brensch/coffee/hardware/controller/sim/REPORT.md

# Circuit simulation report

ngspice 42, behavioural models fitted to datasheet values (see `sim/run.py`). Generated by `python3 sim/run.py`.

| Block | Case | Result | Requirement | |
|---|---|---|---|---|
| Output on: voltage across the module input | heater SSR (Schneider SSP1A125BDT, 3.0 V), GPIO 2.64 V, vth_typ, +5V 4.65 V | 4.65 V | >= 3.0 V | ✅ |
| Output on: voltage across the module input | heater SSR (Schneider SSP1A125BDT, 3.0 V), GPIO 2.64 V, vth_typ, +5V 5.1 V | 5.1 V | >= 3.0 V | ✅ |
| Output on: voltage across the module input | heater SSR (Schneider SSP1A125BDT, 3.0 V), GPIO 2.64 V, vth_max, +5V 4.65 V | 4.65 V | >= 3.0 V | ✅ |
| Output on: voltage across the module input | heater SSR (Schneider SSP1A125BDT, 3.0 V), GPIO 2.64 V, vth_max, +5V 5.1 V | 5.1 V | >= 3.0 V | ✅ |
| Output on: voltage across the module input | heater SSR (Schneider SSP1A125BDT, 3.0 V), GPIO 3.3 V, vth_typ, +5V 4.65 V | 4.65 V | >= 3.0 V | ✅ |
| Output on: voltage across the module input | heater SSR (Schneider SSP1A125BDT, 3.0 V), GPIO 3.3 V, vth_typ, +5V 5.1 V | 5.1 V | >= 3.0 V | ✅ |
| Output on: voltage across the module input | heater SSR (Schneider SSP1A125BDT, 3.0 V), GPIO 3.3 V, vth_max, +5V 4.65 V | 4.65 V | >= 3.0 V | ✅ |
| Output on: voltage across the module input | heater SSR (Schneider SSP1A125BDT, 3.0 V), GPIO 3.3 V, vth_max, +5V 5.1 V | 5.1 V | >= 3.0 V | ✅ |
| Output off: current left through the module input | heater SSR (Schneider SSP1A125BDT, 3.0 V) | 0 mA | < 0.1 mA (SSR must-release ~1 mA) | ✅ |
| Output turn-off spike at the drain | heater SSR (Schneider SSP1A125BDT, 3.0 V) | 4.35 V | < 20 V (AO3400A 30 V rating; resistive SSR input, no flyback diode) | ✅ |
| Opto-triac LED current (MOC3083: IFT 5 mA max, IF 50 mA abs max) | GPIO 2.64 V, vth_typ, +5V 4.65 V, Vf 1.5 V max | 9.82 mA | >= 7.5 mA (1.5x IFT max) and <= 30 mA | ✅ |
| Opto-triac LED current (MOC3083: IFT 5 mA max, IF 50 mA abs max) | GPIO 2.64 V, vth_typ, +5V 5.1 V, Vf 1.5 V max | 11.1 mA | >= 7.5 mA (1.5x IFT max) and <= 30 mA | ✅ |
| Opto-triac LED current (MOC3083: IFT 5 mA max, IF 50 mA abs max) | GPIO 2.64 V, vth_max, +5V 4.65 V, Vf 1.5 V max | 9.82 mA | >= 7.5 mA (1.5x IFT max) and <= 30 mA | ✅ |
| Opto-triac LED current (MOC3083: IFT 5 mA max, IF 50 mA abs max) | GPIO 2.64 V, vth_max, +5V 5.1 V, Vf 1.5 V max | 11.1 mA | >= 7.5 mA (1.5x IFT max) and <= 30 mA | ✅ |
| Opto-triac LED current (MOC3083: IFT 5 mA max, IF 50 mA abs max) | GPIO 3.3 V, vth_typ, +5V 4.65 V, Vf 1.5 V max | 9.82 mA | >= 7.5 mA (1.5x IFT max) and <= 30 mA | ✅ |
| Opto-triac LED current (MOC3083: IFT 5 mA max, IF 50 mA abs max) | GPIO 3.3 V, vth_typ, +5V 5.1 V, Vf 1.5 V max | 11.1 mA | >= 7.5 mA (1.5x IFT max) and <= 30 mA | ✅ |
| Opto-triac LED current (MOC3083: IFT 5 mA max, IF 50 mA abs max) | GPIO 3.3 V, vth_max, +5V 4.65 V, Vf 1.5 V max | 9.82 mA | >= 7.5 mA (1.5x IFT max) and <= 30 mA | ✅ |
| Opto-triac LED current (MOC3083: IFT 5 mA max, IF 50 mA abs max) | GPIO 3.3 V, vth_max, +5V 5.1 V, Vf 1.5 V max | 11.1 mA | >= 7.5 mA (1.5x IFT max) and <= 30 mA | ✅ |
| Opto-triac LED off | FET off | 5.58e-10 mA | < 0.1 mA (far below any trigger) | ✅ |
| Output during reset (GPIO high-Z) | internal pull-up 45k vs 3.3k pull-down | 0.225 V | < 0.6 V (AO3400A Vth min 0.65 V): load stays off | ✅ |
| Output during reset: module input current | internal pull-up 45k | 3.81e-09 mA | < 0.1 mA (off) | ✅ |
| Output during reset (GPIO high-Z) | internal pull-up 20k vs 3.3k pull-down | 0.467 V | < 0.6 V (AO3400A Vth min 0.65 V): load stays off | ✅ |
| Output during reset: module input current | internal pull-up 20k | 3.81e-09 mA | < 0.1 mA (off) | ✅ |
| Output during reset, 100k pull-down (rejected value) | internal pull-up 45k | 2.28 V | reference only: why the pull-down is 3.3k | ✅ |
| Pump triac turn-off: peak voltage (reference) | 120 V, no snubber | 1.12e+03 V | info: why the snubber is fitted | ✅ |
| Valve triac (T410) turn-off: peak voltage (reference) | 120 V, no snubber | 2.89e+03 V | info: why the snubber is fitted | ✅ |
| Pump triac (T435) turn-off: peak voltage | 120 V, 100 R + 22 nF X2 | 169 V | < 480 V (80 % of the T435's 600 V) | ✅ |
| Pump triac turn-off: dV/dt | 120 V, 100 R + 22 nF X2 | 47 V/us | < 100 V/us (T435 static 400 V/us; MOC3083 static >= 600 V/us) | ✅ |
| Valve triac (T410-800B) turn-off: peak voltage | 120 V, 100 R + 22 nF X2 | 429 V | < 640 V (80 % of the T410-800B's 800 V; v49) | ✅ |
| Valve triac (T410) turn-off: dV/dt | 120 V, 100 R + 22 nF X2 | 23.2 V/us | < 32 V/us (80 % of the T410's 40 V/us; MOC3083 static >= 600 V/us) | ✅ |
| Pump triac turn-off: peak voltage (reference) | 132 V, no snubber | 1.12e+03 V | info: why the snubber is fitted | ✅ |
| Valve triac (T410) turn-off: peak voltage (reference) | 132 V, no snubber | 2.91e+03 V | info: why the snubber is fitted | ✅ |
| Pump triac (T435) turn-off: peak voltage | 132 V, 100 R + 22 nF X2 | 186 V | < 480 V (80 % of the T435's 600 V) | ✅ |
| Pump triac turn-off: dV/dt | 132 V, 100 R + 22 nF X2 | 47 V/us | < 100 V/us (T435 static 400 V/us; MOC3083 static >= 600 V/us) | ✅ |
| Valve triac (T410-800B) turn-off: peak voltage | 132 V, 100 R + 22 nF X2 | 456 V | < 640 V (80 % of the T410-800B's 800 V; v49) | ✅ |
| Valve triac (T410) turn-off: dV/dt | 132 V, 100 R + 22 nF X2 | 23.2 V/us | < 32 V/us (80 % of the T410's 40 V/us; MOC3083 static >= 600 V/us) | ✅ |
| Pump zero-cross re-arm (reference) | 120 V, after one stroke, no bleeder (v32) | 168 V | info: review M1 (no bleeder) and its re-review (100k marginal when running) | ✅ |
| Pump zero-cross re-arm (reference) | 120 V, after one stroke, 100k (first v33 value, rejected) | 1.09 V | info: review M1 (no bleeder) and its re-review (100k marginal when running) | ✅ |
| Pump zero-cross re-arm: triac voltage just before each positive zero crossing | 120 V, after one stroke, 51k bleeder (R54) | 0.0422 V | < 5 V (MOC3083 fires only under VINH: 12 V typ, 20 V max, no minimum) | ✅ |
| Pump zero-cross re-arm (reference) | 120 V, running every cycle, 100k (first v33 value, rejected) | 13.6 V | info: review M1 (no bleeder) and its re-review (100k marginal when running) | ✅ |
| Pump zero-cross re-arm: triac voltage just before each positive zero crossing | 120 V, running every cycle, 51k bleeder (R54) | 1.79 V | < 5 V (MOC3083 fires only under VINH: 12 V typ, 20 V max, no minimum) | ✅ |
| Pump zero-cross re-arm (reference) | 132 V, after one stroke, no bleeder (v32) | 185 V | info: review M1 (no bleeder) and its re-review (100k marginal when running) | ✅ |
| Pump zero-cross re-arm (reference) | 132 V, after one stroke, 100k (first v33 value, rejected) | 1.2 V | info: review M1 (no bleeder) and its re-review (100k marginal when running) | ✅ |
| Pump zero-cross re-arm: triac voltage just before each positive zero crossing | 132 V, after one stroke, 51k bleeder (R54) | 0.0423 V | < 5 V (MOC3083 fires only under VINH: 12 V typ, 20 V max, no minimum) | ✅ |
| Pump zero-cross re-arm (reference) | 132 V, running every cycle, 100k (first v33 value, rejected) | 13.2 V | info: review M1 (no bleeder) and its re-review (100k marginal when running) | ✅ |
| Pump zero-cross re-arm: triac voltage just before each positive zero crossing | 132 V, running every cycle, 51k bleeder (R54) | 1.82 V | < 5 V (MOC3083 fires only under VINH: 12 V typ, 20 V max, no minimum) | ✅ |
| Pump bleeder dissipation (R54, 2512 1 W) | 132 V, half-wave while the pump is off | 171 mW | < 250 mW (25 % of 1 W) | ✅ |
| Pump bleeder voltage (R54) | 132 V line peak (the triac's off-state voltage) | 187 V | < 400 V (80 % of the CRCW2512's 500 V) | ✅ |
| Valve triac (T410-800B) turn-off: peak voltage | 132 V, weaker coil: 6 H, 400 R (~57 mA) | 481 V | < 640 V (80 % of 800 V; the 600 V part's limit was 480 V) | ✅ |
| Valve triac (T410-800B) turn-off: dV/dt | 132 V, weaker coil: 6 H, 400 R (~57 mA) | 23.8 V/us | < 32 V/us (80 % of the T410's 40 V/us) | ✅ |
| Valve triac (T410-800B) turn-off: peak voltage | 132 V, weaker coil: 8 H, 500 R (~43 mA) | 510 V | < 640 V (80 % of 800 V; the 600 V part's limit was 480 V) | ✅ |
| Valve triac (T410-800B) turn-off: dV/dt | 132 V, weaker coil: 8 H, 500 R (~43 mA) | 24.2 V/us | < 32 V/us (80 % of the T410's 40 V/us) | ✅ |
| Valve triac (T410-800B) turn-off: peak voltage | 132 V, weaker coil: 12 H, 600 R (~29 mA) | 561 V | < 640 V (80 % of 800 V; the 600 V part's limit was 480 V) | ✅ |
| Valve triac (T410-800B) turn-off: dV/dt | 132 V, weaker coil: 12 H, 600 R (~29 mA) | 24.5 V/us | < 32 V/us (80 % of the T410's 40 V/us) | ✅ |
| Opto peak current through R49/R50 (200 R) | 132 V line peak, fired at the peak (dV/dt mis-fire) | 0.933 A | < 1 A (MOC3083 ITSM) | ✅ |
| Triac voltage needed to fire through the opto | Valve (T410, IGT 10 mA max), 200 R | 6.3 V | < 12 V (MOC3083 inhibit voltage, typ; the valve re-fires at every current zero; 330 R needed 7.6 V) | ✅ |
| Triac voltage needed to fire through the opto | Pump (T435, IGT 35 mA max), 200 R | 11.3 V | info: the pump fires on a rising line with the opto already latched, so the inhibit voltage doesn't limit it (330 R needed 15.9 V) | ✅ |
| Valve with a T435 instead (rejected) | 132 V, IH 35 mA, 100 R + 22 nF | 690 V | reference: over the 600 V rating, why the valve uses the T410 | ✅ |
| Snubber off-state leakage | 22 nF at 120 V 60 Hz | 0.995 mA | < 2 mA (valve hold-in needs ~50 mA; pump coil ignores it) | ✅ |
| Snubber discharge into the triac at turn-on | 170 V peak / 100 R | 1.7 A | < 31 A (T435 ITSM) and < 4 A di/dt-friendly | ✅ |
| Snubber resistor dissipation | steady off-state | 0.0991 mW | < 100 mW (2512 1 W) | ✅ |
| Pump triac (T435) junction temperature | pump 0.45 A rms half-wave (0.9 A peak) | 86.8 C | < 115 C (Tj max 125 C, 10 C margin) | ✅ |
| Pump triac (T435) junction temperature | pump, 1.4 A peak allowance | 97.3 C | < 115 C (Tj max 125 C, 10 C margin) | ✅ |
| Valve triac (T410) junction temperature | 0.1 A rms full-wave | 74.9 C | < 115 C | ✅ |
| IRM-10-5 load vs derating | 70 C: 50 % of 2 A = 1.0 A (Mean Well derating curve) | 0.45 A | <= 1.0 A (peak, Wi-Fi + both opto LEDs + heater SSR) | ✅ |
| LDO (TLV1117LV, SOT-223) junction temperature | 1.7 V x 150 mA average, ~100 C/W on its copper | 95.5 C | < 115 C (Tj max 125 C) | ✅ |
| Opto LED resistor dissipation (R47/R48, 0603) | 11 mA | 39.9 mW | < 50 mW (0603 100 mW, half derated at 70 C) | ✅ |
| Board fuse (F1, 2 A slow-blow) continuous load | IRM 0.12 A + pump 0.45 A + valve 0.1 A | 0.67 A | < 1.45 A (2 A x 0.75 x 0.97 rerating at 70 C) | ✅ |
| Thermocouple signal range | tip 170 C, board 20 C (K-type ~41 uV/C) | 6.15 mV | < 256 mV (MCP3421 PGA 8 full scale) | ✅ |
| Thermocouple open-probe reading | 10M bias vs ~281k ADC input (PGA 8) | 90.2 mV | > 15 mV (firmware: open probe) and < 256 mV (in range) | ✅ |
| Thermocouple bias error | 0.33 uA through a 20-ohm probe loop | 0.161 C | < 0.3 C (constant; calibration removes it) | ✅ |
| Status LED (red, 1k from GPIO16 / U0TXD) | 3.3 V | 1.3 mA | 1-3 mA (visible, well within GPIO drive) | ✅ |
| Front-panel switch closed | 1k series, 10k || 45k pull-up | 0.359 V | <= 0.5 V (C6 VIL max 0.25 x VDD = 0.825 V: >= 0.3 V margin) | ✅ |
| Front-panel switch wetting current | closed | 0.359 mA | >= 0.2 mA (keeps an old rocker's contacts clean) | ✅ |
| Front-panel LED drive | 330 R from a 3.3 V GPIO, red LED Vf ~2.0 V | 3.94 mA | 2-8 mA (bright, within the C6's 20 mA drive) | ✅ |
| Pressure input | 4.5 V full scale -> GPIO0 | 3.06 V | <= 3.1 V (inside the C6 ADC's 12 dB range, below the 3.3 V rail) | ✅ |
| Pressure input | 0.5 V (0 bar) -> GPIO0 | 0.34 V | >= 0.1 V (clear of the ADC's non-linear bottom) | ✅ |
| Pressure transducer load | R16 + R17 | 147 kOhm | > 100 kOhm (any 0.5-4.5 V voltage-output transducer; XIDIBEI drives ~10 mA) | ✅ |
| Pressure filter | -3 dB corner | 257 Hz | 150-400 Hz (keeps the pump's 60 Hz pulses, kills RF) | ✅ |
| Pressure filter | 60 Hz pump ripple | -0.296 dB | > -1 dB (the pulses stay visible to firmware) | ✅ |
| Pressure ADC kick-back (estimate) | 10 pF sample cap (assumed) vs 22 nF | 1.36 mV | < 2.7 mV (1/10 of the transducer's +-0.25 % FS at the pin) | ✅ |
| Pressure gain error from 1 % divider resistors | worst-case ratio | 0.0573 bar | < 0.15 bar at 9 bar (zero is calibrated at power-up) | ✅ |
| 3.3 V rail under Wi-Fi bursts | IRM-10-5 5.0 V | 3.29 V | >= 3.0 V (ESP32-C6 min) | ✅ |
| 5 V rail | IRM-10-5 5.0 V | 4.88 V | >= 4.2 V (info: on USB the transducer runs below the 4.75 V a 5 V part is usually specified for; readings indicative) | ✅ |
| 3.3 V rail under Wi-Fi bursts | IRM-10-5 4.9 V (-2 %) | 3.29 V | >= 3.0 V (ESP32-C6 min) | ✅ |
| 5 V rail | IRM-10-5 4.9 V (-2 %) | 4.78 V | >= 4.2 V (info: on USB the transducer runs below the 4.75 V a 5 V part is usually specified for; readings indicative) | ✅ |
| 3.3 V rail under Wi-Fi bursts | USB 5.0 V through D2 (~4.65 V) | 3.29 V | >= 3.0 V (ESP32-C6 min) | ✅ |
| 5 V rail | USB 5.0 V through D2 (~4.65 V) | 4.53 V | >= 4.2 V (info: on USB the transducer runs below the 4.75 V a 5 V part is usually specified for; readings indicative) | ✅ |

**88 / 88 checks pass.**
