brensch/coffee/hardware/controller/cosim/REPORT.md

# Co-simulation: firmware bits -> opto -> triac -> mains load

Source: `cosim_trace.csv` from `cosim_120v.scn` (the coffee-node engine, 120 V model): 32401 mains cycles; heater on 6866, pump on 1205, valve open 1784 cycles.

## Drive margins

- GPIO -> 150 R -> LED at the worst corner (VOH 2.64 V, pin 25.0 R, Vf 1.5 V): **I_F = 6.51 mA** vs IFT max 5 mA: OK
- heater (BTA24-800BW): the opto latches at ~5 V (inside its 20 V zero-cross window) and the gate reaches IGT 50 mA at **21.1 V** line, 7.9 deg into the half-cycle at 108 V: OK
- pump (BTA08-800BW): the opto latches at ~5 V (inside its 20 V zero-cross window) and the gate reaches IGT 50 mA at **21.1 V** line, 7.9 deg into the half-cycle at 108 V: OK
- valve (Z0109NN): the opto latches at ~5 V (inside its 20 V zero-cross window) and the gate reaches IGT 10 mA at **6.7 V** line, 2.5 deg into the half-cycle at 108 V: OK

## Heater (resistive, 1200 W)

| mains | f (Hz) | xtal ppm | latency | cycles cmd | half-cycles | +/- | runs off by >1 half | worst run DC (halves) | energy error |
|---|---|---|---|---|---|---|---|---|---|
| 108 | 59.95 | -10 | 20 us | 6866 | 13805 | 6901/6904 | 2 / 2703 | 1 | +0.62 % |
| 108 | 59.95 | +0 | 20 us | 6866 | 13803 | 6902/6901 | 2 / 2703 | 1 | +0.60 % |
| 108 | 59.95 | +10 | 300 us | 6866 | 13802 | 6901/6901 | 2 / 2703 | 1 | +0.59 % |
| 108 | 60.0 | -10 | 300 us | 6866 | 13732 | 6866/6866 | 0 / 2703 | 0 | +0.00 % |
| 108 | 60.0 | +0 | 20 us | 6866 | 13732 | 6866/6866 | 0 / 2703 | 0 | +0.00 % |
| 108 | 60.0 | +10 | 20 us | 6866 | 13732 | 6866/6866 | 0 / 2703 | 0 | +0.00 % |
| 108 | 60.05 | -10 | 300 us | 6866 | 13829 | 6912/6917 | 2 / 2703 | 1 | +0.62 % |
| 108 | 60.05 | +0 | 20 us | 6866 | 13827 | 6911/6916 | 2 / 2703 | 1 | +0.61 % |
| 108 | 60.05 | +10 | 300 us | 6866 | 13828 | 6912/6916 | 2 / 2703 | 1 | +0.62 % |
| 120 | 59.95 | -10 | 20 us | 6866 | 13796 | 6897/6899 | 2 / 2703 | 1 | +0.55 % |
| 120 | 59.95 | +0 | 20 us | 6866 | 13799 | 6901/6898 | 2 / 2703 | 1 | +0.57 % |
| 120 | 59.95 | +10 | 20 us | 6866 | 13801 | 6903/6898 | 2 / 2703 | 1 | +0.59 % |
| 120 | 60.0 | -10 | 20 us | 6866 | 13932 | 7066/6866 | 0 / 2703 | 1 | +1.46 % |
| 120 | 60.0 | +0 | 300 us | 6866 | 13732 | 6866/6866 | 0 / 2703 | 0 | +0.00 % |
| 120 | 60.0 | +10 | 300 us | 6866 | 13801 | 6866/6935 | 0 / 2703 | 1 | +0.50 % |
| 120 | 60.05 | -10 | 20 us | 6866 | 13816 | 6907/6909 | 2 / 2703 | 1 | +0.53 % |
| 120 | 60.05 | +0 | 300 us | 6866 | 13822 | 6911/6911 | 2 / 2703 | 1 | +0.57 % |
| 120 | 60.05 | +10 | 300 us | 6866 | 13821 | 6912/6909 | 2 / 2703 | 1 | +0.56 % |
| 132 | 59.95 | -10 | 20 us | 6866 | 13793 | 6899/6894 | 2 / 2703 | 1 | +0.53 % |
| 132 | 59.95 | +0 | 300 us | 6866 | 13795 | 6899/6896 | 2 / 2703 | 1 | +0.54 % |
| 132 | 59.95 | +10 | 300 us | 6866 | 13791 | 6895/6896 | 2 / 2703 | 1 | +0.51 % |
| 132 | 60.0 | -10 | 20 us | 6866 | 13763 | 6866/6897 | 0 / 2703 | 1 | +0.23 % |
| 132 | 60.0 | +0 | 300 us | 6866 | 13732 | 6866/6866 | 0 / 2703 | 0 | +0.00 % |
| 132 | 60.0 | +10 | 300 us | 6866 | 13732 | 6866/6866 | 0 / 2703 | 0 | +0.00 % |
| 132 | 60.05 | -10 | 300 us | 6866 | 13813 | 6905/6908 | 2 / 2703 | 1 | +0.51 % |
| 132 | 60.05 | +0 | 20 us | 6866 | 13809 | 6904/6905 | 2 / 2703 | 1 | +0.48 % |
| 132 | 60.05 | +10 | 300 us | 6866 | 13817 | 6908/6909 | 2 / 2703 | 1 | +0.54 % |

## Pump (Ulka, diode inside: one stroke per positive half-cycle)

| mains | f (Hz) | xtal ppm | cycles cmd | strokes | error | cycles with 0 / 1 / 2 strokes |
|---|---|---|---|---|---|---|
| 120 | 59.95 | -10 | 1205 | 1210 | +0.41 % | 59 / 1146 / 0 |
| 120 | 59.95 | +0 | 1205 | 1210 | +0.41 % | 7 / 1198 / 0 |
| 120 | 59.95 | +10 | 1205 | 1214 | +0.75 % | 62 / 1143 / 0 |
| 120 | 60.0 | -10 | 1205 | 1205 | +0.00 % | 0 / 1205 / 0 |
| 120 | 60.0 | +0 | 1205 | 1205 | +0.00 % | 0 / 1205 / 0 |
| 120 | 60.0 | +10 | 1205 | 1205 | +0.00 % | 0 / 1205 / 0 |
| 120 | 60.05 | -10 | 1205 | 1213 | +0.66 % | 55 / 1149 / 1 |
| 120 | 60.05 | +0 | 1205 | 1213 | +0.66 % | 5 / 1199 / 1 |
| 120 | 60.05 | +10 | 1205 | 1216 | +0.91 % | 61 / 1143 / 1 |

## Valve (inductive solenoid, 100 R + 8 nF snubber, 1 us backward-Euler ODE)

| mains | f (Hz) | opto t_on | coil I rms | DC / rms (skipped halves show as DC) | extra after release | turn-off dv/dt |
|---|---|---|---|---|---|---|
| 108 | 59.95 | 0 us | 133 mA | 0.0 % | 0 | 8.8 V/us |
| 108 | 59.95 | 5 us | 132 mA | 0.1 % | 0 | 8.7 V/us |
| 108 | 59.95 | 20 us | 119 mA | 0.1 % | 0 | 8.3 V/us |
| 120 | 59.95 | 0 us | 147 mA | 0.1 % | 0 | 8.8 V/us |
| 120 | 60.05 | 5 us | 147 mA | 0.1 % | 0 | 7.7 V/us |
| 120 | 60.05 | 20 us | 132 mA | 0.1 % | 0 | 4.5 V/us |
| 132 | 60.05 | 0 us | 162 mA | 0.1 % | 0 | 8.8 V/us |
| 132 | 59.95 | 5 us | 162 mA | 0.1 % | 0 | 8.6 V/us |
| 132 | 59.95 | 20 us | 145 mA | 0.1 % | 0 | 3.5 V/us |

## Verdict

- Heater energy error, worst corner: 1.46 %.
- Pump stroke-count error, worst corner: 0.91 %; commanded cycles with 0 or 2 strokes: 252 over all corners.
- Overall: **PASS**
