brensch/coffee/hardware/controller/build/jlc-120v-2side/report.md

# JLCPCB parts, 120 V board

Looked up live in JLCPCB's library. 'base' = basic part (no setup fee), 'expand' = extended (~$3 setup per part type). Check rotations in JLC's placement preview: footprint zero orientations differ between KiCad and JLC for some packages (SOT-223, USB-C, the ESP32 module).

| Refs | Value | JLC part | LCSC | library | stock | who |
|---|---|---|---|---|---|---|
| C3 | 10uF 25V X5R | CL21A106KAYNNNE | C15850 | base | 7586193 | JLC |
| C4 C8 C10 C11 | 100nF X7R | CC0603KRX7R9BB104 | C14663 | base | 37054978 | JLC |
| C5 | 1uF X5R | CL10A105KB8NNNC | C15849 | base | 12051593 | JLC |
| C6 C7 | 22uF 25V X5R | CL21A226MAQNNNE | C45783 | base | 3554401 | JLC |
| C9 | 22nF X7R | CL10B223KB8NNNC | C21122 | base | 854610 | JLC |
| D1 | red | KT-0603R | C2286 | base | 6705373 | JLC |
| D2 | B5819W | B5819W SL | C8598 | base | 803125 | JLC |
| D5 | 1N4148W | 1N4148W | C81598 | base | 3681312 | JLC |
| J1 | 5V in | SM03B-GHS-TB(LF)(SN) | C514175 | expand | 33212 | JLC |
| J2 | Heater | SM03B-GHS-TB(LF)(SN) | C514175 | expand | 33212 | JLC |
| J3 | Pump | SM03B-GHS-TB(LF)(SN) | C514175 | expand | 33212 | JLC |
| J4 | USB-C | TYPE-C-31-M-12 | C165948 | expand | 154346 | JLC |
| J5 | Thermistor | SM03B-GHS-TB(LF)(SN) | C514175 | expand | 33212 | JLC |
| J6 | Pressure | SM03B-GHS-TB(LF)(SN) | C514175 | expand | 33212 | JLC |
| J7 | Front panel | SM07B-GHS-TB(LF)(SN) | C495552 | expand | 26135 | JLC |
| J8 | Valve | SM03B-GHS-TB(LF)(SN) | C514175 | expand | 33212 | JLC |
| J10 | Scale | SM06B-GHS-TB(LF)(SN) | C133065 | expand | 20530 | JLC |
| Q1 Q2 Q3 | AO3400A | AO3400A | C20917 | base | 938699 | JLC |
| Q4 | AO3401A | AO3401A | C15127 | base | 1622342 | JLC |
| R4 R5 R6 | 3.3k | 0603WAF3301T5E | C22978 | base | 4833385 | JLC |
| R10 R11 R22 R23 R25 R26 R36 | 10k | 0603WAF1002T5E | C25804 | base | 44148883 | JLC |
| R12 R18 R19 R27 R29 | 1k | 0603WAF1001T5E | C21190 | base | 28279663 | JLC |
| R13 R14 | 5.1k | 0603WAF5101T5E | C23186 | base | 20602161 | JLC |
| R15 R20 R21 R28 | 4.7k | 0603WAF4701T5E | C23162 | base | 13794891 | JLC |
| R16 | 47k | 0603WAF4702T5E | C25819 | base | 2596167 | JLC |
| R17 | 100k | 0603WAF1003T5E | C25803 | base | 16705988 | JLC |
| R24 | 20k | 0603WAF2002T5E | C4184 | base | 5892313 | JLC |
| R30 R31 R32 | 330 | 0603WAF3300T5E | C23138 | base | 3009426 | JLC |
| R33 R34 R35 | 100 | 0603WAF1000T5E | C22775 | base | 8665419 | JLC |
| U4 | ESP32-C6-MINI-1U-H4 | ESP32-C6-MINI-1U-H4 | C20627095 | expand | 3845 | JLC |
| U5 | TLV1117LV33DCYR | TLV1117LV33DCYR | C15578 | expand | 1873 | JLC |
