brensch/coffee/hardware/controller/build/v45/jlc-120v-smd/report.md

# JLCPCB parts, 120 V board

Looked up live in JLCPCB's library. 'base' = basic part (no setup fee), 'expand' = extended (~$3 setup per part type). Check rotations in JLC's placement preview: footprint zero orientations differ between KiCad and JLC for some packages (SOT-223, USB-C, the ESP32 module).

| Refs | Value | JLC part | LCSC | library | stock | who |
|---|---|---|---|---|---|---|
| C3 | 10uF 25V X5R | CL21A106KAYNNNE | C15850 | base | 8505941 | JLC |
| C4 C11 C13 C14 | 100nF X7R | CC0603KRX7R9BB104 | C14663 | base | 33564562 | JLC |
| C5 C12 | 1uF X5R | CL10A105KB8NNNC | C15849 | base | 12786230 | JLC |
| C6 C7 | 22uF 25V X5R | CL21A226MAQNNNE | C45783 | base | 3523704 | JLC |
| C9 | 22nF X7R | CL10B223KB8NNNC | C21122 | base | 1067482 | JLC |
| C15 C16 | 22nF X2 | GA355DR7GB223KW01L | C437417 | expand | 7950 | JLC |
| D1 D3 D4 D5 D6 D7 D8 | red | KT-0603R | C2286 | base | 6536882 | JLC |
| D2 | B5819W | B5819W SL | C8598 | base | 845928 | JLC |
| F1 | 2A T | 0443002.DR | C187538 | expand | 851 | JLC |
| J2 | Heater SSR | SM04B-GHS-TB(LF)(SN) | C189895 | expand | 38947 | JLC |
| J4 | USB-C | TYPE-C-31-M-12 | C165948 | expand | 311780 | JLC |
| J5 | Thermocouple | MKDS 1,5/ 2-5,08 | C5183929 | expand | 4215 | hand |
| J6 | Pressure | SM03B-GHS-TB(LF)(SN) | C514175 | expand | 28401 | JLC |
| J7 | Front panel | SM06B-GHS-TB(LF)(SN) | C133065 | expand | 32944 | JLC |
| J10 | Scale | SM05B-GHS-TB(LF)(SN) | C189896 | expand | 25428 | JLC |
| J12 | N | 63824-1 | C575074 | expand | 12415 | hand |
| J13 | L | 63824-1 | C575074 | expand | 12415 | hand |
| J14 | P | 63824-1 | C575074 | expand | 12415 | hand |
| J15 | 3 | 63824-1 | C575074 | expand | 12415 | hand |
| PS1 | IRM-10-5 | IRM-10-5 | C2857903 | expand | 3763 | hand |
| Q1 Q2 Q3 | AO3400A | AO3400A | C20917 | base | 1047731 | JLC |
| Q5 | T435-600B | T435-600B-TR | C145128 | expand | 1678 | JLC |
| Q6 | T410-600B | T410-600B-TR | C2970064 | expand | 1320 | JLC |
| R4 R5 R6 | 3.3k | 0603WAF3301T5E | C22978 | base | 4814947 | JLC |
| R10 R20 R21 R25 R36 | 10k | 0603WAF1002T5E | C25804 | base | 47297724 | JLC |
| R11 R46 | 4.7k | 0603WAF4701T5E | C23162 | base | 15846872 | JLC |
| R12 R18 R19 R37 R38 R39 R40 R41 R42 R43 R44 | 1k | 0603WAF1001T5E | C21190 | base | 26645344 | JLC |
| R13 R14 | 5.1k | 0603WAF5101T5E | C23186 | base | 20252876 | JLC |
| R16 | 47k | 0603WAF4702T5E | C25819 | base | 2898427 | JLC |
| R17 | 100k | 0603WAF1003T5E | C25803 | base | 16062207 | JLC |
| R24 | 20k | 0603WAF2002T5E | C4184 | base | 5631395 | JLC |
| R30 R31 R32 R47 R48 | 330 | 0603WAF3300T5E | C23138 | base | 2762648 | JLC |
| R45 | 10M | 0603WAF1005T5E | C7250 | base | 841181 | JLC |
| R49 R50 | 330 | 1206W4F3300T5E | C17930 | expand | 193875 | JLC |
| R51 R52 | 100 1W | 25121WF1000T4E | C35218 | expand | 37863 | JLC |
| R53 | 1k | 1206W4F1001T5E | C4410 | base | 1590277 | JLC |
| R54 | 51k 500V | CRCW251251K0JNEG | C2078757 | expand | 880 | JLC |
| U4 | ESP32-C6-MINI-1U-H4 | ESP32-C6-MINI-1U-H4 | C20627095 | expand | 3623 | JLC |
| U5 | TLV1117LV33DCYR | TLV1117LV33DCYR | C15578 | expand | 1100 | JLC |
| U6 | MCP3421A0T-E/CH | MCP3421A0T-E/CH | C29454 | expand | 8540 | JLC |
| U7 | TMP117AIDRVR | TMP117AIDRVR | C699536 | expand | 23417 | JLC |
| U8 U9 | MOC3083SR2M | MOC3083SR2M | C111561 | expand | 16279 | JLC |
