brensch/coffee/hardware/controller/place.png

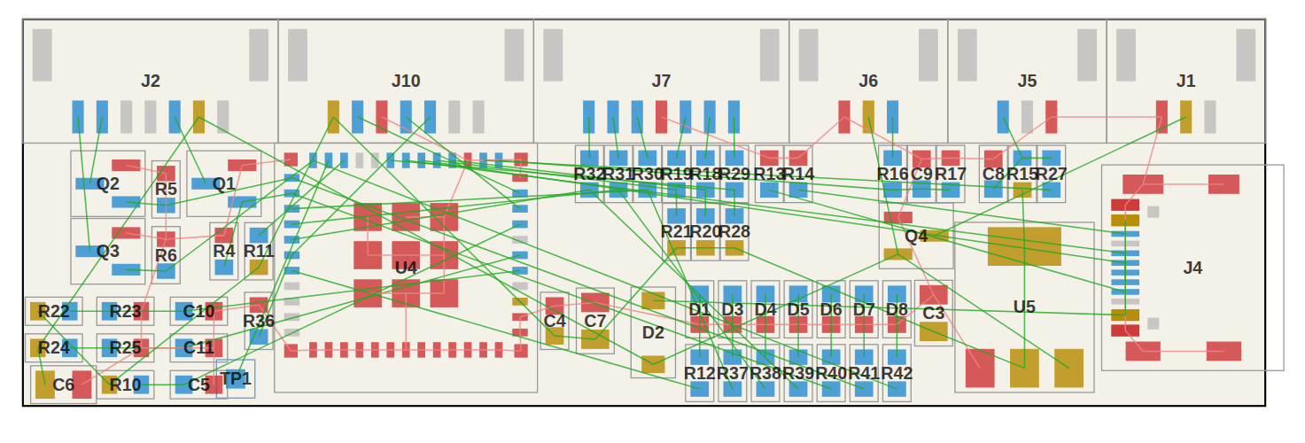
hardware/controller/place.png
