brensch/coffee/hardware/controller/versions/v5-simple-120v/board.png

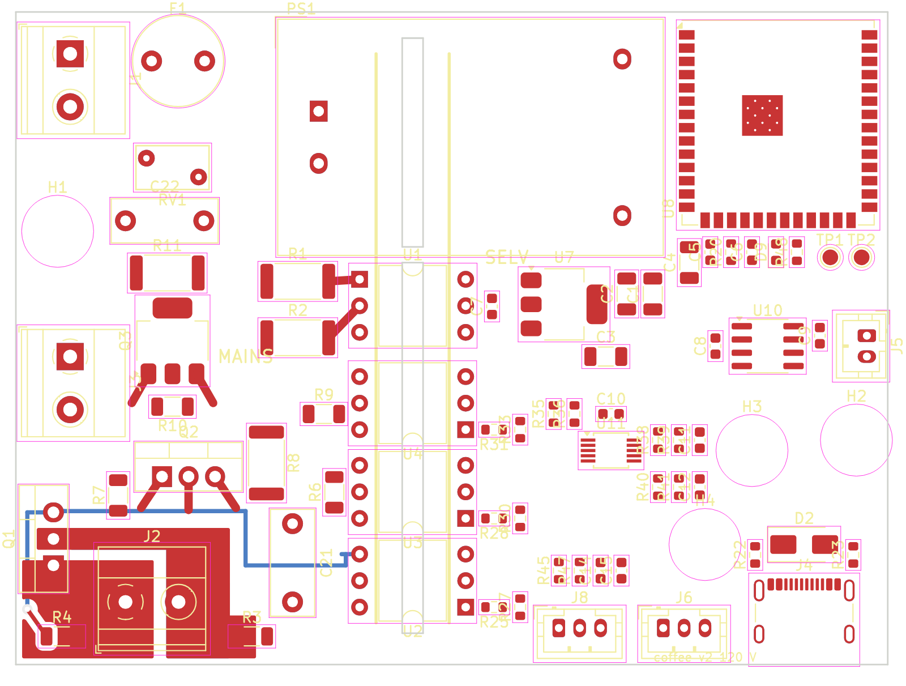
hardware/controller/versions/v5-simple-120v/board.png
