brensch/coffee/hardware/controller/versions/v27-led-panel/3d.png

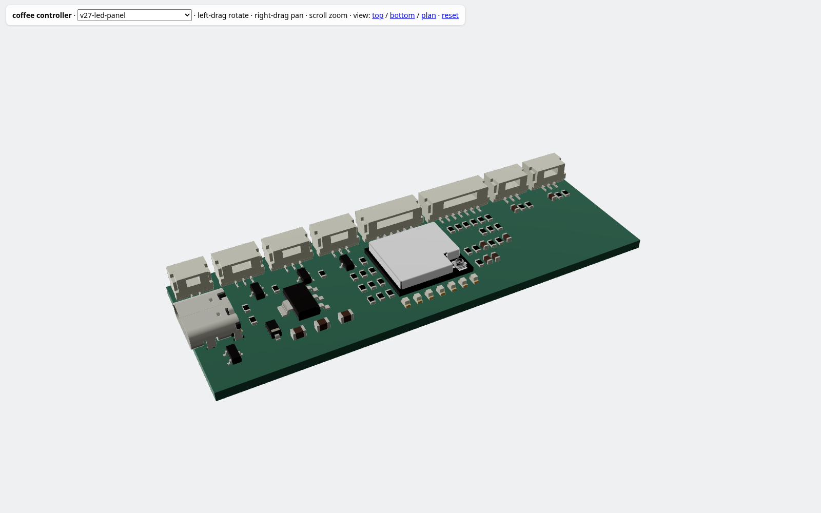
hardware/controller/versions/v27-led-panel/3d.png
