brensch/coffee/hardware/controller/versions/v27-led-panel/board.png

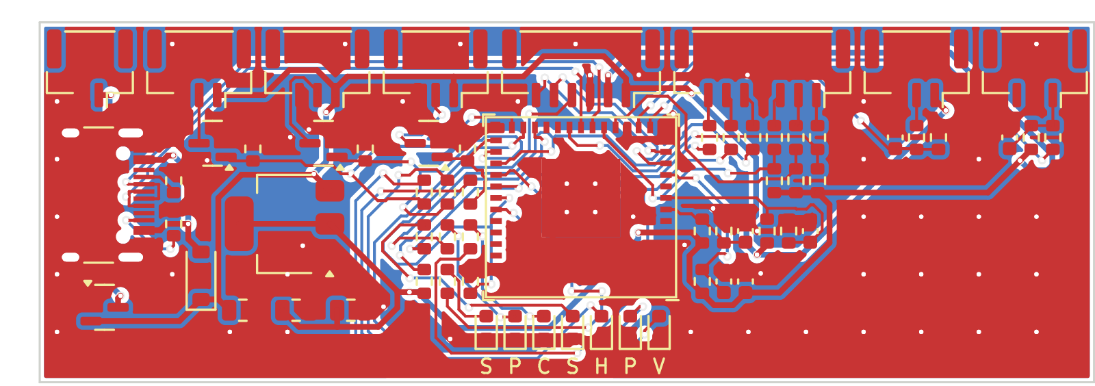
hardware/controller/versions/v27-led-panel/board.png
