brensch/coffee/hardware/controller/versions/v28-thin/board.png

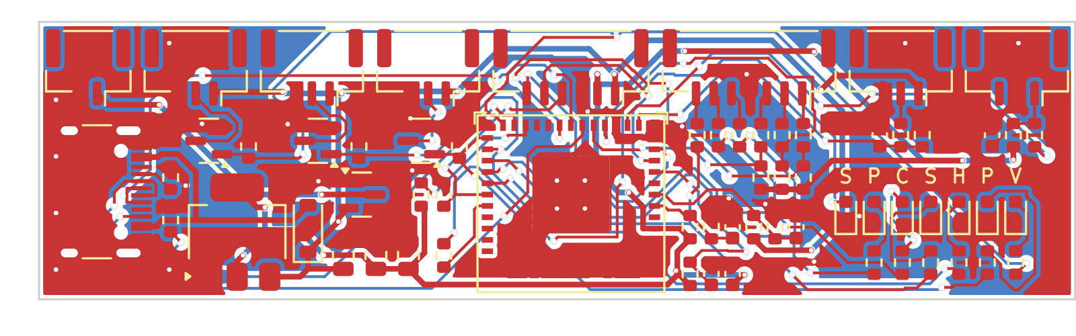
hardware/controller/versions/v28-thin/board.png
