brensch/coffee/hardware/controller/versions/v29-bundled/board.png

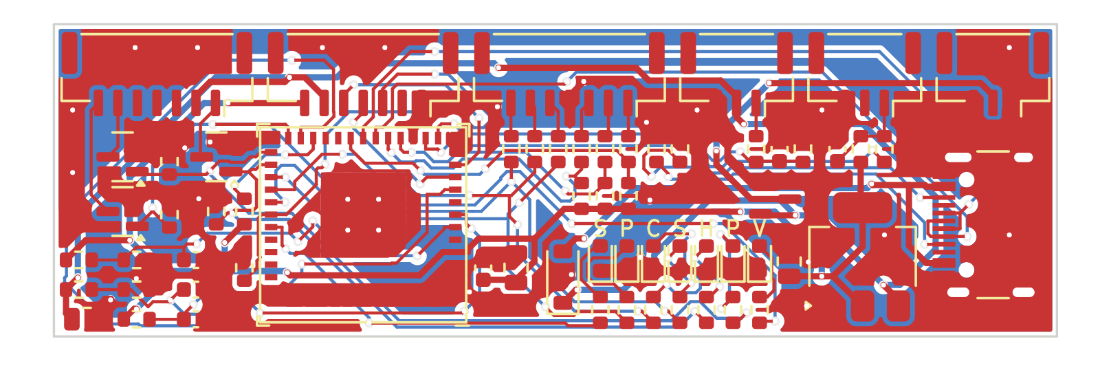
hardware/controller/versions/v29-bundled/board.png
