brensch/coffee/hardware/controller/versions/v30-swapsafe/board.png

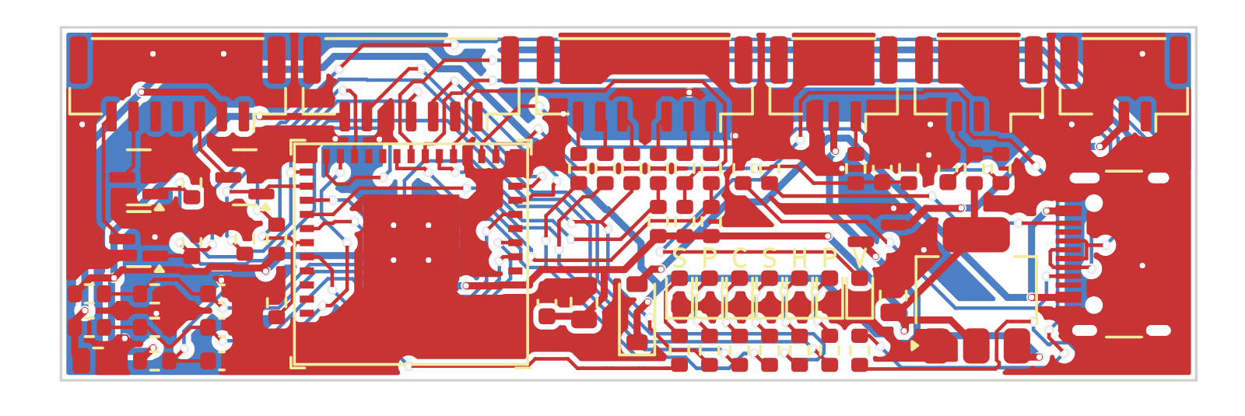
hardware/controller/versions/v30-swapsafe/board.png
