brensch/coffee/hardware/controller/versions/v31-thermocouple/3d.png

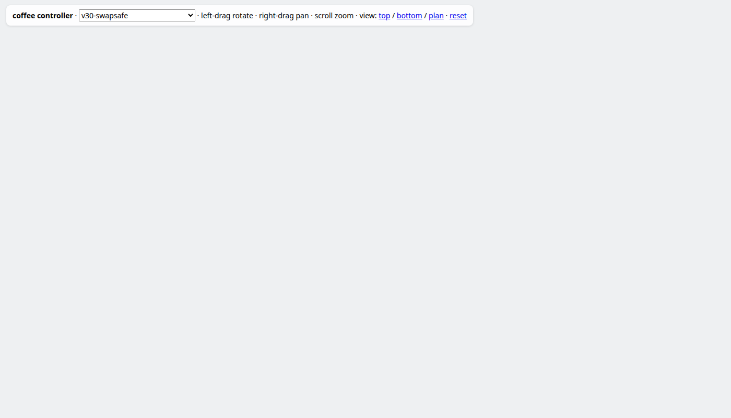
hardware/controller/versions/v31-thermocouple/3d.png
