brensch/coffee/hardware/controller/versions/v31-thermocouple/board.png

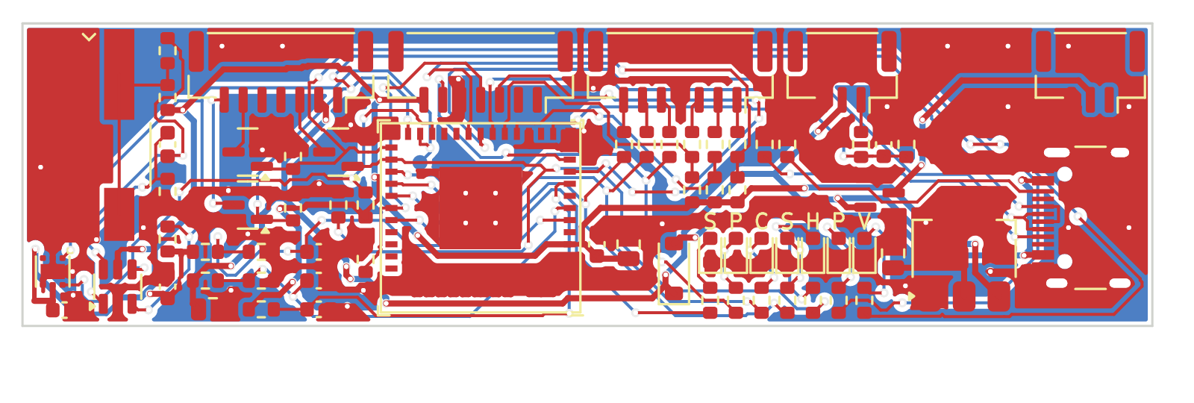
hardware/controller/versions/v31-thermocouple/board.png
