brensch/coffee/hardware/controller/versions/v32-mains/3d.png

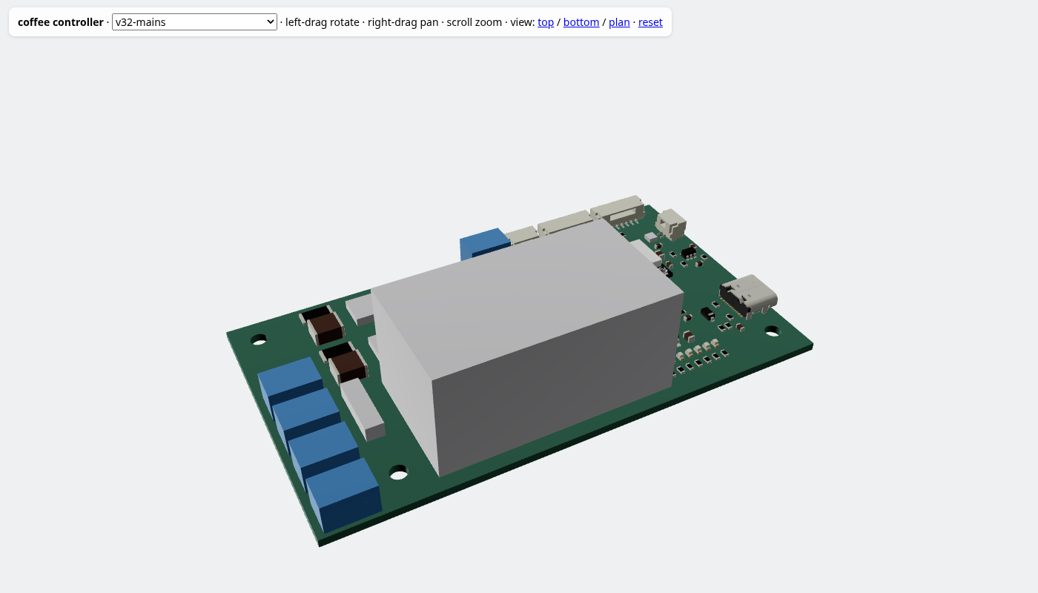
hardware/controller/versions/v32-mains/3d.png
