brensch/coffee/hardware/controller/versions/v32-mains/board.png

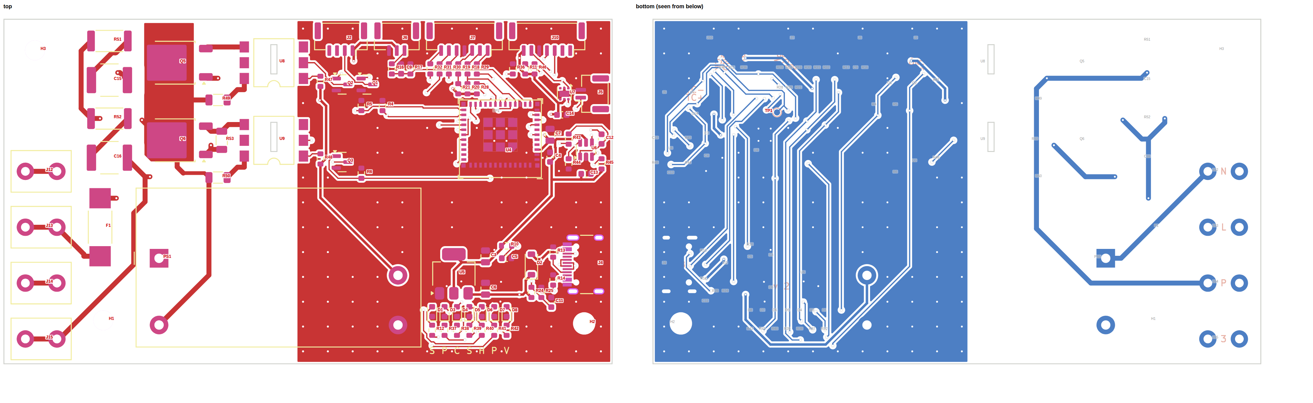
hardware/controller/versions/v32-mains/board.png
