brensch/coffee/hardware/controller/versions/v34-compact/3d.png

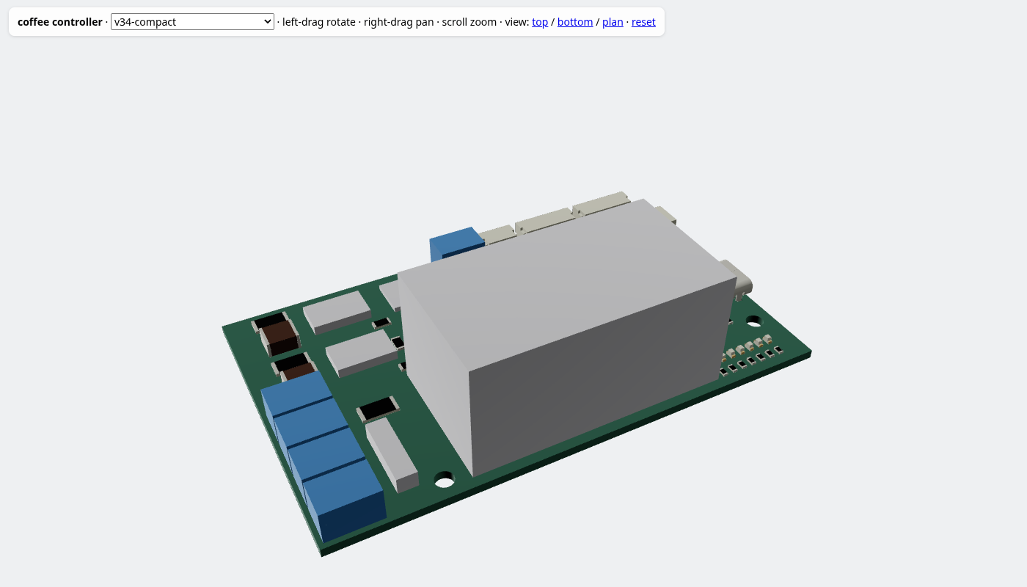
hardware/controller/versions/v34-compact/3d.png
