brensch/coffee/hardware/controller/versions/v34-compact/board.png

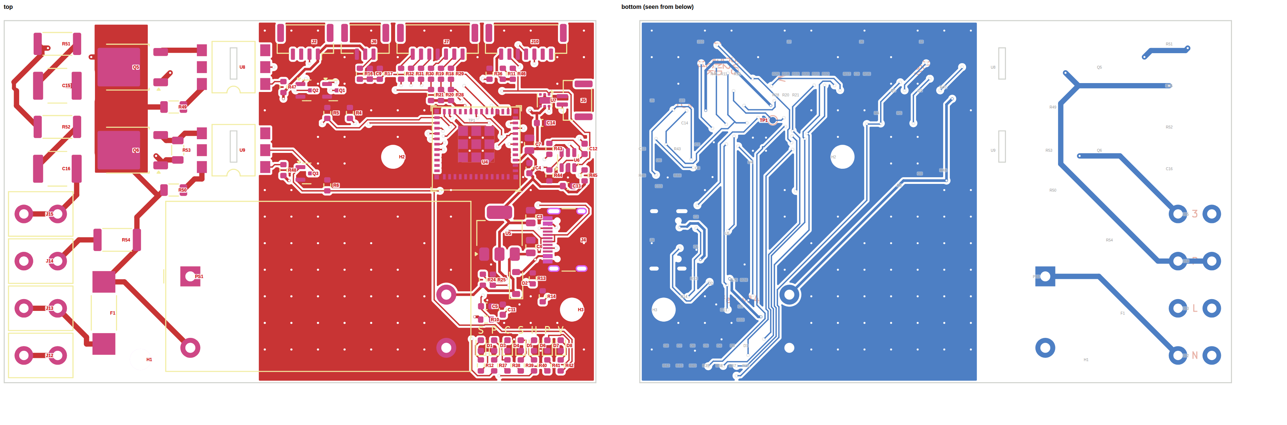
hardware/controller/versions/v34-compact/board.png
