brensch/coffee/hardware/controller/versions/v35-upright/3d.png

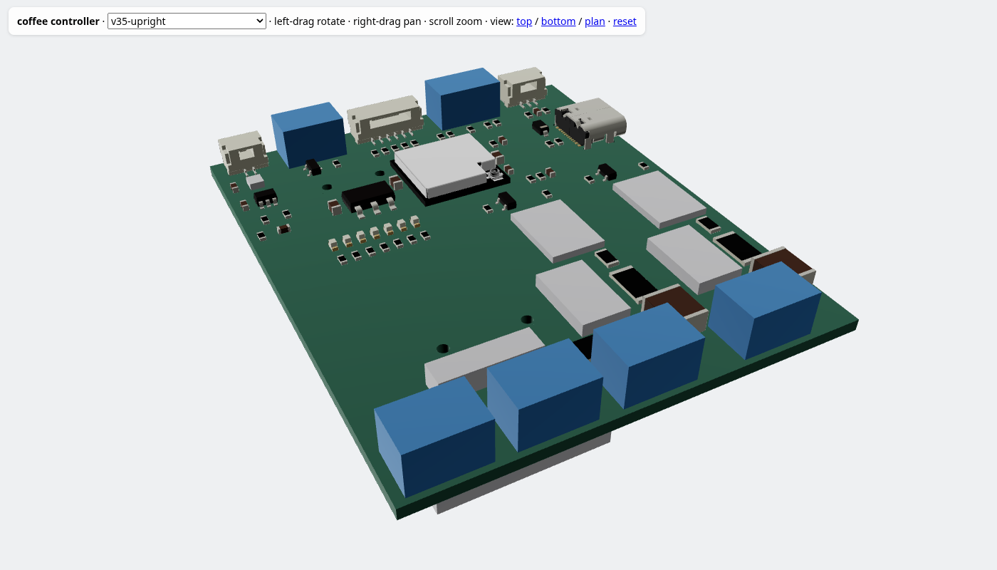
hardware/controller/versions/v35-upright/3d.png
