brensch/coffee/hardware/controller/versions/v35-upright/board.png

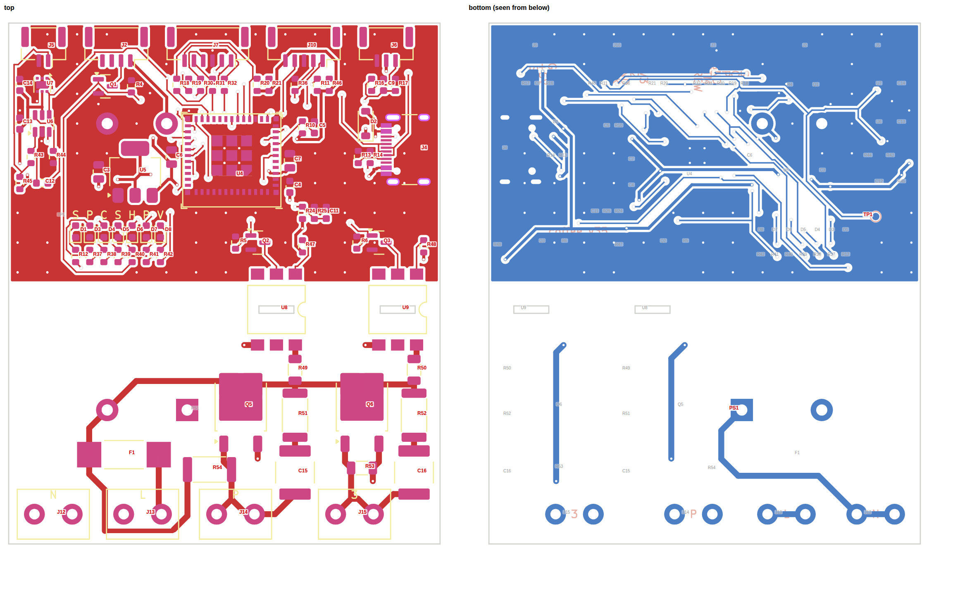
hardware/controller/versions/v35-upright/board.png
