brensch/coffee/hardware/controller/versions/v36-input-left/3d.png

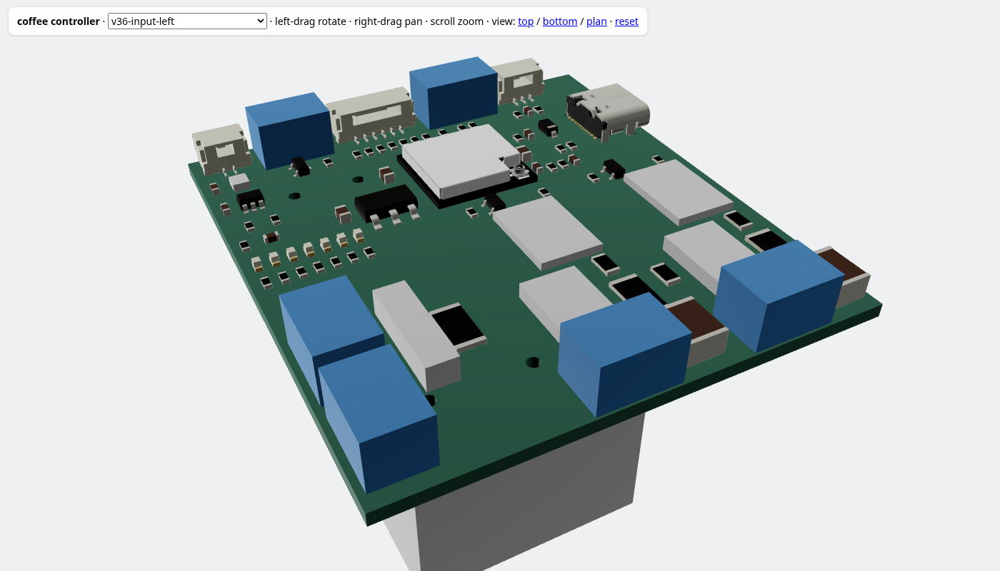
hardware/controller/versions/v36-input-left/3d.png
