brensch/coffee/hardware/controller/versions/v36-input-left/board.png

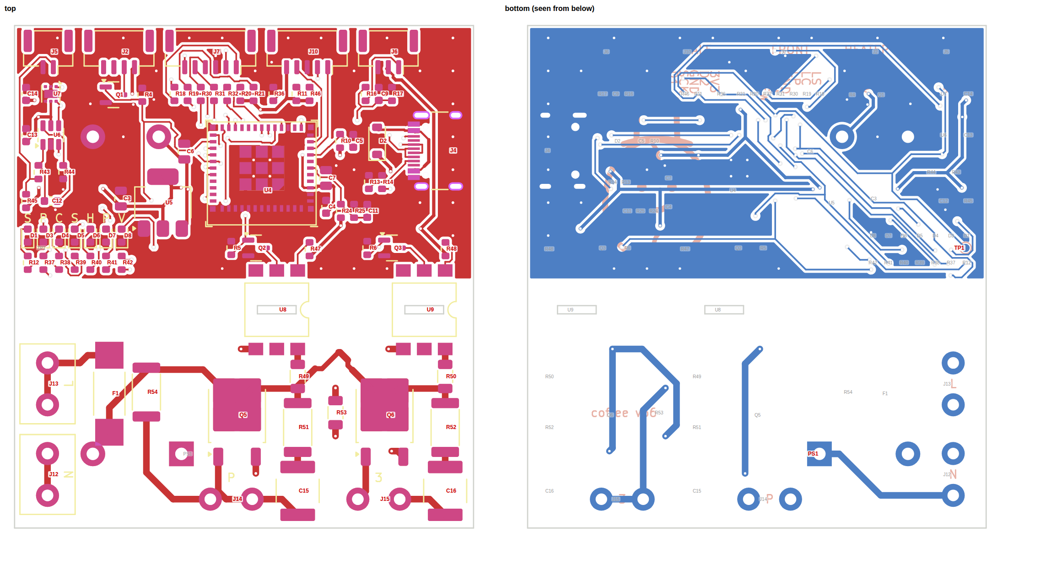
hardware/controller/versions/v36-input-left/board.png
