brensch/coffee/hardware/controller/versions/v37-polish/board.png

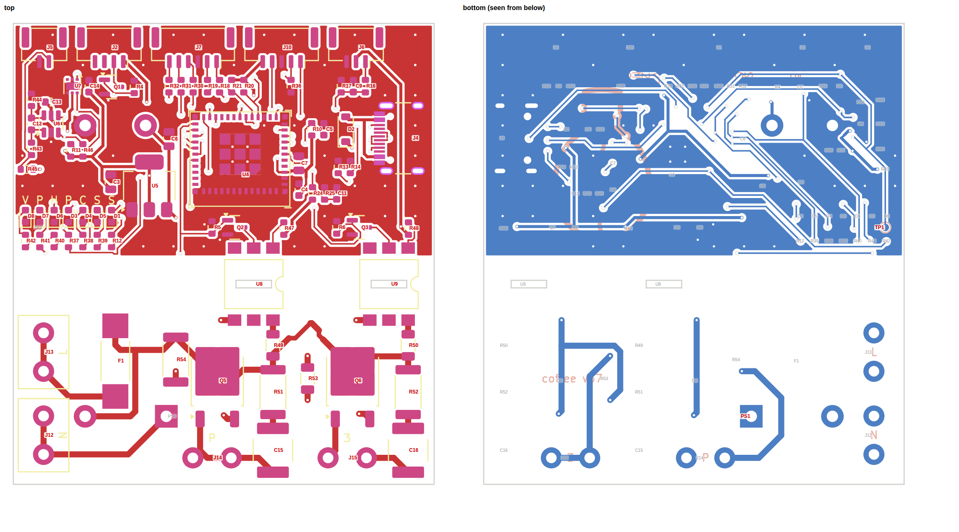
hardware/controller/versions/v37-polish/board.png
