brensch/coffee/hardware/controller/versions/v38-slide-in/3d.png

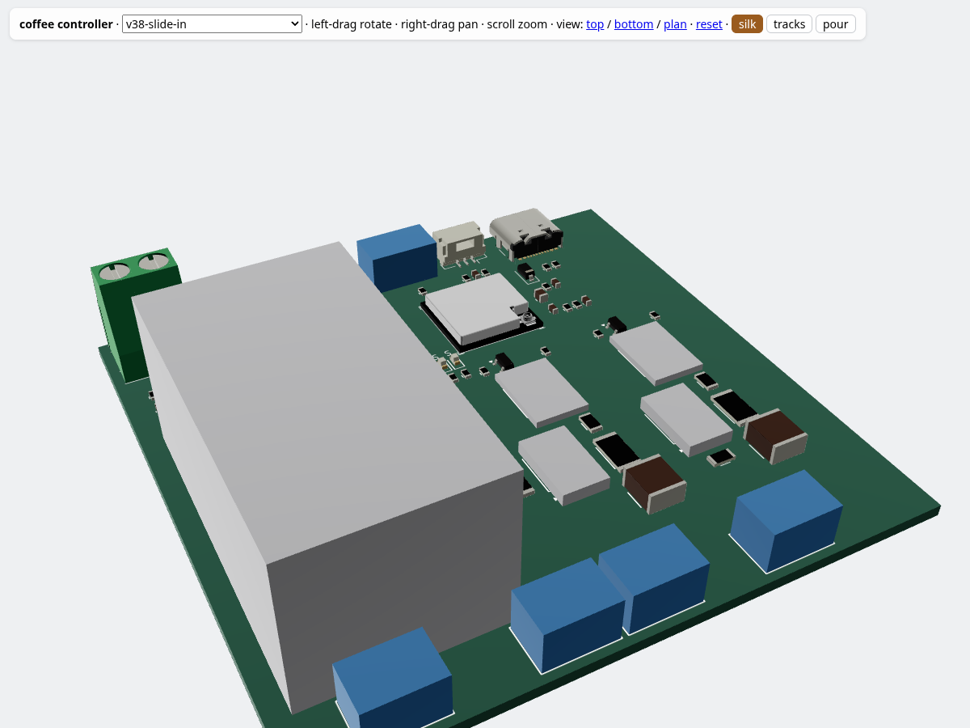
hardware/controller/versions/v38-slide-in/3d.png
