brensch/coffee/hardware/controller/versions/v38-slide-in/board.png

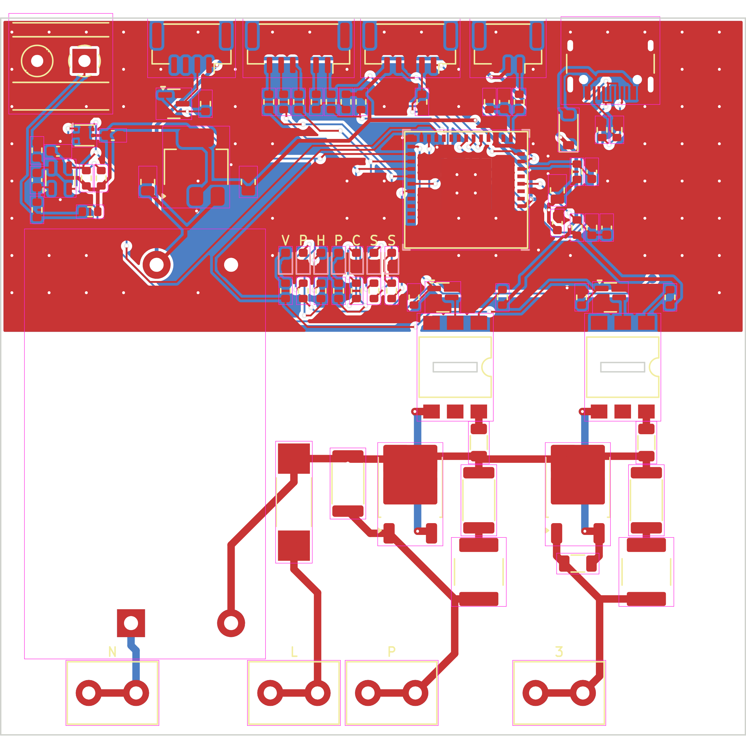
hardware/controller/versions/v38-slide-in/board.png
