brensch/coffee/hardware/controller/versions/v43-bar-cover/3d.png

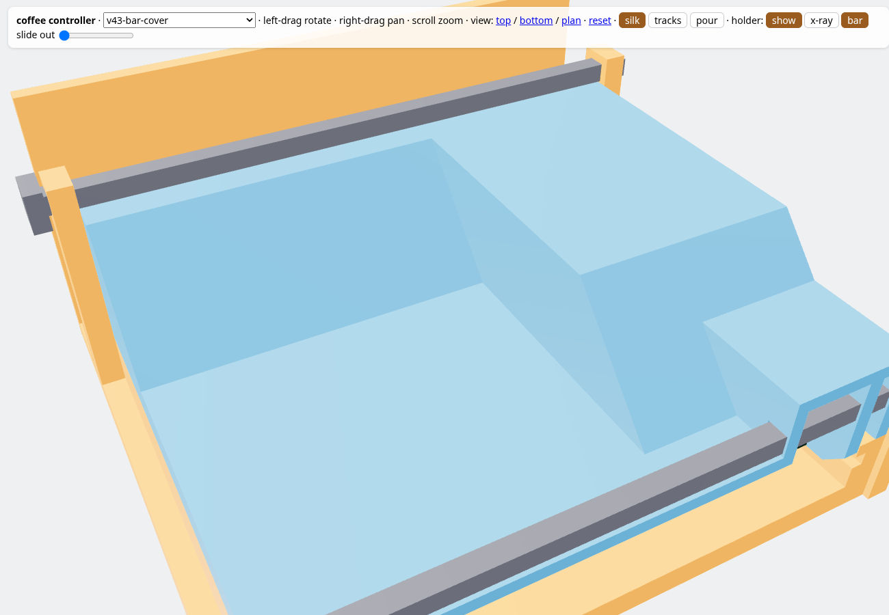
hardware/controller/versions/v43-bar-cover/3d.png
