brensch/coffee/hardware/controller/versions/v43-bar-cover/board.png

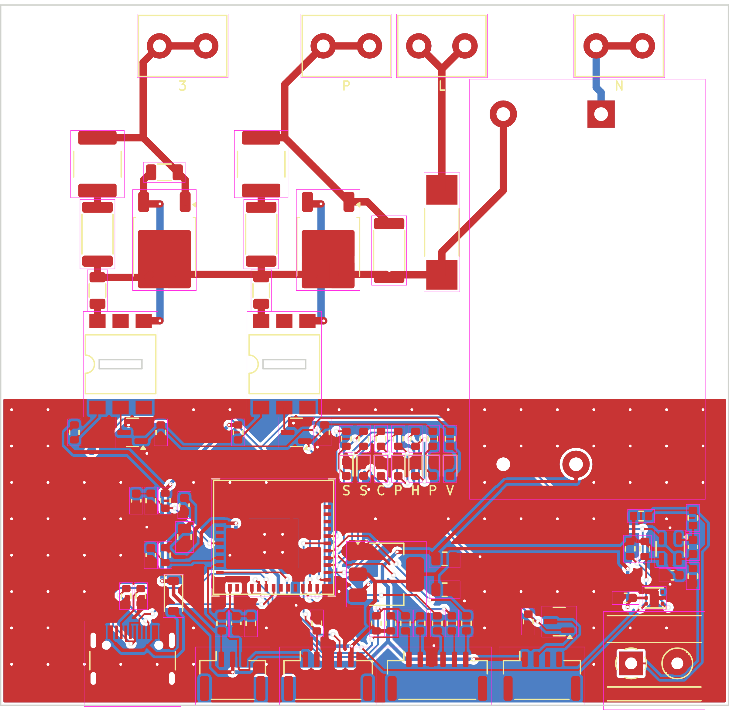
hardware/controller/versions/v43-bar-cover/board.png
