brensch/coffee/hardware/controller/versions/v44-flat-recess/3d.png

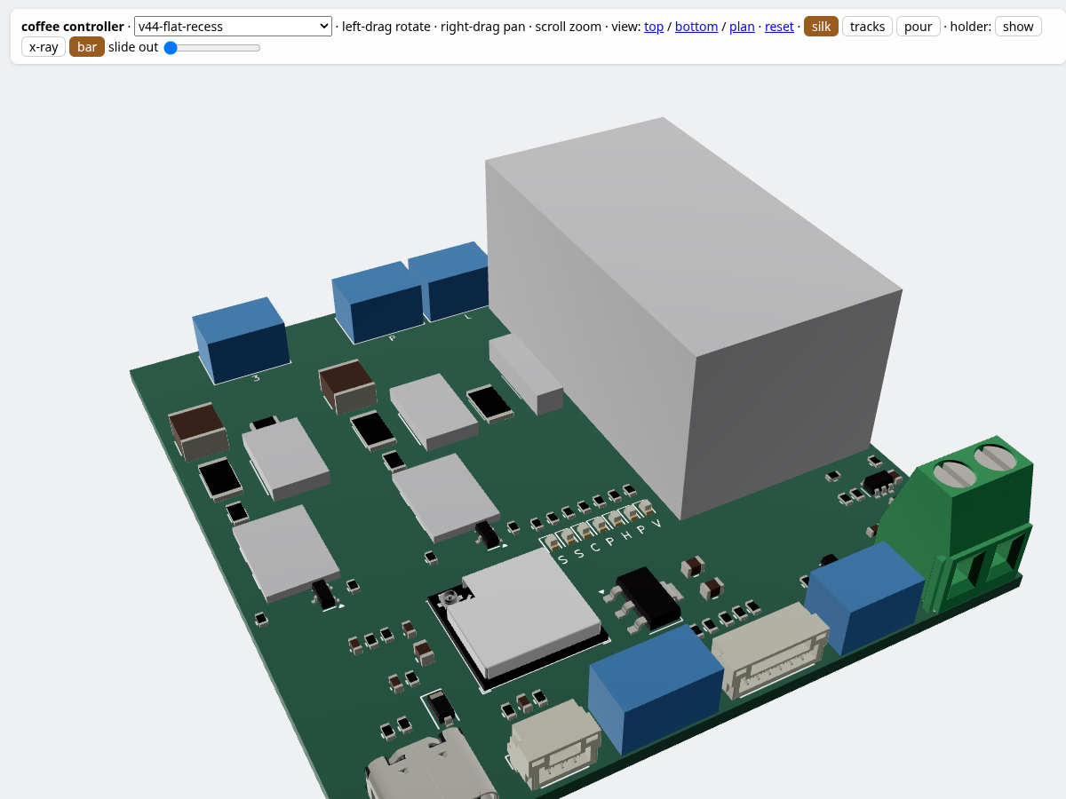
hardware/controller/versions/v44-flat-recess/3d.png
