brensch/coffee/hardware/controller/versions/v44-flat-recess/board.png

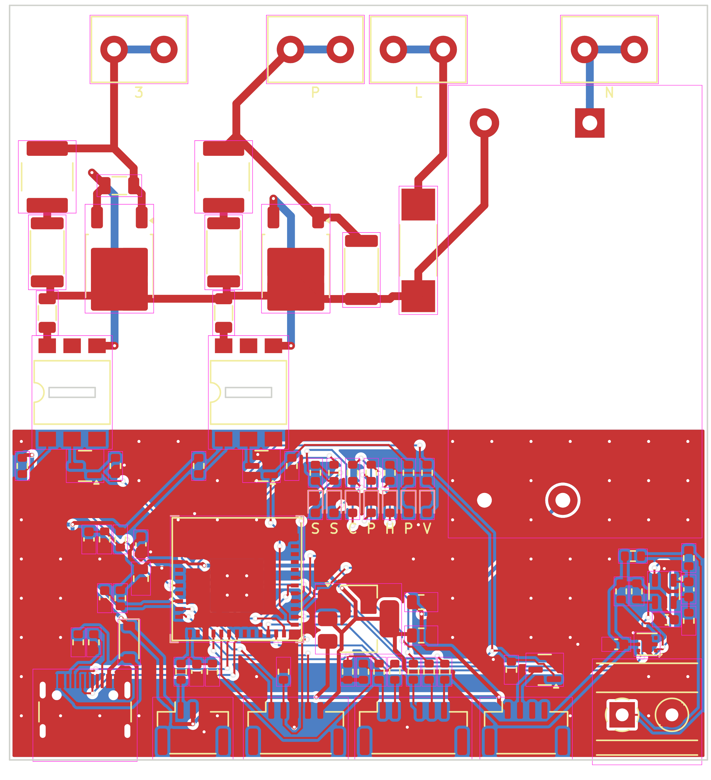
hardware/controller/versions/v44-flat-recess/board.png
