brensch/coffee/hardware/controller/versions/v49-valve-800v/3d.png

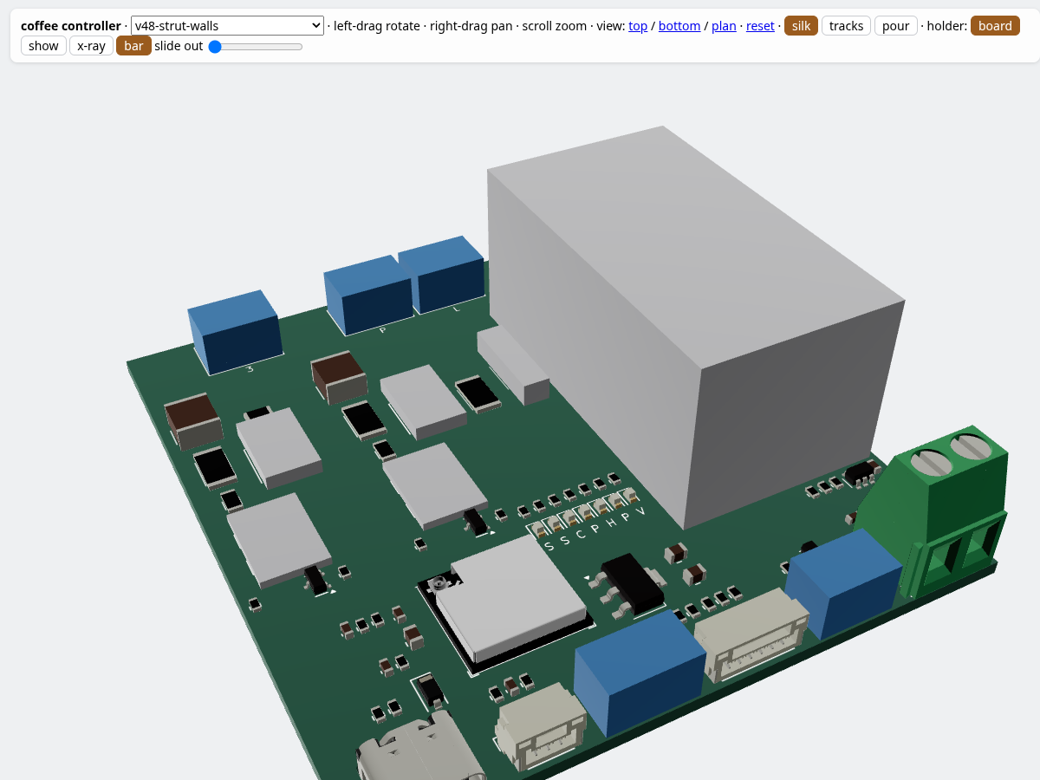
hardware/controller/versions/v49-valve-800v/3d.png
