brensch/coffee/hardware/controller/versions/v49-valve-800v/board.png

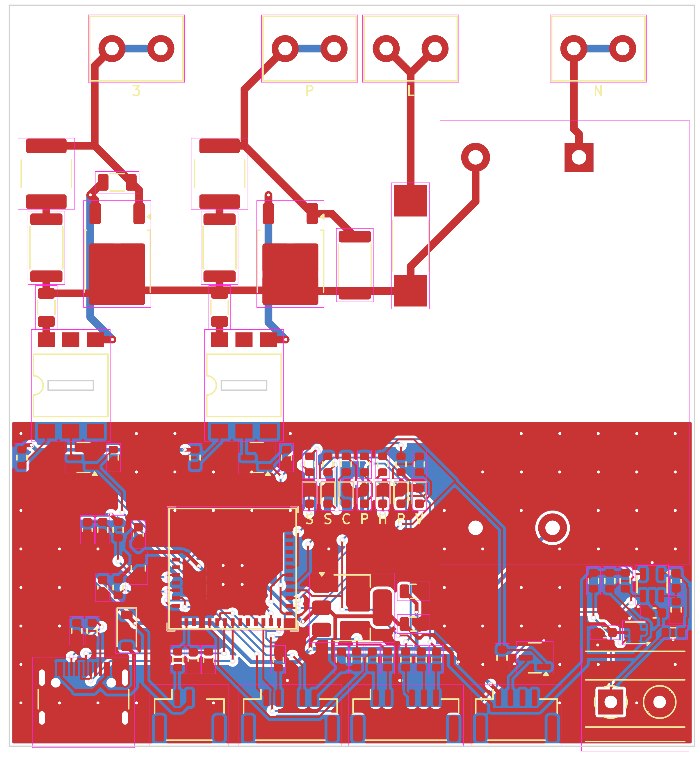
hardware/controller/versions/v49-valve-800v/board.png
