brensch/coffee/hardware/controller/versions/v49-valve-800v/holder/holder_bars_assembled.stl

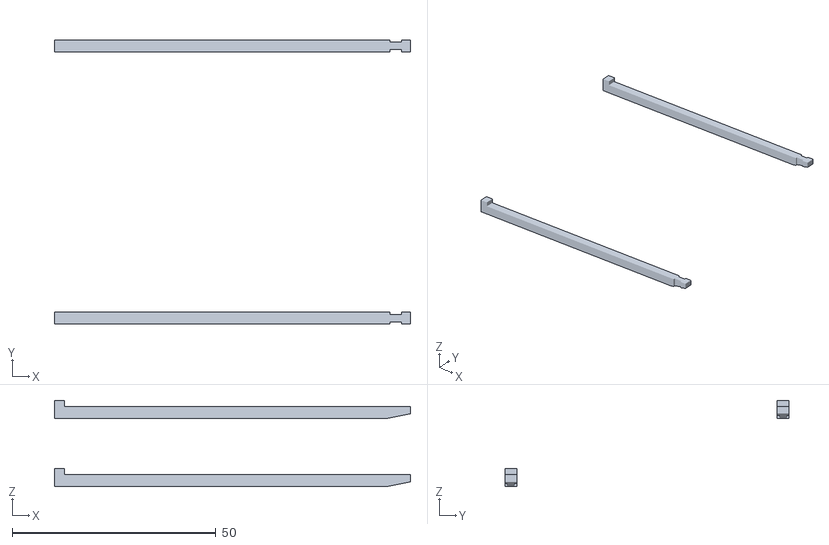
[picture p27: CAD file, 2026-11-09]
hardware/controller/versions/v49-valve-800v/holder/holder_bars_assembled.stl
87.3 x 69.7 x 21.2
