brensch/coffee/hardware/controller/versions/v27-led-panel/board.step

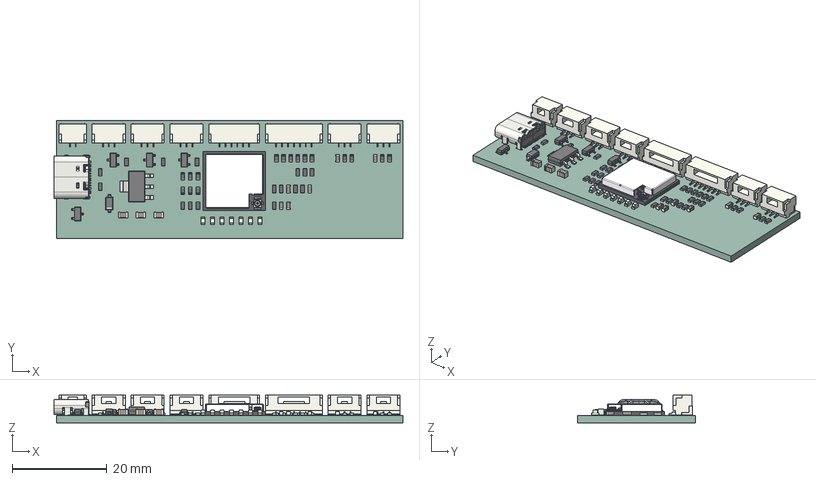
[picture p28: CAD file, 2026-11-05]
hardware/controller/versions/v27-led-panel/board.step
73.7 x 25.0 x 5.89 mm
JST_SM06B_GHS_TB
SOT_23 x 4
R_0603_1608Metric x 32
LED_0603_1608Metric x 7
JST_SM03B_GHS_TB x 5
C_0603_1608Metric x 6
JST_SM02B_GHS_TB
C_0805_2012Metric x 3
ESP32-C6-MINI-1U_V1_20230712
JST_SM07B_GHS_TB
D_SOD-123
USB_C_Receptacle_16P_TopMnt_Horizontal_GCT_USB4105-xx-A
SOT_223
_3d PCB
