brensch/coffee/hardware/controller/versions/v28-thin/board.step

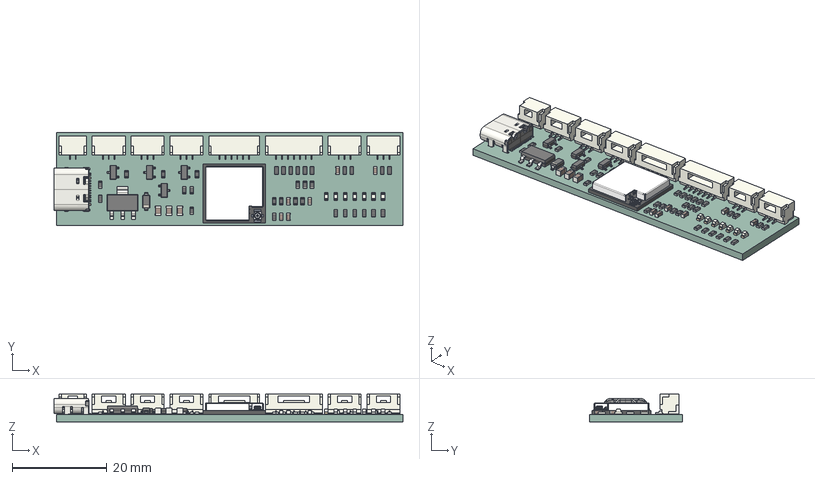
[picture p29: CAD file, 2026-11-05]
hardware/controller/versions/v28-thin/board.step
73.7 x 19.6 x 5.89 mm
R_0603_1608Metric x 32
ESP32-C6-MINI-1U_V1_20230712
C_0805_2012Metric x 3
LED_0603_1608Metric x 7
C_0603_1608Metric x 6
JST_SM03B_GHS_TB x 5
SOT_223
SOT_23 x 4
USB_C_Receptacle_16P_TopMnt_Horizontal_GCT_USB4105-xx-A
JST_SM02B_GHS_TB
JST_SM07B_GHS_TB
JST_SM06B_GHS_TB
D_SOD-123
_3d PCB
