brensch/coffee/hardware/controller/versions/v29-bundled/board.step

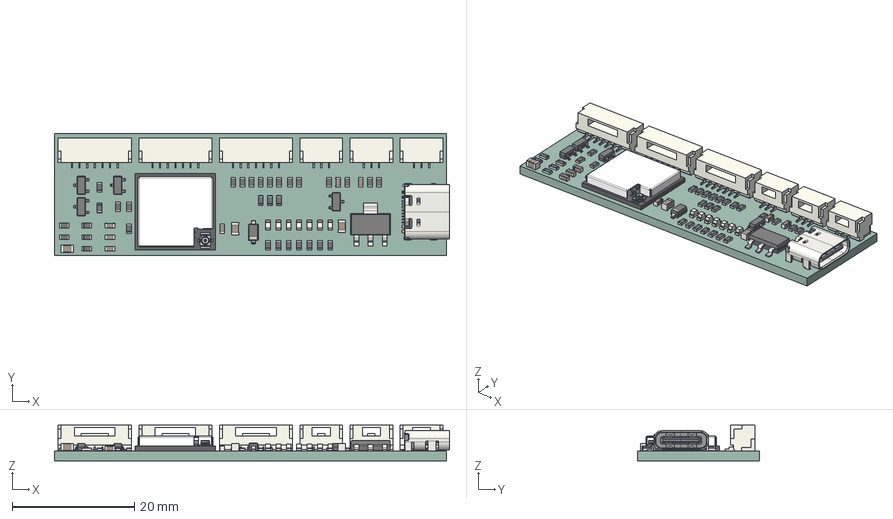
[picture p30: CAD file, 2026-11-05]
hardware/controller/versions/v29-bundled/board.step
64.7 x 20.0 x 5.89 mm
R_0603_1608Metric x 32
LED_0603_1608Metric x 7
JST_SM07B_GHS_TB x 3
SOT_23 x 4
C_0603_1608Metric x 6
C_0805_2012Metric x 3
JST_SM03B_GHS_TB x 3
SOT_223
ESP32-C6-MINI-1U_V1_20230712
D_SOD-123
USB_C_Receptacle_16P_TopMnt_Horizontal_GCT_USB4105-xx-A
_3d PCB
