brensch/coffee/hardware/controller/versions/v31-thermocouple/board.step

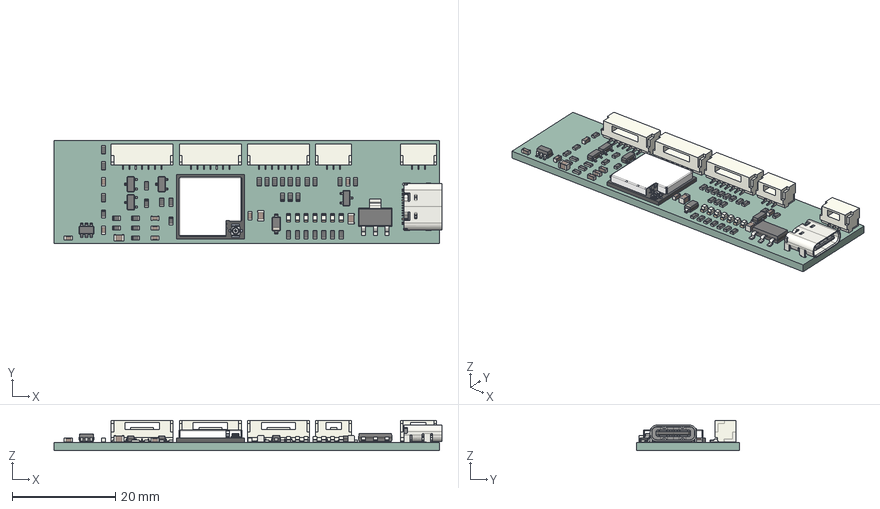
[picture p31: CAD file, 2026-11-06]
hardware/controller/versions/v31-thermocouple/board.step
75.2 x 20.0 x 5.89 mm
R_0603_1608Metric x 34
D_SOD-123
JST_SM07B_GHS_TB x 3
C_0805_2012Metric x 3
SOT_223
LED_0603_1608Metric x 7
SOT_23 x 4
C_0603_1608Metric x 8
SOT_23_6
JST_SM03B_GHS_TB x 2
USB_C_Receptacle_16P_TopMnt_Horizontal_GCT_USB4105-xx-A
ESP32-C6-MINI-1U_V1_20230712
_3d PCB
