brensch/coffee/hardware/controller/versions/v32-mains/board.step

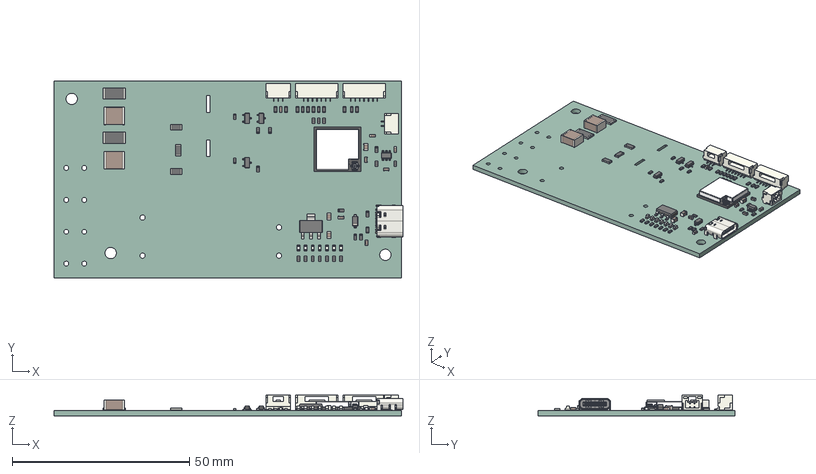
[picture p32: CAD file, 2026-11-06]
hardware/controller/versions/v32-mains/board.step
98.5 x 55.5 x 5.89 mm
SOT_223
LED_0603_1608Metric x 7
R_1206_3216Metric x 3
R_0603_1608Metric x 34
D_SOD-123
C_0603_1608Metric x 7
R_2512_6332Metric x 2
C_0805_2012Metric x 3
JST_SM03B_GHS_TB
SOT_23 x 3
ESP32-C6-MINI-1U_V1_20230712
USB_C_Receptacle_16P_TopMnt_Horizontal_GCT_USB4105-xx-A
C_2220_5750Metric x 2
SOT_23_6
JST_SM07B_GHS_TB x 2
JST_SM02B_GHS_TB
_3d PCB
