brensch/coffee/hardware/controller/versions/v34-compact/board.step

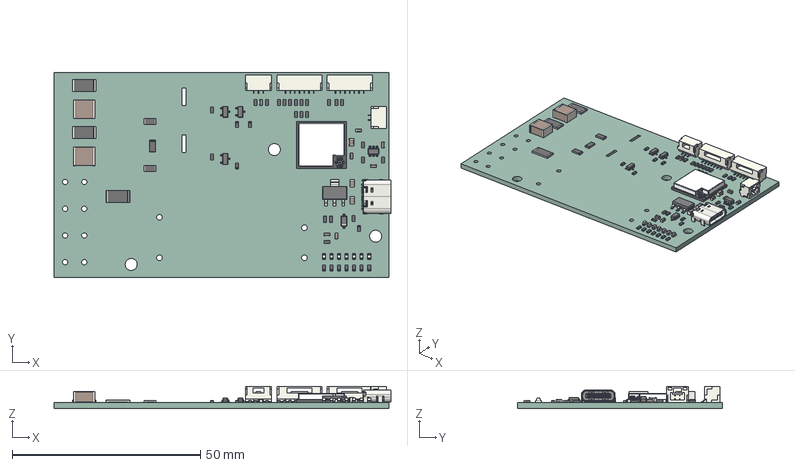
[picture p33: CAD file, 2026-11-06]
hardware/controller/versions/v34-compact/board.step
89.5 x 54.5 x 5.89 mm
JST_SM03B_GHS_TB
LED_0603_1608Metric x 7
SOT_23 x 3
R_0603_1608Metric x 34
SOT_23_6
JST_SM07B_GHS_TB x 2
C_0603_1608Metric x 7
C_2220_5750Metric x 2
R_2512_6332Metric x 3
C_0805_2012Metric x 3
D_SOD-123
JST_SM02B_GHS_TB
R_1206_3216Metric x 3
USB_C_Receptacle_16P_TopMnt_Horizontal_GCT_USB4105-xx-A
SOT_223
ESP32-C6-MINI-1U_V1_20230712
_3d PCB
