brensch/coffee/hardware/controller/versions/v36-input-left/board.step

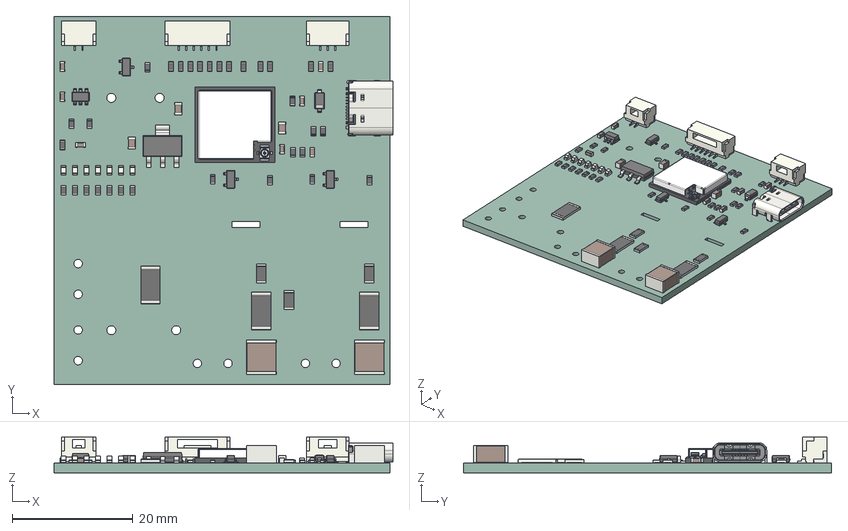
[picture p35: CAD file, 2026-11-06]
hardware/controller/versions/v36-input-left/board.step
56.2 x 61.0 x 5.89 mm
R_0603_1608Metric x 32
SOT_223
C_0603_1608Metric x 7
LED_0603_1608Metric x 7
C_0805_2012Metric x 3
R_2512_6332Metric x 3
SOT_23 x 3
JST_SM06B_GHS_TB
JST_SM02B_GHS_TB
SOT_23_6
C_2220_5750Metric x 2
ESP32-C6-MINI-1U_V1_20230712
R_1206_3216Metric x 3
USB_C_Receptacle_16P_TopMnt_Horizontal_GCT_USB4105-xx-A
JST_SM03B_GHS_TB
D_SOD-123
_3d PCB
