brensch/coffee/hardware/controller/versions/v38-slide-in/board.step

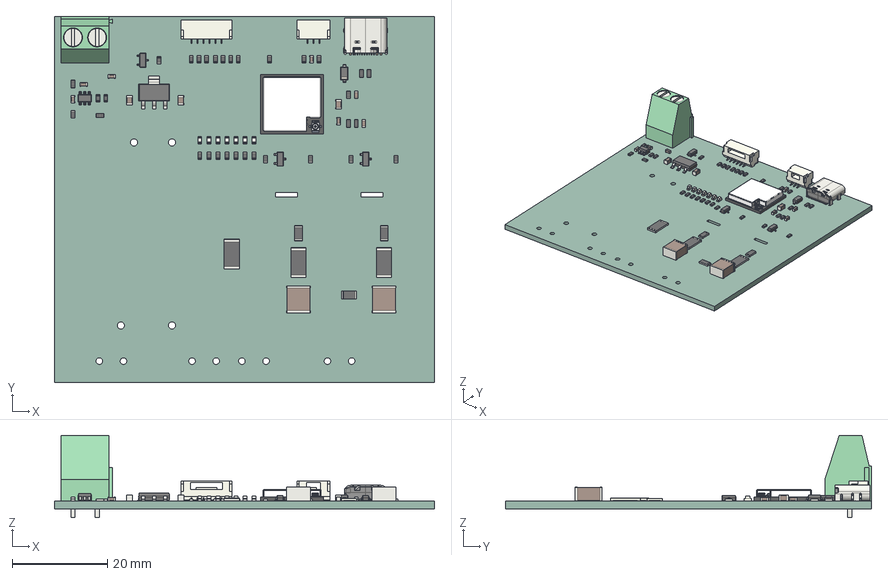
[picture p36: CAD file, 2026-11-07]
hardware/controller/versions/v38-slide-in/board.step
80.0 x 77.0 x 17.3 mm
R_0603_1608Metric x 32
C_0603_1608Metric x 7
TerminalBlock_Phoenix_MKDS_15_2_508_1x02_P508mm_Horizontal
LED_0603_1608Metric x 7
C_0805_2012Metric x 3
ESP32-C6-MINI-1U_V1_20230712
R_1206_3216Metric x 3
R_2512_6332Metric x 3
USB_C_Receptacle_16P_TopMnt_Horizontal_GCT_USB4105-xx-A
SOT_23_6
D_SOD-123
C_2220_5750Metric x 2
JST_SM06B_GHS_TB
SOT_23 x 3
JST_SM03B_GHS_TB
SOT_223
_3d PCB
