brensch/coffee/hardware/controller/versions/v39-front-plate/holder/holder.step

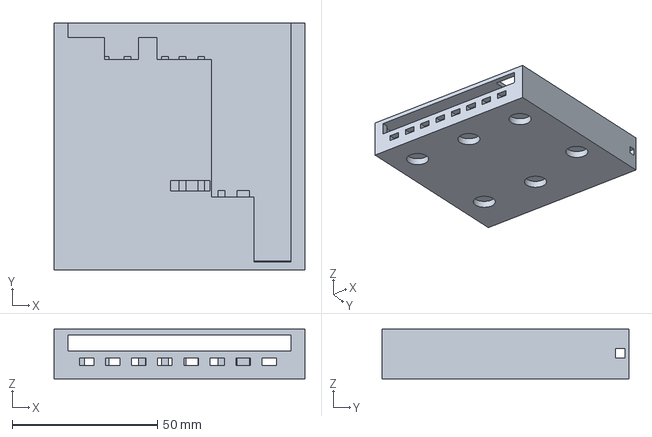
[picture p37: CAD file, 2026-11-07]
hardware/controller/versions/v39-front-plate/holder/holder.step
86.5 x 85.0 x 17.1 mm
