brensch/coffee/hardware/controller/versions/v40-roof-holder/holder/holder_peg.step

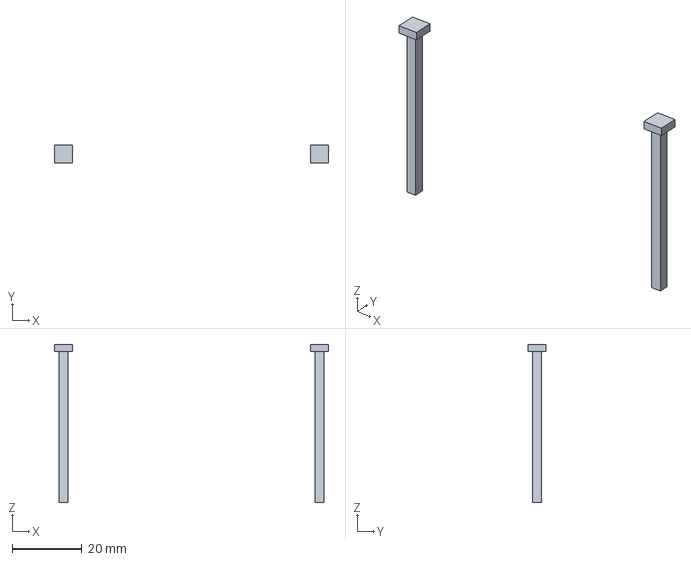
[picture p38: CAD file, 2026-11-09]
hardware/controller/versions/v40-roof-holder/holder/holder_peg.step
78.4 x 5.20 x 45.3 mm
