brensch/coffee/hardware/controller/versions/v49-valve-800v/holder/holder_cover.step

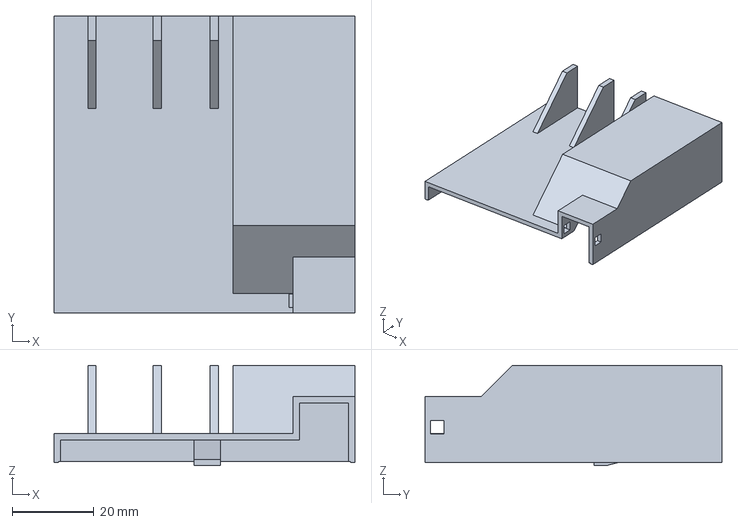
[picture p40: CAD file, 2026-11-09]
hardware/controller/versions/v49-valve-800v/holder/holder_cover.step
73.8 x 72.8 x 24.6 mm
