brensch/coffee/hardware/controller/versions/v39-front-plate/holder/holder_bar.step

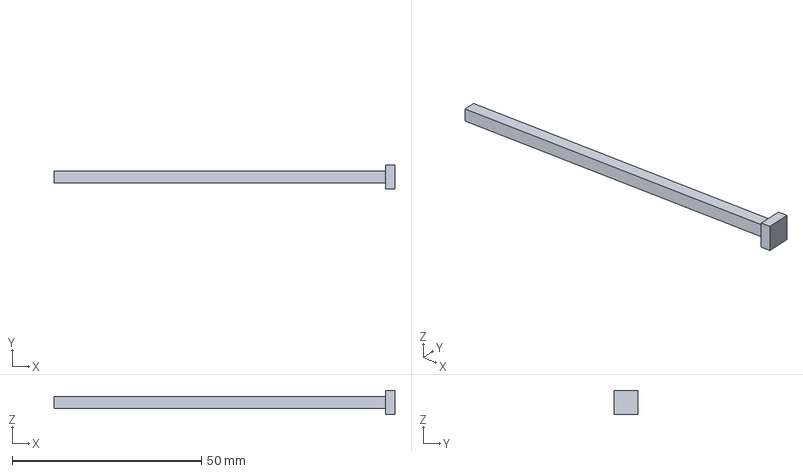
[picture p41: CAD file, 2026-11-07]
hardware/controller/versions/v39-front-plate/holder/holder_bar.step
90.0 x 6.40 x 6.40 mm
