brensch/coffee/hardware/controller/versions/v40-roof-holder/holder/holder.step

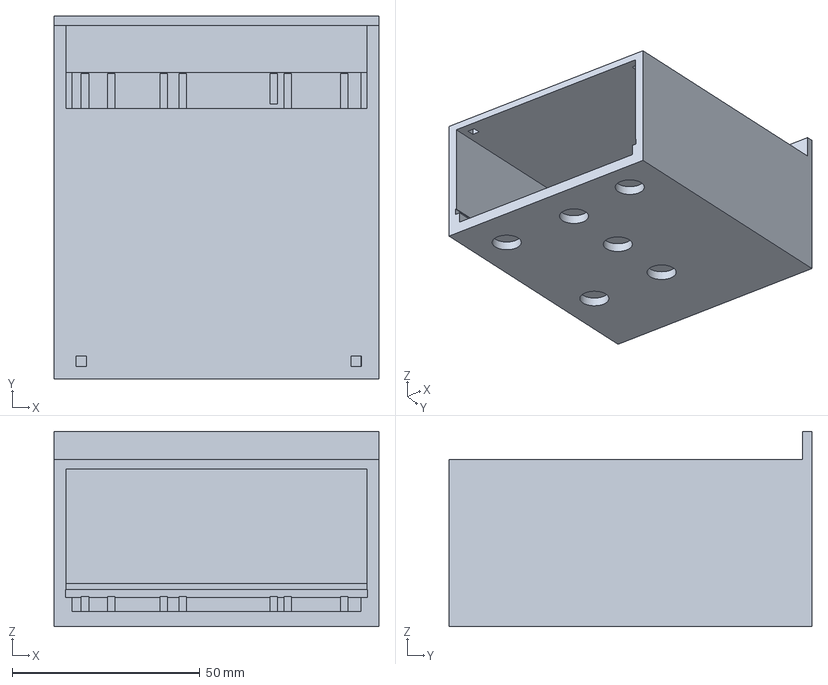
[picture p42: CAD file, 2026-11-09]
hardware/controller/versions/v40-roof-holder/holder/holder.step
86.5 x 96.5 x 52.0 mm
