brensch/coffee/hardware/controller/versions/v49-valve-800v/holder/holder_frame.step

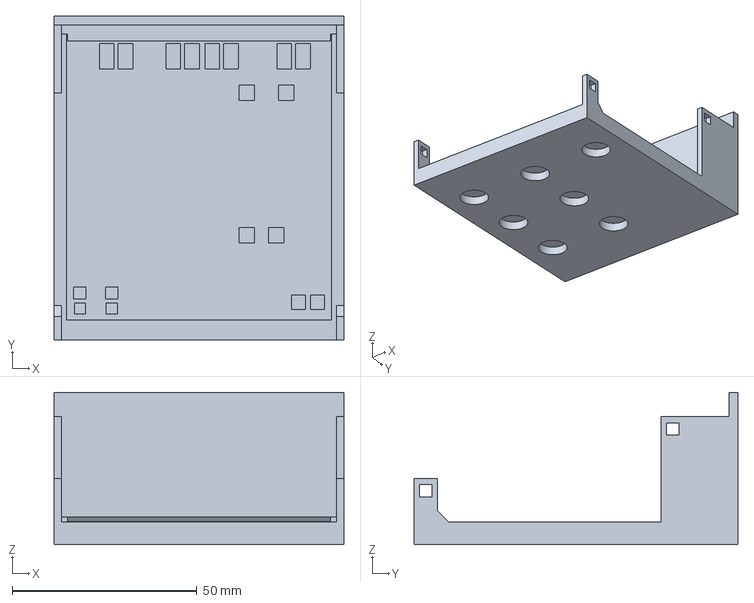
[picture p43: CAD file, 2026-11-09]
hardware/controller/versions/v49-valve-800v/holder/holder_frame.step
78.4 x 87.6 x 41.1 mm
