brensch/coffee/hardware/controller/versions/v49-valve-800v/holder/holder_bars.step

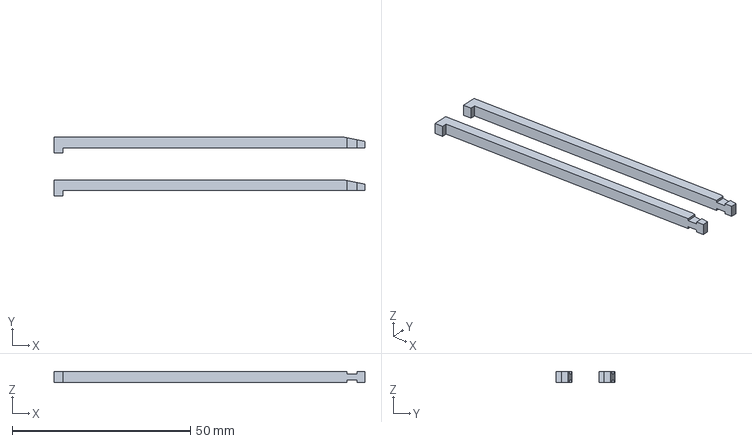
[picture p44: CAD file, 2026-11-09]
hardware/controller/versions/v49-valve-800v/holder/holder_bars.step
87.3 x 16.5 x 3.00 mm
