brensch/coffee/(list of files, cad)

Other CAD files:
hardware/controller/versions/v30-swapsafe/board.step
hardware/controller/versions/v33-pump-bleeder/board.step
hardware/controller/versions/v37-polish/board.step
hardware/controller/versions/v39-front-plate/board.step
hardware/controller/versions/v45-closed-top/board.step
hardware/controller/versions/v12-own-router/board.step
hardware/controller/versions/v13-single-sided/board.step
hardware/controller/versions/v14-labels-bean/board.step
hardware/controller/versions/v15-lv-only/board.step
hardware/controller/versions/v16-review-fixes/board.step
hardware/controller/versions/v17-review2-fixes/board.step
hardware/controller/versions/v18-datasheet-verified/board.step
hardware/controller/versions/v19-front-panel-scale/board.step
hardware/controller/versions/v20-skinny-bottom-connectors/board.step
hardware/controller/versions/v21-silk-front-bean/board.step
hardware/controller/versions/v22-all-top/board.step
hardware/controller/versions/v23-connector-rectangle/board.step
hardware/controller/versions/v24-usb-c-status-led/board.step
hardware/controller/versions/v25-one-row/board.step
hardware/controller/versions/v26-esp-middle/board.step
hardware/controller/versions/v39-front-plate/holder/holder.stl
hardware/controller/versions/v39-front-plate/holder/holder_bar.stl
hardware/controller/versions/v40-roof-holder/holder/holder.stl
hardware/controller/versions/v40-roof-holder/holder/holder_peg.stl
hardware/controller/versions/v43-bar-cover/holder/holder_bars.step
hardware/controller/versions/v43-bar-cover/holder/holder_bars.stl
hardware/controller/versions/v43-bar-cover/holder/holder_cover.step
hardware/controller/versions/v43-bar-cover/holder/holder_cover.stl
hardware/controller/versions/v43-bar-cover/holder/holder_frame.step
hardware/controller/versions/v43-bar-cover/holder/holder_frame.stl
hardware/controller/versions/v44-flat-recess/holder/holder_bars.step
hardware/controller/versions/v44-flat-recess/holder/holder_bars.stl
hardware/controller/versions/v44-flat-recess/holder/holder_bars_assembled.stl
hardware/controller/versions/v44-flat-recess/holder/holder_cover.step
hardware/controller/versions/v44-flat-recess/holder/holder_cover.stl
hardware/controller/versions/v44-flat-recess/holder/holder_frame.step
hardware/controller/versions/v44-flat-recess/holder/holder_frame.stl
hardware/controller/versions/v46-magnet-grid/holder/holder_bars.step
hardware/controller/versions/v46-magnet-grid/holder/holder_bars.stl
hardware/controller/versions/v46-magnet-grid/holder/holder_bars_assembled.stl
hardware/controller/versions/v46-magnet-grid/holder/holder_cover.step
hardware/controller/versions/v46-magnet-grid/holder/holder_cover.stl
hardware/controller/versions/v46-magnet-grid/holder/holder_frame.step
hardware/controller/versions/v46-magnet-grid/holder/holder_frame.stl
hardware/controller/versions/v49-valve-800v/holder/holder_bars.stl
hardware/controller/versions/v49-valve-800v/holder/holder_cover.stl
hardware/controller/versions/v49-valve-800v/holder/holder_frame.stl
