brensch/coffee/hardware/controller/build/v37-mp30/review.html

top



D3

C12

C4

R40

R25

D5

C5

J14

J4

R12

Q2

R50

Q5

C11

R48

J15

R49

C13

J2

J7

R30

R19

R53

J12

R18

R16

R32

Q3

Q1

D8

R42

R51

R13

R47

C15

C3

U8

U9

Q6

D4

R21

R10

R14

D2

J13

R20

R45

C9

C14

R24

R54

C7

R4

U5

D7

F1

R36

R46

R44

R5

R17

J10

U7

U4

J5

U6

R11

J6

R37

R38

R6

D6

R43

R31

C16

C6

R52

R39

R41

D1

PS1

TP1

bottom (seen from below)



D3

C12

C4

R40

R25

D5

C5

J14

J4

R12

Q2

R50

Q5

C11

R48

J15

R49

C13

J2

J7

R30

R19

R53

J12

R18

R16

R32

Q3

Q1

D8

R42

R51

R13

R47

C15

C3

U8

U9

Q6

D4

R21

R10

R14

D2

J13

R20

R45

C9

C14

R24

R54

C7

R4

U5

D7

F1

R36

R46

R44

R5

R17

J10

U7

U4

J5

U6

R11

J6

R37

R38

R6

D6

R43

R31

C16

C6

R52

R39

R41

D1

PS1

TP1
