brensch/coffee/hardware/controller/build/v34-mp30/review.html

top



J6

D3

Q1

R28

R42

R21

R17

U6

R20

J2

J7

C12

H2

R14

J12

R43

J15

H1

F1

R39

R41

C16

J13

U7

D6

R51

Q5

C13

R19

U9

R5

R44

R46

D1

C7

D2

R32

R24

C3

R37

R30

H3

R38

R11

R47

C14

J5

R12

C15

R54

R16

D7

C6

C9

R53

R52

R13

C5

U8

J10

D8

R10

Q3

R45

R29

R40

J4

R48

D4

R49

R31

R50

R6

PS1

R36

Q6

R18

J14

U5

C11

R4

U4

R25

C4

Q2

D5

TP1

bottom (seen from below)



J6

D3

Q1

R28

R42

R21

R17

U6

R20

J2

J7

C12

H2

R14

J12

R43

J15

H1

F1

R39

R41

C16

J13

U7

D6

R51

Q5

C13

R19

U9

R5

R44

R46

D1

C7

D2

R32

R24

C3

R37

R30

H3

R38

R11

R47

C14

J5

R12

C15

R54

R16

D7

C6

C9

R53

R52

R13

C5

U8

J10

D8

R10

Q3

R45

R29

R40

J4

R48

D4

R49

R31

R50

R6

PS1

R36

Q6

R18

J14

U5

C11

R4

U4

R25

C4

Q2

D5

TP1
