brensch/coffee/hardware/controller/build/coffee-controller-120v.pdf

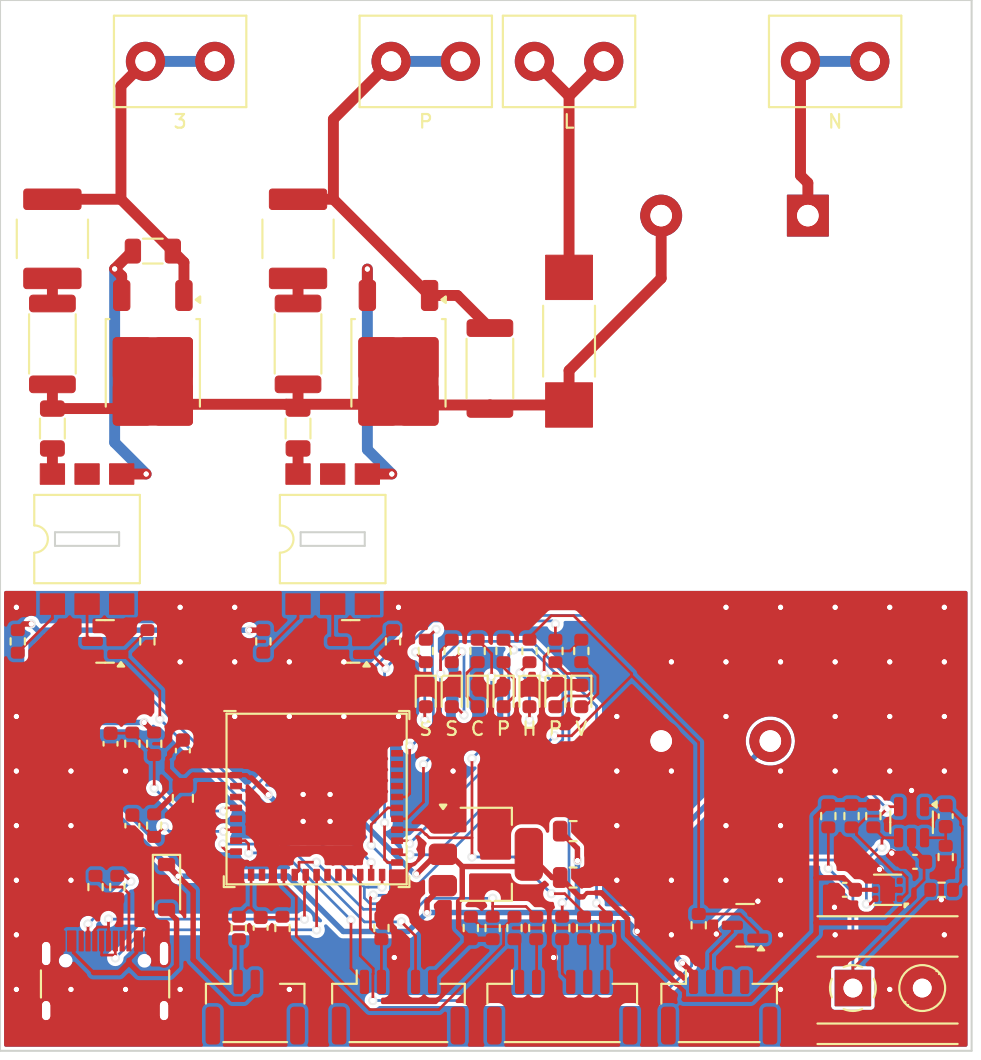
[picture p45: page 1]
