brensch/coffee/hardware/controller/build/v44/coffee-controller-120v.pdf

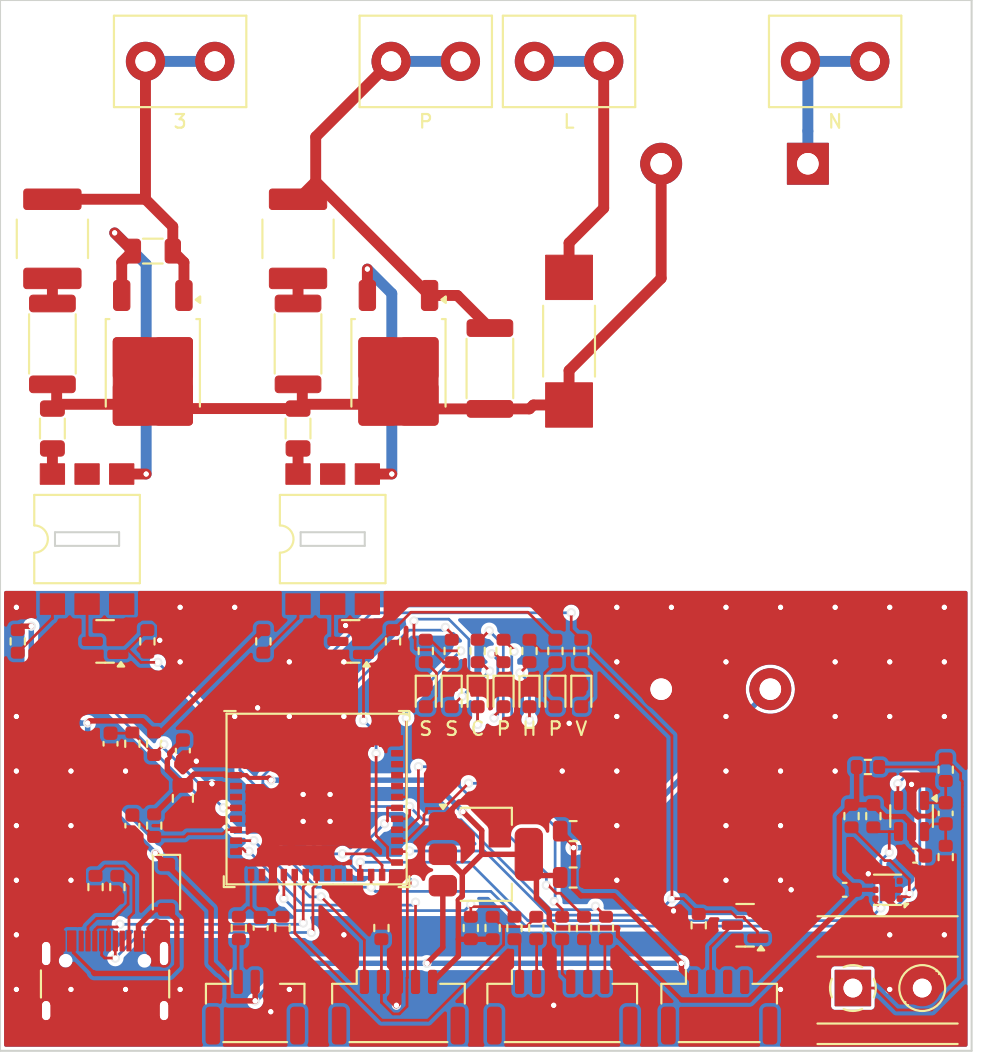
[picture p46: page 1]
