brensch/coffee/hardware/controller/build/v39/coffee-controller-120v.pdf

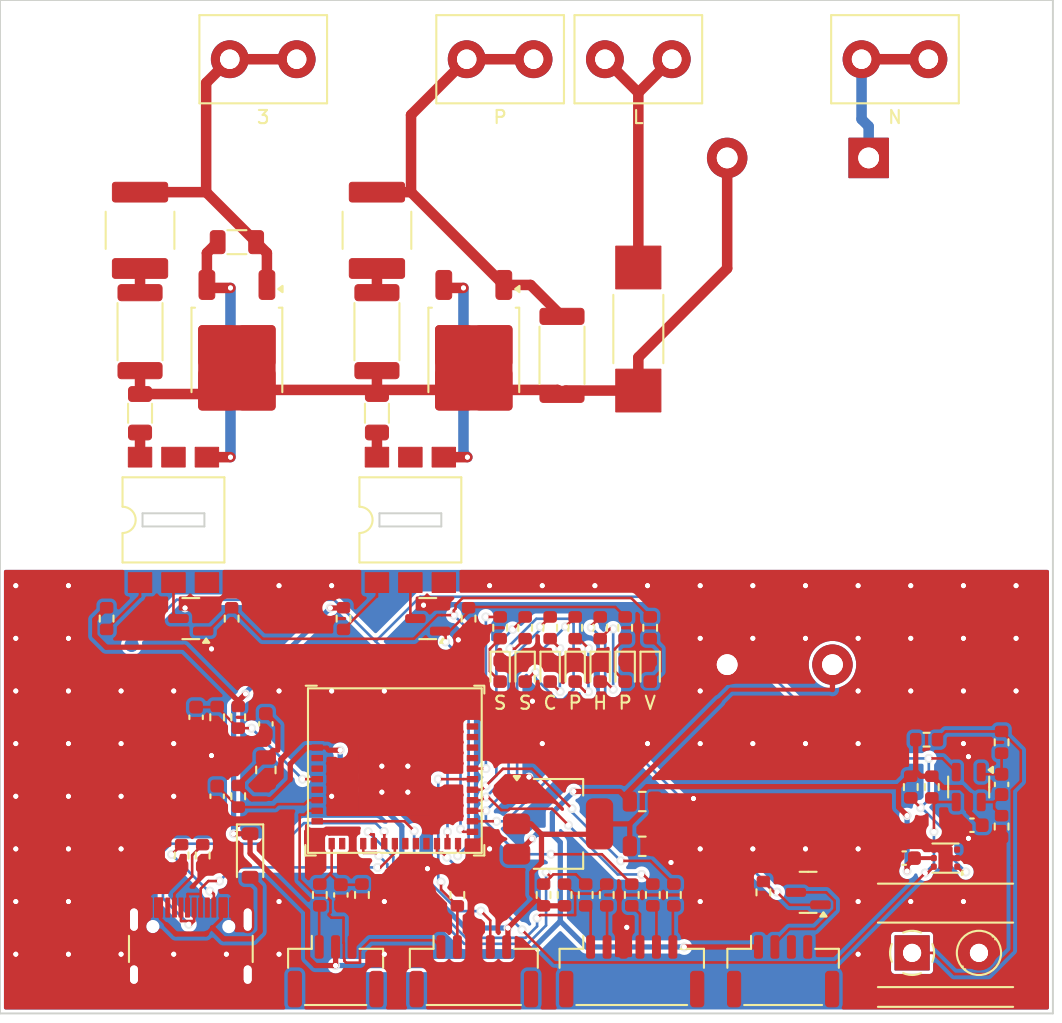
[picture p47: page 1]
