brensch/coffee/hardware/controller/build/v38/coffee-controller-120v.pdf

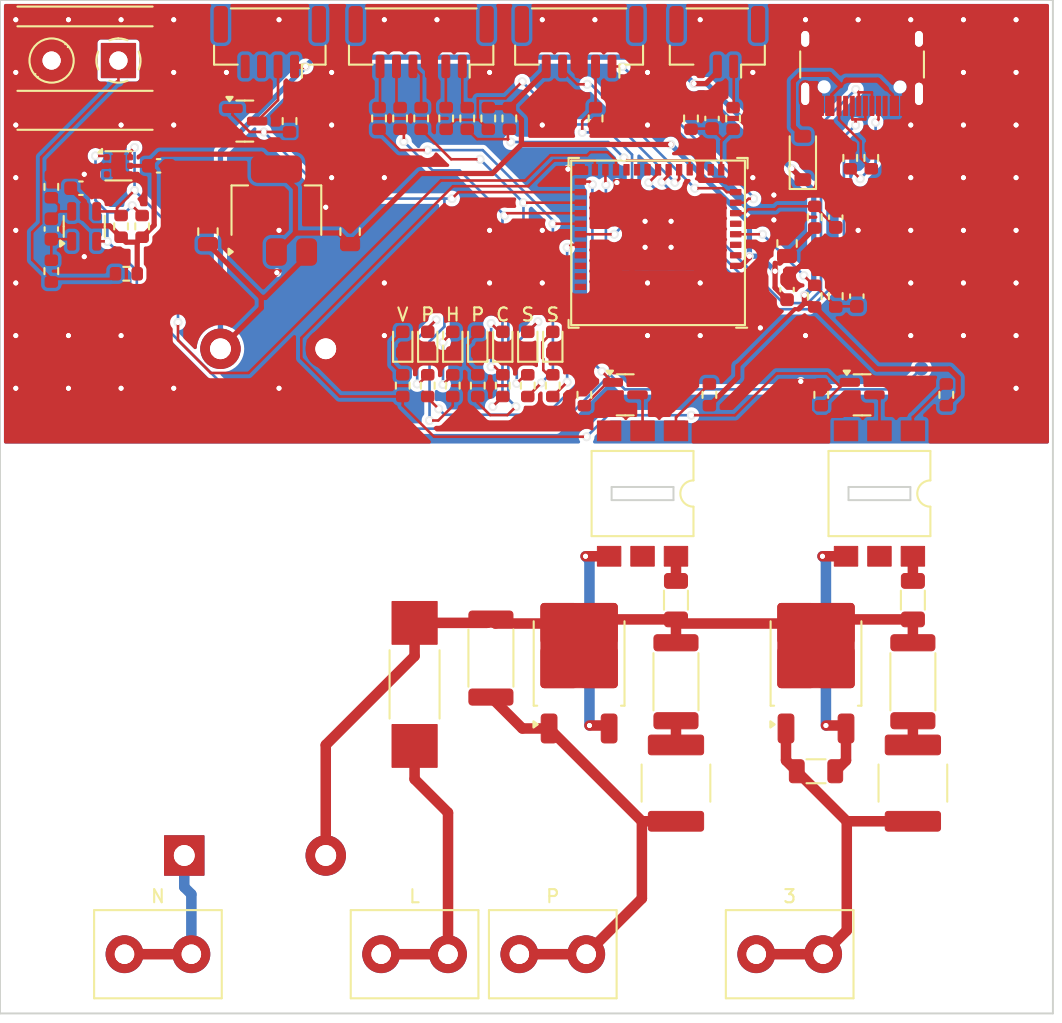
[picture p48: page 1]
