brensch/coffee/hardware/controller/build/v37-mp30/coffee-controller-120v.pdf

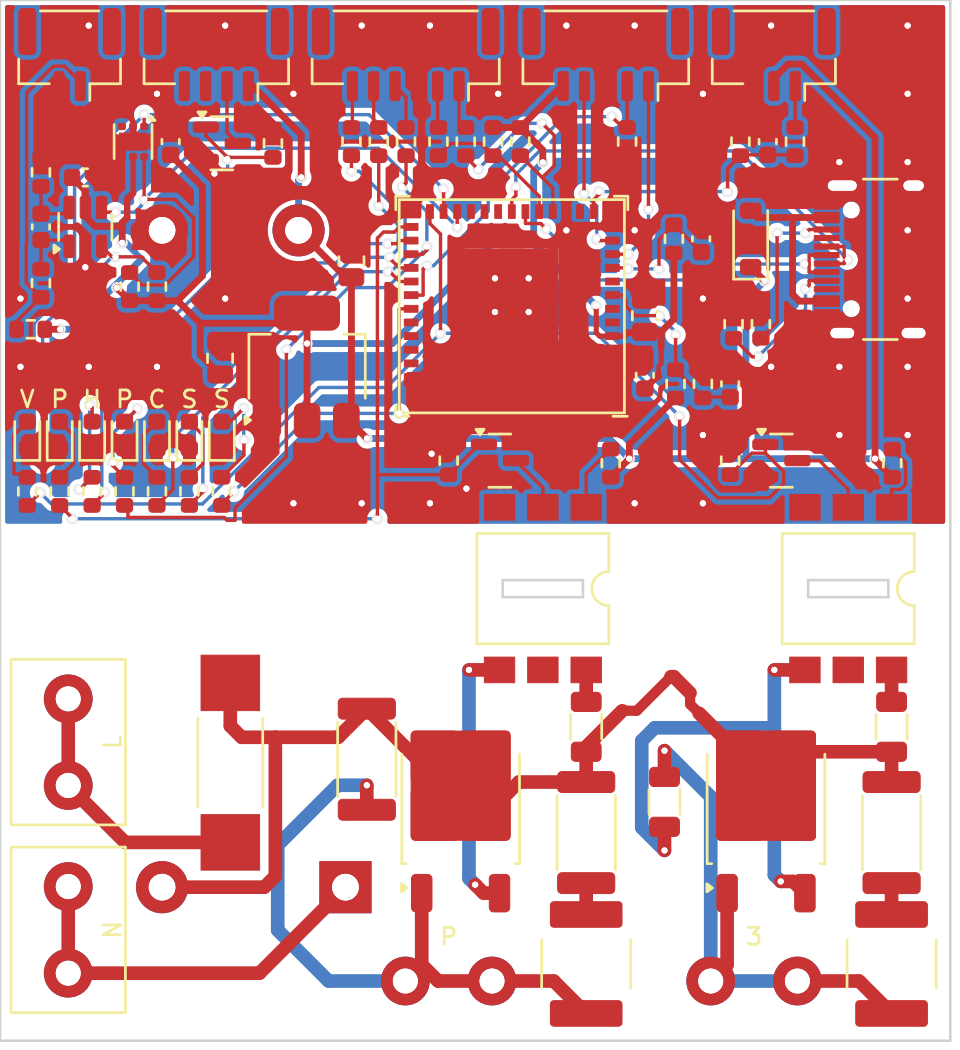
[picture p49: page 1]
