brensch/coffee/hardware/controller/build/v34-mp30/coffee-controller-120v.pdf

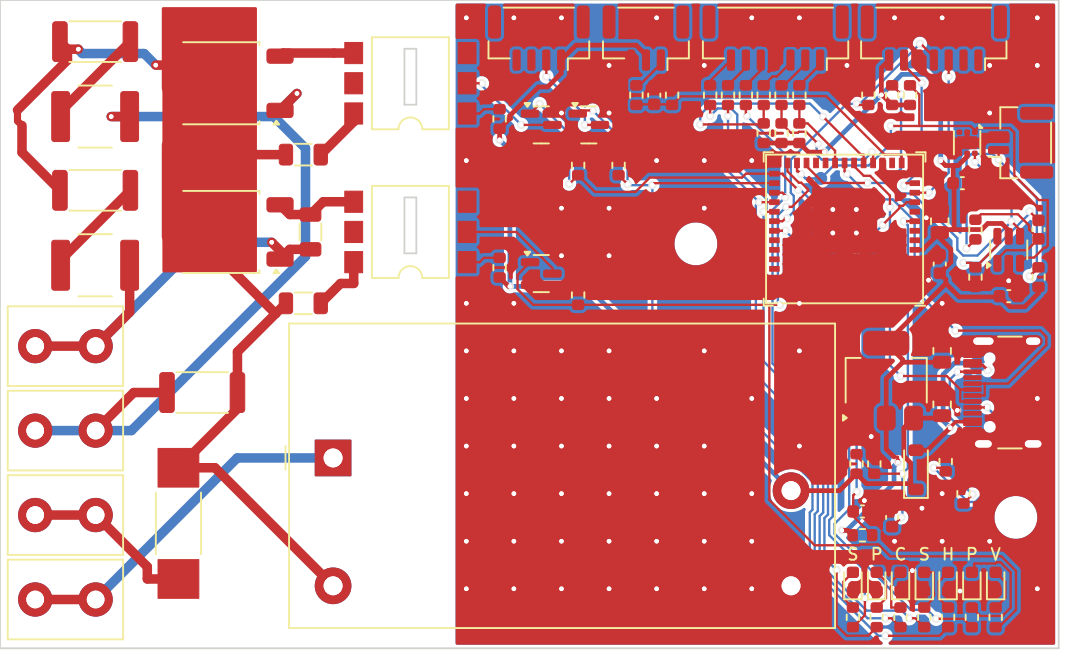
[picture p50: page 1]
