brensch/coffee/(list of files, drawings)

Other design files:
hardware/controller/build/easyeda-cache/C2286.json
hardware/controller/build/easyeda-cache/C2480.json
hardware/controller/build/easyeda-cache/C4184.json
hardware/controller/build/easyeda-cache/C4410.json
hardware/controller/build/easyeda-cache/C7250.json
hardware/controller/build/easyeda-cache/C8598.svgs.json
hardware/controller/build/easyeda-cache/C11702.json
hardware/controller/build/easyeda-cache/C12624.json
hardware/controller/build/easyeda-cache/C14663.json
hardware/controller/build/easyeda-cache/C15127.json
hardware/controller/build/easyeda-cache/C15578.json
hardware/controller/build/easyeda-cache/C15849.json
hardware/controller/build/easyeda-cache/C15850.json
hardware/controller/build/easyeda-cache/C17930.json
hardware/controller/build/easyeda-cache/C18002.json
hardware/controller/build/easyeda-cache/C20917.json
hardware/controller/build/easyeda-cache/C21122.json
hardware/controller/build/easyeda-cache/C21190.json
hardware/controller/build/easyeda-cache/C22775.json
hardware/controller/build/easyeda-cache/C22808.json
hardware/controller/build/easyeda-cache/C22978.json
hardware/controller/build/easyeda-cache/C23138.json
hardware/controller/build/easyeda-cache/C23162.json
hardware/controller/build/easyeda-cache/C23186.json
hardware/controller/build/easyeda-cache/C25104.json
hardware/controller/build/easyeda-cache/C25741.json
hardware/controller/build/easyeda-cache/C25744.json
hardware/controller/build/easyeda-cache/C25765.json
hardware/controller/build/easyeda-cache/C25792.json
hardware/controller/build/easyeda-cache/C25803.json
hardware/controller/build/easyeda-cache/C25804.json
hardware/controller/build/easyeda-cache/C25819.json
hardware/controller/build/easyeda-cache/C25890.json
hardware/controller/build/easyeda-cache/C25900.json
hardware/controller/build/easyeda-cache/C25905.json
hardware/controller/build/easyeda-cache/C25981.json
hardware/controller/build/easyeda-cache/C29454.json
hardware/controller/build/easyeda-cache/C35218.json
hardware/controller/build/easyeda-cache/C45783.json
hardware/controller/build/easyeda-cache/C52923.json
hardware/controller/build/easyeda-cache/C60474.json
hardware/controller/build/easyeda-cache/C81598.json
hardware/controller/build/easyeda-cache/C82942.json
hardware/controller/build/easyeda-cache/C95204.json
hardware/controller/build/easyeda-cache/C107017.json
hardware/controller/build/easyeda-cache/C111561.json
hardware/controller/build/easyeda-cache/C133065.json
hardware/controller/build/easyeda-cache/C145128.json
hardware/controller/build/easyeda-cache/C145131.json
hardware/controller/build/easyeda-cache/C155588.json
hardware/controller/build/easyeda-cache/C155606.json
hardware/controller/build/easyeda-cache/C165948.json
hardware/controller/build/easyeda-cache/C187538.json
hardware/controller/build/easyeda-cache/C189893.json
hardware/controller/build/easyeda-cache/C189895.json
hardware/controller/build/easyeda-cache/C189896.json
hardware/controller/build/easyeda-cache/C237426.json
hardware/controller/build/easyeda-cache/C283473.json
hardware/controller/build/easyeda-cache/C328424.json
hardware/controller/build/easyeda-cache/C380347.json
hardware/controller/build/easyeda-cache/C437417.json
hardware/controller/build/easyeda-cache/C495552.json
hardware/controller/build/easyeda-cache/C514175.json
hardware/controller/build/easyeda-cache/C559769.json
hardware/controller/build/easyeda-cache/C575074.json
hardware/controller/build/easyeda-cache/C696861.json
hardware/controller/build/easyeda-cache/C699536.json
hardware/controller/build/easyeda-cache/C861589.json
hardware/controller/build/easyeda-cache/C907991.json
hardware/controller/build/easyeda-cache/C2077706.json
hardware/controller/build/easyeda-cache/C2078757.json
hardware/controller/build/easyeda-cache/C2682586.json
hardware/controller/build/easyeda-cache/C2765055.json
hardware/controller/build/easyeda-cache/C2857903.json
hardware/controller/build/easyeda-cache/C2933683.json
hardware/controller/build/easyeda-cache/C3020560.json
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
