brensch/coffee/hardware/controller/build/quilter/coffee-controller.kicad_pcb

## KiCad design hardware/controller/build/quilter/coffee-controller.kicad_pcb (2026-11-04)

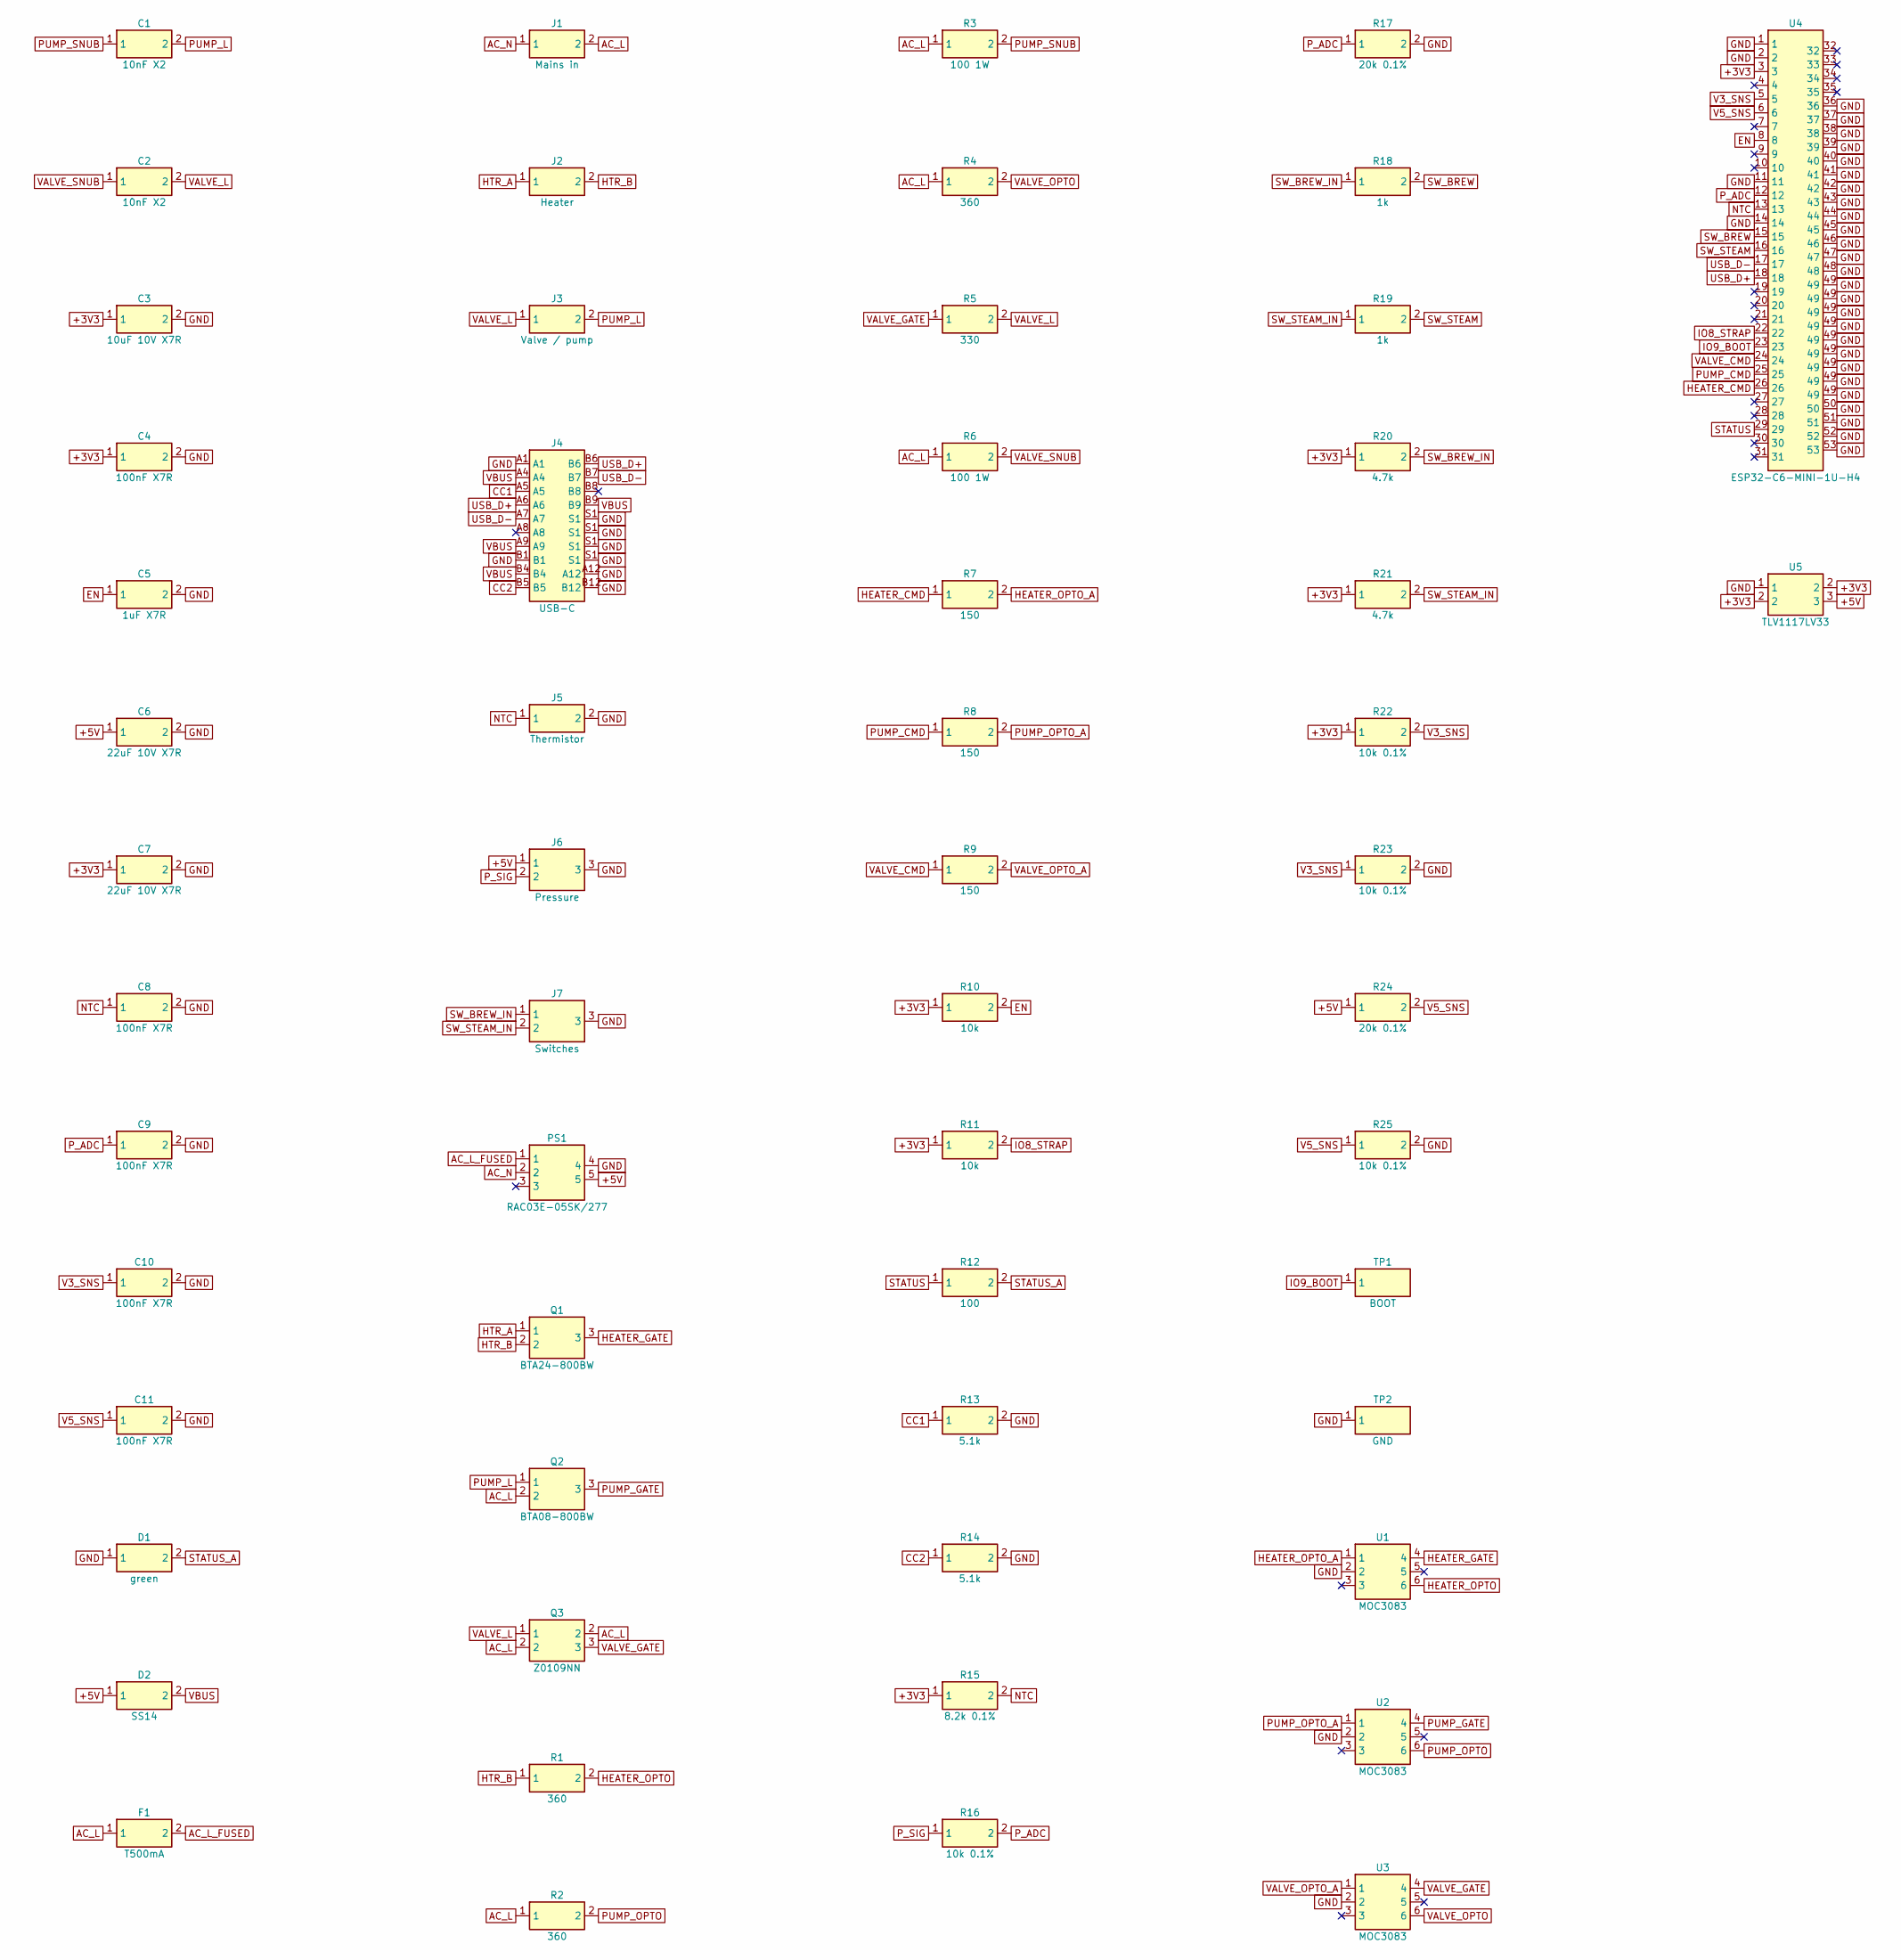
[picture p53: schematic coffee-controller.kicad_sch]

Parts:
C1, C2: 10nF X2; C_2220_Murata_GA355; MPN Murata GA355QR7GB103KW01L (10 nF X2 250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
C3: 10uF 10V X7R; C_0805_2012Metric
C4, C8, C9, C10, C11: 100nF X7R; C_0603_1608Metric
C5: 1uF X7R; C_0603_1608Metric
C6, C7: 22uF 10V X7R; C_0805_2012Metric; MPN Murata GRM21BZ71A226ME15L
D1: green; LED_0603_1608Metric
D2: SS14; D_SMA; MPN SS14
F1: T500mA; Fuse_Littelfuse_372_D8.50mm; MPN Littelfuse 37205000411 (TR5, 500 mA slo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
J1: Mains in; TerminalBlock_Phoenix_MKDS-1,5-2-5.08_1x02_P5.08mm_Horizont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; MPN Phoenix Contact MKDS 1,5/2-5.08 (171572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
J2: Heater; TerminalBlock_Phoenix_MKDS-3-2-5.08_1x02_P5.08mm_Horizontal; MPN Phoenix Contact MKDS 3/2-5.08 (1711725)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
J3: Valve / pump; TerminalBlock_Phoenix_MKDS-1,5-2-5.08_1x02_P5.08mm_Horizont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; MPN Phoenix Contact MKDS 1,5/2-5.08 (171572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
J4: USB-C; USB_C_Receptacle_GCT_USB4105-xx-A_16P_TopMnt_Horizontal; MPN GCT USB4105-GF-A
J5: Thermistor; JST_PH_B2B-PH-K_1x02_P2.00mm_Vertical
J6: Pressure; JST_PH_B3B-PH-K_1x03_P2.00mm_Vertical
J7: Switches; JST_PH_B3B-PH-K_1x03_P2.00mm_Vertical
PS1: RAC03E-05SK/277; RAC03E-K_277; MPN RECOM RAC03E-05SK/277
Q1: BTA24-800BW; TO-220-3_Vertical_Drill1.2; MPN ST BTA24-800BWRG (25 A, 800 V, insulate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
Q2: BTA08-800BW; TO-220-3_Vertical_Drill1.2; MPN ST BTA08-800BWRG (8 A, 800 V, insulated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
Q3: Z0109NN; SOT-223-3_TabPin2; MPN ST Z0109NN5AA4 (1 A, 800 V, IGT 10 mA)
R1, R2, R4: 360; R_1206_3216Metric
R3, R6: 100 1W; R_2512_6332Metric
R5: 330; R_1206_3216Metric
R7, R8, R9: 150; R_0603_1608Metric
R10, R11: 10k; R_0603_1608Metric
R12: 100; R_0603_1608Metric
R13, R14: 5.1k; R_0603_1608Metric
R15: 8.2k 0.1%; R_0603_1608Metric
R16, R22, R23, R25: 10k 0.1%; R_0603_1608Metric
R17, R24: 20k 0.1%; R_0603_1608Metric
R18, R19: 1k; R_0603_1608Metric
R20, R21: 4.7k; R_0603_1608Metric
TP1: BOOT; TestPoint_Pad_D1.5mm
TP2: GND; TestPoint_Pad_D1.5mm
U1, U2, U3: MOC3083; DIP-6_W10.16mm; MPN onsemi MOC3083TVM (0.4" leads)
U4: ESP32-C6-MINI-1U-H4; ESP32-C6-MINI-1U; MPN ESP32-C6-MINI-1U-H4
U5: TLV1117LV33; SOT-223-3_TabPin2; MPN TI TLV1117LV33DCYR

Connections:
+3V3: C3.1, C4.1, C7.1, R10.1, R11.1, R15.1, R20.1, R21.1, R22.1, U4.3, U5.2
+5V: C6.1, D2.1, J6.1, PS1.5, R24.1, U5.3
AC_L: F1.1, J1.2, Q2.2, Q3.2, R2.1, R3.1, R4.1, R6.1
AC_L_FUSED: F1.2, PS1.1
AC_N: J1.1, PS1.2
CC1: J4.A5, R13.1
CC2: J4.B5, R14.1
EN: C5.1, R10.2, U4.8
GND: C3.2, C4.2, C5.2, C6.2, C7.2, C8.2, C9.2, C10.2, C11.2, D1.1, J4.A1, J4.A12, J4.B1, J4.B12, J4.S1, J5.2, J6.3, J7.3, PS1.4, R13.2, R14.2, R17.2, R23.2, R25.2, TP2.1, U1.2, U2.2, U3.2, U4.1, U4.2, U4.11, U4.14, U4.36, U4.37, U4.38, U4.39, U4.40, U4.41, U4.42, U4.43, U4.44, U4.45, U4.46, U4.47, U4.48, U4.49, U4.50, U4.51, U4.52, U4.53, U5.1
HEATER_CMD: R7.1, U4.26
HEATER_GATE: Q1.3, U1.4
HEATER_OPTO: R1.2, U1.6
HEATER_OPTO_A: R7.2, U1.1
HTR_A: J2.1, Q1.1
HTR_B: J2.2, Q1.2, R1.1
IO8_STRAP: R11.2, U4.22
IO9_BOOT: TP1.1, U4.23
NTC: C8.1, J5.1, R15.2, U4.13
PUMP_CMD: R8.1, U4.25
PUMP_GATE: Q2.3, U2.4
PUMP_L: C1.2, J3.2, Q2.1
PUMP_OPTO: R2.2, U2.6
PUMP_OPTO_A: R8.2, U2.1
PUMP_SNUB: C1.1, R3.2
P_ADC: C9.1, R16.2, R17.1, U4.12
P_SIG: J6.2, R16.1
STATUS: R12.1, U4.29
STATUS_A: D1.2, R12.2
SW_BREW: R18.2, U4.15
SW_BREW_IN: J7.1, R18.1, R20.2
SW_STEAM: R19.2, U4.16
SW_STEAM_IN: J7.2, R19.1, R21.2
USB_D+: J4.A6, J4.B6, U4.18
USB_D-: J4.A7, J4.B7, U4.17
V3_SNS: C10.1, R22.2, R23.1, U4.5
V5_SNS: C11.1, R24.2, R25.1, U4.6
VALVE_CMD: R9.1, U4.24
VALVE_GATE: Q3.3, R5.1, U3.4
VALVE_L: C2.2, J3.1, Q3.1, R5.2
VALVE_OPTO: R4.2, U3.6
VALVE_OPTO_A: R9.2, U3.1
VALVE_SNUB: C2.1, R6.2
VBUS: D2.2, J4.A4, J4.A9, J4.B4, J4.B9

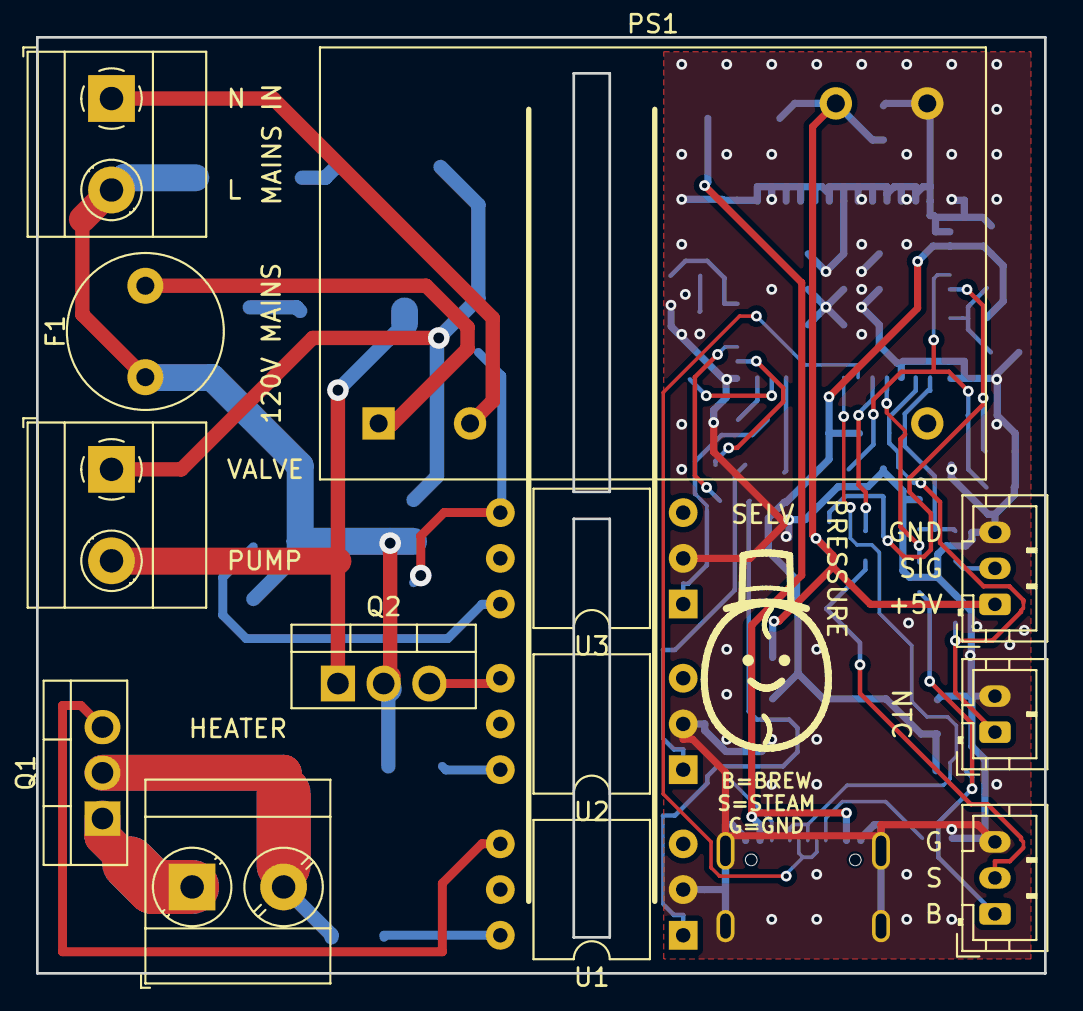
[picture p54: board hardware/controller/build/quilter/coffee-controller.kicad_pcb from above]

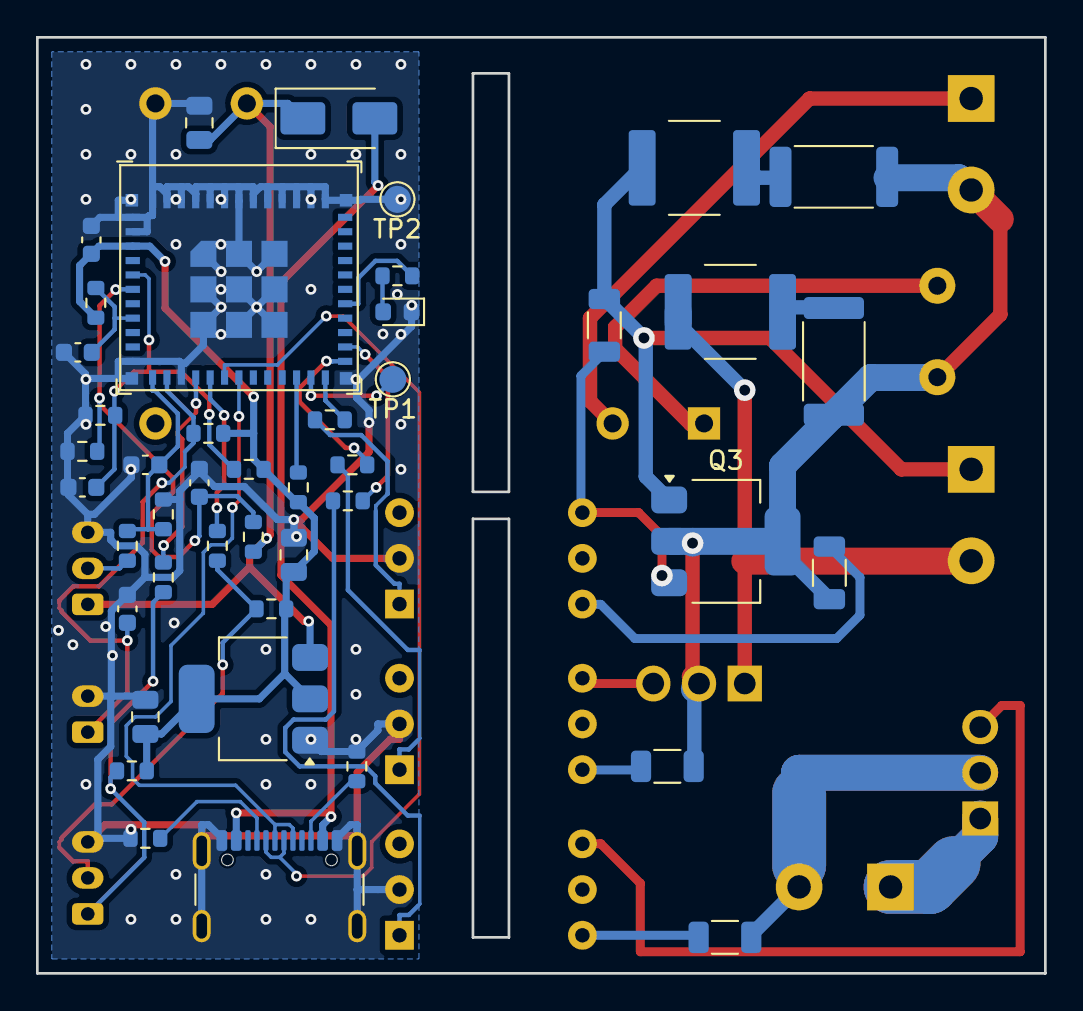
[picture p55: board hardware/controller/build/quilter/coffee-controller.kicad_pcb from below]

Board: 2 copper layers, 56.0 x 52.0 mm, 57 parts (44 on the bottom side), 43 nets.
