brensch/coffee/hardware/controller/versions/v22-all-top/board.kicad_pcb

## KiCad design hardware/controller/versions/v22-all-top/board.kicad_pcb (2026-11-05, an earlier design)

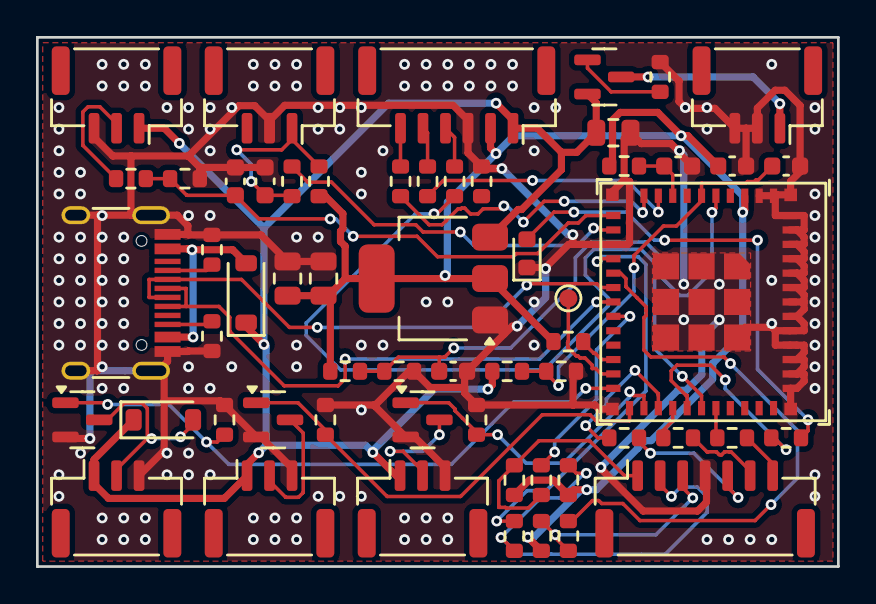
[picture p56: board board.kicad_pcb from above]

Board: 2 copper layers, 44.5 x 29.4 mm, 58 parts (0 on the bottom side), 45 nets.

Parts:
C3: 10uF 25V X5R; C_0805_2012Metric
C4, C8, C10, C11: 100nF X7R; C_0603_1608Metric
C5: 1uF X5R; C_0603_1608Metric
C6, C7: 22uF 25V X5R; C_0805_2012Metric
C9: 22nF X7R; C_0603_1608Metric
D1: red; LED_0603_1608Metric
D2: B5819W; D_SOD-123
D5: 1N4148W; D_SOD-123
J1: 5V in; JST_GH_SM03B-GHS-TB_1x03-1MP_P1.25mm_Horizontal
J2: Heater; JST_GH_SM03B-GHS-TB_1x03-1MP_P1.25mm_Horizontal
J3: Pump; JST_GH_SM03B-GHS-TB_1x03-1MP_P1.25mm_Horizontal
J4: USB-C; USB_C_Receptacle_HRO_TYPE-C-31-M-12
J5: Thermistor; JST_GH_SM03B-GHS-TB_1x03-1MP_P1.25mm_Horizontal
J6: Pressure; JST_GH_SM03B-GHS-TB_1x03-1MP_P1.25mm_Horizontal
J7: Front panel; JST_GH_SM07B-GHS-TB_1x07-1MP_P1.25mm_Horizontal
J8: Valve; JST_GH_SM03B-GHS-TB_1x03-1MP_P1.25mm_Horizontal
J10: Scale; JST_GH_SM06B-GHS-TB_1x06-1MP_P1.25mm_Horizontal
Q1, Q2, Q3: AO3400A; SOT-23
Q4: AO3401A; SOT-23
R4, R5, R6: 3.3k; R_0603_1608Metric
R10, R11, R22, R23, R25, R26, R36: 10k; R_0603_1608Metric
R12, R18, R19, R27, R29: 1k; R_0603_1608Metric
R13, R14: 5.1k; R_0603_1608Metric
R15, R20, R21, R28: 4.7k; R_0603_1608Metric
R16: 47k; R_0603_1608Metric
R17: 100k; R_0603_1608Metric
R24: 20k; R_0603_1608Metric
R30, R31, R32: 330; R_0603_1608Metric
R33, R34, R35: 100; R_0603_1608Metric
TP1: BOOT; TestPoint_Pad_D1.0mm
U4: ESP32-C6-MINI-1U-H4; ESP32-C6-MINI-1U
U5: TLV1117LV33DCYR; SOT-223-3_TabPin2

Connections:
+3V3: C3.1, C4.1, C7.1, J10.2, R10.1, R11.1, R15.1, R20.1, R21.1, R22.1, R28.1, U4.3, U5.2
+5V: C6.1, D2.1, D5.1, J2.1, J3.1, J6.1, J8.1, J10.1, Q4.2, R24.1, U5.3
+5V_IN: J1.1, Q4.3
CC1: J4.A5, R13.1
CC2: J4.B5, R14.1
EN: C5.1, R10.2, U4.8
GND: C3.2, C4.2, C5.2, C6.2, C7.2, C8.2, C9.2, C10.2, C11.2, D1.1, J1.2, J1.3, J2.3, J3.3, J4.A1, J4.A12, J4.B1, J4.B12, J4.S1, J5.2, J6.3, J7.4, J8.3, J10.3, Q1.2, Q2.2, Q3.2, R4.2, R5.2, R6.2, R13.2, R14.2, R17.2, R23.2, R25.2, R26.2, R36.2, U4.1, U4.2, U4.11, U4.14, U4.36, U4.37, U4.38, U4.39, U4.40, U4.41, U4.42, U4.43, U4.44, U4.45, U4.46, U4.47, U4.48, U4.49, U4.50, U4.51, U4.52, U4.53, U5.1
HEATER_CMD: Q1.1, R4.1, U4.26
HEATER_OUT: J2.2, Q1.3
IO8_STRAP: R11.2, U4.22
IO9_BOOT: TP1.1, U4.23
LED_COFFEE: J7.6, R31.2
LED_COFFEE_IO: R31.1, U4.28
LED_PWR: J7.5, R30.2
LED_PWR_IO: R30.1, U4.27
LED_STEAM: J7.7, R32.2
LED_STEAM_IO: R32.1, U4.31
NTC: C8.1, J5.1, R15.2, R27.1
NTC_ADC: R27.2, U4.13
PUMP_CMD: Q2.1, R5.1, U4.25
PUMP_OUT: J3.2, Q2.3
P_ADC: C9.1, R16.2, R17.1, U4.12
P_SIG: J6.2, R16.1
RP_GATE: Q4.1, R26.1
SCALE_DOUT1: R34.1, U4.9
SCALE_DOUT1_IN: J10.5, R34.2
SCALE_DOUT2: R35.1, U4.10
SCALE_DOUT2_IN: J10.6, R35.2
SCALE_SCK: R33.1, U4.30
SCALE_SCK_IN: J10.4, R33.2
STATUS: R12.1, U4.29
STATUS_A: D1.2, R12.2
SW_BREW: R18.2, U4.15
SW_BREW_IN: J7.2, R18.1, R20.2
SW_POWER: R29.2, U4.19
SW_POWER_IN: J7.1, R28.2, R29.1
SW_STEAM: R19.2, U4.16
SW_STEAM_IN: J7.3, R19.1, R21.2
USB_D+: J4.A6, J4.B6, U4.18
USB_D-: J4.A7, J4.B7, U4.17
V3_SNS: C10.1, R22.2, R23.1, U4.5
V5_SNS: C11.1, R24.2, R25.1, U4.6
VALVE_CMD: Q3.1, R6.1, U4.24
VALVE_OUT: D5.2, J8.2, Q3.3
VBUS: D2.2, J4.A4, J4.A9, J4.B4, J4.B9
