brensch/coffee/firmware/esp32/src/main.rs

//! ESP32-C6 firmware (ESP32-C6-MINI-1U-H4: 4 MB flash, 105 C rated).
//!
//! This is the ESP32 shell around `coffee_node::Node`, the same node the PC binary
//! runs. All behaviour (engine, profiles, shot recording, API) lives there; the
//! pure timing, filtering and protocol pieces of this shell live in `coffee_board`
//! and are unit-tested on the host.
//!
//! # Machine mode (default)
//!
//! Two priorities, so networking can never starve the machine:
//!
//! - **Control** (`control.rs`, interrupt executor, high priority): crystal tick
//!   once per nominal mains cycle, ADC oversampling, switch debounce, engine tick,
//!   outputs, status LED, the 250 ms RTC watchdog. There is no zero-cross
//!   detector: the heater and pump SSRs are zero-cross and only ever switch at a crossing.
//! - **Everything else** (thread executor, preempted by control): Wi-Fi station
//!   with DHCP and reconnect (`net.rs`), the HTTP server (embedded UI, `/api/*`,
//!   `/api/ws` telemetry, `/api/ota`), the `coffee.local` mDNS responder, the USB
//!   console and log stream (`usb.rs`), and the flash write-back task (`store.rs`).
//!
//! The control task owns the node outright: no lock, so nothing on the network side
//! can make it wait. API requests reach it through a bounded queue that it drains
//! once per cycle, after outputs are applied, under a fixed budget; telemetry goes
//! the other way as a snapshot (`link.rs`). A stalled control task resets the chip
//! through the watchdog, and every output drops to off. Losing Wi-Fi changes
//! nothing: the physical brew and steam switches go straight to the engine.
//!
//! # Bridge mode (`--features bridge`)
//!
//! Hardware-in-the-loop: sensor frames arrive from `coffee-emu` over USB
//! (lockstep wire protocol) and actuator frames go back; the machine pins stay
//! off and there is no Wi-Fi (`bridge.rs`).
//!
//! # Pin map (controller v35-v39: mains section on the board, no power-rocker input)
//!
//! | Signal          | GPIO  | Notes                                                 |
//! |-----------------|-------|-------------------------------------------------------|
//! | Pressure        | 0     | ADC1_CH0, transducer (J6) through 47k/100k (x0.68)     |
//! | 5 V sense       | 3     | ADC1_CH3, 20k/10k (x1/3): pressure made ratiometric    |
//! | I2C SDA / SCL   | 8 / 9 | MCP3421 0x68 (thermocouple, J5), TMP117 0x48 (cold junction); 4.7k pull-ups |
//! | Valve           | 18    | push-pull, HIGH = on: AO3400A sinks the MOC3083 LED, triac Q6 |
//! | Pump            | 19    | push-pull, HIGH = on: AO3400A sinks the MOC3083 LED, triac Q5 |
//! | Heater          | 20    | push-pull, HIGH = on: AO3400A sinks the heater SSR input (J2) |
//! | Brew switch     | 6     | dry contact to GND (J7.1), 10k pull-up + 1k series, low = closed |
//! | Steam switch    | 7     | dry contact to GND (J7.2), 10k pull-up + 1k series, low = closed |
//! | Status LED      | 16    | U0TXD (also flickers with the ROM boot log)           |
//! | Panel LEDs      | 21/22/23 | power / coffee / steam lamps (J7.4-6), 330R, high = on |
//! | Scale SCK       | 17    | U0RXD: dual HX711 clock (J10)                         |
//! | Scale DOUT1/2   | 4/5   | HX711 data (J10); straps only SDIO edges              |
//! | USB D- / D+     | 12/13 | native USB Serial/JTAG (flashing, console, log)       |
//!
//! Strapping pins 8 and 9 carry only the I2C bus: both idle high (pull-ups), the state the
//! ROM wants for a normal boot, and GPIO9 is also the BOOT pad. GPIO4/5 (MTMS/MTDI) strap only
//! the SDIO clock edges, so they read the scale. GPIO1, 2, 14 and 15 are unused (v35: the power
//! rocker switches the machine's mains, this board included, so it isn't an input any more).

#![no_std]
#![no_main]

extern crate alloc;

use esp_backtrace as _;

esp_bootloader_esp_idf::esp_app_desc!();

/// The embedded, gzipped web UI (generated by build.rs).
#[allow(dead_code)]
mod assets {
    include!(concat!(env!("OUT_DIR"), "/ui_assets.rs"));
}

#[cfg(feature = "bridge")]
mod bridge;
#[cfg(not(feature = "bridge"))]
mod control;
#[cfg(not(feature = "bridge"))]
mod link;
#[cfg(not(feature = "bridge"))]
mod net;
mod scale;
#[cfg(not(feature = "bridge"))]
mod store;
#[cfg(not(feature = "bridge"))]
mod usb;

pub const VERSION: &str = env!("CARGO_PKG_VERSION");

pub fn info() -> coffee_api::Info {
    coffee_api::Info {
        name: "coffee".into(),
        version: VERSION.into(),
        platform: "esp32c6".into(),
        emulated: cfg!(feature = "bridge"),
        lab_url: None,
    }
}

#[cfg(not(feature = "bridge"))]
mod machine {
    use crate::{control, net, store, usb};
    use coffee_node::{Node, NodeOptions};
    use embassy_executor::Spawner;
    use esp_hal::clock::CpuClock;
    use esp_hal::interrupt::Priority;
    use esp_hal::timer::timg::TimerGroup;
    use esp_rtos::embassy::InterruptExecutor;
    use static_cell::StaticCell;

    #[esp_hal::main]
    async fn main(spawner: Spawner) -> ! {
        let p = esp_hal::init(esp_hal::Config::default().with_cpu_clock(CpuClock::max()));
        esp_alloc::heap_allocator!(#[esp_hal::ram(reclaimed)] size: 64 * 1024);
        esp_alloc::heap_allocator!(size: 176 * 1024);

        let timg0 = TimerGroup::new(p.TIMG0);
        esp_rtos::start(timg0.timer0, p.FROM_CPU_INTR0);

        // Flash: partition table -> key/value store (config, profiles, shots, Wi-Fi).
        let kv = store::init(p.FLASH);

        let node = Node::new(
            coffee_board::KvStorage(kv),
            NodeOptions {
                info: crate::info(),
                max_shots: 20, // compressed, ~2.6 KB each
                persist_shots: true,
                history_capacity: 1200, // 4 min at 5 Hz, 29 KB
                history_hz: 5.0,
            },
        );

        // Control first, at high priority: outputs are driven low before anything else runs.
        // The node moves into the control task; nothing else holds it.
        static EXEC: StaticCell<InterruptExecutor<1>> = StaticCell::new();
        let exec = EXEC.init(InterruptExecutor::new(p.FROM_CPU_INTR1));
        let hi = exec.start(Priority::Priority2);
        hi.spawn(
            control::run(
                control::Pins {
                    rtc: p.RTC_TIMER,
                    adc1: p.ADC1,
                    pressure: p.GPIO0,
                    v5_sense: p.GPIO3,
                    i2c: p.I2C0,
                    sda: p.GPIO8,
                    scl: p.GPIO9,
                    valve: p.GPIO18,
                    pump: p.GPIO19,
                    heater: p.GPIO20,
                    brew: p.GPIO6,
                    steam: p.GPIO7,
                    led: p.GPIO16,
                    led_power: p.GPIO21,
                    led_coffee: p.GPIO22,
                    led_steam: p.GPIO23,
                    scale_sck: p.GPIO17,
                    scale_dout1: p.GPIO4,
                    scale_dout2: p.GPIO5,
                },
                node,
            )
            .unwrap(),
        );

        spawner.spawn(usb::run(p.USB_DEVICE).unwrap());
        spawner.spawn(store::flusher().unwrap());
        net::start(spawner, p.WIFI).await;

        loop {
            embassy_time::Timer::after_secs(3600).await;
        }
    }
}
