brensch/coffee/crates/coffee-io/src/lib.rs

//! The hardware boundary.
//!
//! Everything the engine knows about the outside world arrives in a [`SensorFrame`],
//! and everything it does to the world leaves in an [`ActuatorFrame`]. Sensor values
//! are carried as the raw quantities the board measures, not engineering units: the
//! thermocouple EMF from the MCP3421 (microvolts), the cold-junction temperature from the
//! TMP117, and the pressure transducer as calibrated ADC1 millivolts at the MCU pin. The
//! type-K conversion, cold-junction compensation and pressure models in the engine are
//! then exercised identically whether the frame came from real silicon or the emulator.
//!
//! Timing contract: the engine is ticked once per **mains cycle** (1/60 s or 1/50 s),
//! timed by the MCU crystal. There is no zero-cross detector: the zero-cross opto-triacs
//! only fire a triac at a zero crossing, so an output raised at any point of a cycle
//! takes effect at the next crossing and an output dropped stops at the next current
//! zero. Firmware applies the decision for cycle `k` at the start of cycle `k + 1`.
//!
//! The vibratory pump has an internal diode and strokes only on the positive half
//! wave. A crystal window one mains period long contains exactly one positive-going
//! zero crossing, so "pump on for one cycle" is exactly one stroke, whatever the
//! phase of the window relative to the grid. (Off-nominal grid frequency slips one
//! window per beat period; see `coffee_board::grid`.)

#![no_std]

pub mod typek;
pub mod wire;

/// Bit flags for [`SensorFrame::inputs`].
pub mod input {
    /// Front panel brew switch closed (debounced).
    pub const BREW: u8 = 1 << 0;
    /// Front panel steam switch closed (debounced).
    pub const STEAM: u8 = 1 << 1;
    /// Hot water switch closed (machines that have one).
    pub const WATER: u8 = 1 << 2;
    /// A scale is connected and `scale_mg` is valid.
    pub const SCALE_OK: u8 = 1 << 3;
    // Bit 4 was STANDBY (the power rocker as an input) until v35: the rocker now switches the
    // machine's mains, the controller included, so a running board means the rocker is on.
}

/// One sample of the world: the cycle that just ended, reported at the tick that
/// ends it.
#[derive(Clone, Copy, Debug, Default, PartialEq, Eq)]
pub struct SensorFrame {
    /// Tick count since boot (one tick per mains cycle).
    pub cycle: u32,
    /// Crystal time of this tick, microseconds: `t0 + round(cycle * period)`.
    pub t_us: u64,
    /// Thermocouple EMF across the MCP3421's inputs, microvolts (hot junction against the
    /// cold junction at the board's socket). `Some` only on the tick a fresh conversion lands:
    /// the ADC makes 3.75 conversions a second (18 bit), so about every 16th tick at 60 Hz.
    /// `None` on the ticks between, and while the ADC isn't answering.
    pub tc_uv: Option<i32>,
    /// Cold junction (TMP117 beside the thermocouple socket), centi-degrees C. `Some` on the tick
    /// a fresh reading lands; `None` otherwise, and while the sensor isn't answering.
    pub cj_cc: Option<i16>,
    /// Pressure transducer after the 47k/100k divider, millivolts (oversampled average over the cycle).
    pub pressure_mv: u16,
    /// Peak-to-peak of the cycle's pressure samples, millivolts: the vibratory pump's stroke ripple,
    /// which the average removes. Flat with the pump off; large while it strokes.
    pub pressure_pp_mv: u16,
    /// Scale reading in milligrams. Only meaningful when [`input::SCALE_OK`] is set.
    pub scale_mg: i32,
    /// Digital inputs, see [`input`].
    pub inputs: u8,
}

/// What the engine wants the hardware to do for the next mains cycle.
#[derive(Clone, Copy, Debug, Default, PartialEq)]
pub struct ActuatorFrame {
    /// Echo of the sensor frame's cycle this answers.
    pub cycle: u32,
    /// Heater triac conducts for the whole cycle.
    pub heater: bool,
    /// Pump triac conducts for the cycle: exactly one stroke.
    pub pump: bool,
    /// 3-way solenoid energised (boiler connected to group).
    pub valve: bool,
    /// Front-panel lamps (power, coffee, steam): the levels the board drives on its LED pins
    /// (GPIO21/22/16) this cycle. Filled by the engine from [`panel_leds`] on the sensor frame's clock.
    pub lamps: [bool; 3],
    /// Engine state for telemetry / UI / scenario assertions. Not used by hardware.
    pub status: EngineStatus,
}

/// Coarse state of the engine.
#[derive(Clone, Copy, Debug, Default, PartialEq, Eq)]
#[repr(u8)]
pub enum EngineState {
    #[default]
    Boot = 0,
    Heating = 1,
    Ready = 2,
    Brewing = 3,
    BrewDone = 4,
    Steam = 5,
    HotWater = 6,
    Fault = 7,
    // 8 was Standby until v35 (the power rocker is a mains switch again); from_u8(8) reads as Fault.
}

impl EngineState {
    pub const ALL: [EngineState; 8] = [
        EngineState::Boot,
        EngineState::Heating,
        EngineState::Ready,
        EngineState::Brewing,
        EngineState::BrewDone,
        EngineState::Steam,
        EngineState::HotWater,
        EngineState::Fault,
    ];

    pub fn from_u8(v: u8) -> Self {
        Self::ALL
            .get(v as usize)
            .copied()
            .unwrap_or(EngineState::Fault)
    }

    pub fn name(self) -> &'static str {
        match self {
            EngineState::Boot => "boot",
            EngineState::Heating => "heating",
            EngineState::Ready => "ready",
            EngineState::Brewing => "brewing",
            EngineState::BrewDone => "brew_done",
            EngineState::Steam => "steam",
            EngineState::HotWater => "hot_water",
            EngineState::Fault => "fault",
        }
    }

    pub fn from_name(s: &str) -> Option<Self> {
        Self::ALL.iter().copied().find(|st| st.name() == s)
    }
}

/// The machine's three front-panel lamps (replaced by LEDs): `[power, coffee, steam]`.
/// - power: on whenever the controller runs (the power rocker switches its supply), fast blink on any fault;
/// - coffee: slow blink while heating for a shot, solid when ready (and while brewing);
/// - steam: in steam mode, slow blink until the boiler is within 3 C of the steam setpoint, then solid.
pub fn panel_leds(state: EngineState, faults: u16, temp_c: f32, setpoint_c: f32, t_ms: u64) -> [bool; 3] {
    let fast = t_ms % 200 < 100;
    let slow = t_ms % 1000 < 500;
    if faults != 0 || state == EngineState::Fault {
        return [fast, false, false];
    }
    match state {
        EngineState::Boot | EngineState::Heating => [true, slow, false],
        EngineState::Ready | EngineState::Brewing | EngineState::HotWater => [true, true, false],
        // Shot finished: the coffee lamp goes out until the rocker is turned back off.
        EngineState::BrewDone => [true, false, false],
        EngineState::Steam => [true, false, if (setpoint_c - temp_c).abs() <= 3.0 { true } else { slow }],
        EngineState::Fault => [fast, false, false],
    }
}

/// Fault codes. Stored as a bitmask so several can be active at once.
pub mod fault {
    /// Thermocouple EMF far over anything the boiler can make: probe or its wiring open (the
    /// board's 10 MOhm bias drives an open input to ~90 mV).
    pub const PROBE_OPEN: u16 = 1 << 0;
    /// Thermocouple EMF well negative: the probe reads far colder than the board, so its two
    /// wires are swapped in the plug.
    pub const PROBE_REVERSED: u16 = 1 << 1;
    pub const OVER_TEMP: u16 = 1 << 2;
    pub const TEMP_IMPLAUSIBLE: u16 = 1 << 3;
    pub const PRESSURE_SENSOR: u16 = 1 << 4;
    pub const OVER_PRESSURE: u16 = 1 << 5;
    pub const HEATER_INEFFECTIVE: u16 = 1 << 6;
    pub const NO_WATER: u16 = 1 << 7;
    pub const TEMP_RUNAWAY: u16 = 1 << 8;
    /// No thermocouple conversion arriving: the MCP3421 isn't answering on I2C.
    pub const TC_ADC: u16 = 1 << 9;
    /// Cold-junction sensor (TMP117) missing, or reading outside what a board inside the
    /// machine can be: without it the thermocouple can't be converted.
    pub const COLD_JUNCTION: u16 = 1 << 10;
    /// The pump is pushing water the engine never asked for: its triac (on the board) has failed
    /// shorted. Software can't stop it; the heater and valve go off and the UI says to unplug.
    pub const PUMP_STUCK_ON: u16 = 1 << 11;
    /// Every fault that leaves the engine without a trustworthy boiler temperature.
    pub const TEMP_SENSOR: u16 = PROBE_OPEN | PROBE_REVERSED | TC_ADC | COLD_JUNCTION;

    pub const NAMES: [(u16, &str); 12] = [
        (PROBE_OPEN, "probe_open"),
        (PROBE_REVERSED, "probe_reversed"),
        (OVER_TEMP, "over_temp"),
        (TEMP_IMPLAUSIBLE, "temp_implausible"),
        (PRESSURE_SENSOR, "pressure_sensor"),
        (OVER_PRESSURE, "over_pressure"),
        (HEATER_INEFFECTIVE, "heater_ineffective"),
        (NO_WATER, "no_water"),
        (TEMP_RUNAWAY, "temp_runaway"),
        (TC_ADC, "tc_adc"),
        (COLD_JUNCTION, "cold_junction"),
        (PUMP_STUCK_ON, "pump_stuck_on"),
    ];

    pub fn from_name(s: &str) -> Option<u16> {
        NAMES.iter().find(|(_, n)| *n == s).map(|(b, _)| *b)
    }
}

/// Engine-side view, reported every tick for telemetry. Engineering units.
#[derive(Clone, Copy, Debug, Default, PartialEq)]
pub struct EngineStatus {
    pub state: EngineState,
    /// Bitmask of [`fault`] codes.
    pub faults: u16,
    /// Index of the active profile phase (0xFF when not brewing).
    pub phase: u8,
    /// Filtered boiler temperature, deg C.
    pub temp_c: f32,
    /// Active temperature setpoint, deg C.
    pub setpoint_c: f32,
    /// Filtered pressure, bar (gauge).
    pub pressure_bar: f32,
    /// Profile target pressure, bar (NaN when flow-controlled).
    pub target_pressure_bar: f32,
    /// Estimated pump flow, ml/s.
    pub flow_ml_s: f32,
    /// Profile target flow, ml/s (NaN when pressure-controlled).
    pub target_flow_ml_s: f32,
    /// Weight in cup, g (NaN without scale).
    pub weight_g: f32,
    /// Seconds since brew start.
    pub shot_time_s: f32,
    /// Heater duty demanded by the controller, 0..1.
    pub heater_duty: f32,
    /// Pump duty demanded by the controller, 0..1.
    pub pump_duty: f32,
    /// How far above `setpoint_c` the boiler body is being driven so the water
    /// stays at setpoint while cold water flows in (deg C).
    pub boost_c: f32,
    /// Estimated group/portafilter heat-soak, 0..1 (1 = fully warmed).
    pub heat_soak: f32,
    /// Observer estimate of the boiler *water* temperature (the probe reads the
    /// boiler wall), deg C.
    pub water_c: f32,
    /// Estimated group/portafilter temperature, deg C.
    pub group_c: f32,
}
