brensch/coffee/crates/coffee-io/src/wire.rs

//! Tiny length-prefixed binary protocol used between the engine and the emulator
//! (over stdio pipes or TCP), and available to firmware for a USB "hardware bridge".
//!
//! Frame: `u16 LE payload length | u8 kind | payload`. All integers little-endian,
//! floats IEEE-754 LE. The protocol is lockstep: the emulator sends `Sensors`, the
//! engine answers with exactly one `Actuators` carrying the same `cycle`.

use crate::{ActuatorFrame, EngineState, EngineStatus, SensorFrame};

pub const PROTOCOL_VERSION: u16 = 4;   // v3: thermocouple + cold junction replace the NTC; v4: pressure ripple
pub const MAX_FRAME: usize = 3 + 96;

#[derive(Clone, Copy, Debug, PartialEq)]
pub enum Message {
    /// Opens a session. Sent by the machine side (emulator, or the PC end of a
    /// hardware bridge) with the mains frequency its frames are ticked at; the
    /// engine side answers with its own Hello.
    Hello {
        version: u16,
        mains_hz: u8,
    },
    Sensors(SensorFrame),
    Actuators(ActuatorFrame),
    Bye,
}

#[derive(Clone, Copy, Debug, PartialEq, Eq)]
pub enum WireError {
    /// Not enough bytes yet for a whole frame.
    Incomplete,
    UnknownKind(u8),
    BadLength,
}

const TC_NONE: i32 = i32::MIN;
const CJ_NONE: i16 = i16::MIN;

const K_HELLO: u8 = 1;
const K_SENSORS: u8 = 2;
const K_ACTUATORS: u8 = 3;
const K_BYE: u8 = 4;

struct W<'a> {
    buf: &'a mut [u8],
    pos: usize,
}
impl W<'_> {
    fn put(&mut self, b: &[u8]) {
        self.buf[self.pos..self.pos + b.len()].copy_from_slice(b);
        self.pos += b.len();
    }
    fn u8(&mut self, v: u8) {
        self.put(&[v]);
    }
    fn u16(&mut self, v: u16) {
        self.put(&v.to_le_bytes());
    }
    fn u32(&mut self, v: u32) {
        self.put(&v.to_le_bytes());
    }
    fn i32(&mut self, v: i32) {
        self.put(&v.to_le_bytes());
    }
    fn u64(&mut self, v: u64) {
        self.put(&v.to_le_bytes());
    }
    fn f32(&mut self, v: f32) {
        self.put(&v.to_le_bytes());
    }
}

struct R<'a> {
    buf: &'a [u8],
    pos: usize,
}
impl R<'_> {
    fn take<const N: usize>(&mut self) -> Result<[u8; N], WireError> {
        let s = self
            .buf
            .get(self.pos..self.pos + N)
            .ok_or(WireError::BadLength)?;
        self.pos += N;
        let mut a = [0u8; N];
        a.copy_from_slice(s);
        Ok(a)
    }
    fn u8(&mut self) -> Result<u8, WireError> {
        Ok(self.take::<1>()?[0])
    }
    fn u16(&mut self) -> Result<u16, WireError> {
        Ok(u16::from_le_bytes(self.take()?))
    }
    fn u32(&mut self) -> Result<u32, WireError> {
        Ok(u32::from_le_bytes(self.take()?))
    }
    fn i32(&mut self) -> Result<i32, WireError> {
        Ok(i32::from_le_bytes(self.take()?))
    }
    fn u64(&mut self) -> Result<u64, WireError> {
        Ok(u64::from_le_bytes(self.take()?))
    }
    fn f32(&mut self) -> Result<f32, WireError> {
        Ok(f32::from_le_bytes(self.take()?))
    }
}
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
