brensch/coffee/(commit log)

2026-11-02 Emulation-first espresso controller: engine, emulator, UI, firmware
    A Rust controller for a Gaggia Classic Pro E24, built and tested against a
    physics emulator before touching hardware.
    - coffee-core: no_std engine. Pressure loop linearised through the Ulka E5
    pump curve; temperature cascade on an observed water temperature with
    flow feed-forward; portafilter thermal model; profiles; safety supervisor.
    - coffee-node: the product shared verbatim by the PC binary and the ESP32
    firmware: engine, shot recording, profile library, the HTTP API as a pure
    function, rolling telemetry history, compact binary log and shot formats.
    - coffee-physics: coupled machine model (mains, vibratory pump,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
    [api.rs, chart.rs, config.rs, control.rs, diagram.rs, engine.rs]
2026-11-02 Controller board design, S3 firmware support, README BOM
    - hardware/controller: the controller board as code (SKiDL). ERC-clean, with
    isolation, firmware pin-map and boot-safe-SSR checks; generates KiCad
    netlists and BOMs for 230 V and 120 V. docs/CIRCUIT.md has every block,
    its calculations, layout rules and bring-up steps.
    - Audit fixes: SOT-223 3.3 V regulator (thermal), 47k zero-cross pull-up
    (pulse width), HLK-5M05 supply, flash-only USB policy.
    - Firmware builds for ESP32-C6 (default) and ESP32-S3 (`cargo +esp build-s3`)
    with per-chip pin maps; folder renamed firmware/esp32.
    - Plumbing: GaggiMate plumbing kit or generic G1/8 + G1/4 parts; transducer
    is G1/4 male.
    - README: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
    [bom-120v.csv, bom-230v.csv]
2026-11-02 Community profiles, grinds, profile picker, physics/UX fixes
    - Import 47 Decent and 4 GaggiMate profiles (licences in profiles/community/README.md)
    - Decent importer: soft limiter band (limit + range/2), volume stop from a phase
    - Every profile gets a grind (design point, author notes, or emulator sweep)
    - Fuzzy alphabetical profile picker; grind shown under the profile
    - Shot list reloads saved shots at startup
    - Engine keeps the shot tare after settling until the cup is lifted
    - Flushes don't use up shot numbers and chart as "flush"; flush prompt waits for hot water
    - Physics: check-valve seepage returns to the reservoir; conservation/sanity tests
    - Emulator UX: virtual barista regrinds pe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
    [cremina_lever_machine.json, e61_espresso_machine.json, low_pressure_lever_machine_at_6_bar.json, traditional_lever_machine.json, two_spring_lever_machine_to_9_bar.json]
2026-11-02 Docs: v2 board design, install plan, off-the-shelf survey, profile results
2026-11-02 Controller v2: integrated mains switching, ESP32-S3, routed PCB (230 V)
    - controller.py: triac channels (BTA16 heater across the brew-thermostat terminals,
    BTA08 pump, Z0109 valve) via MOC3063 zero-cross optos; onboard HLK-5M05; S3 pin map;
    isolation/pin-map/boot-safe/strap checks
    - layout.py: code placement, 7 mm isolation band + milled slots, hand-routed heater path,
    Freerouting 2.1.0 with retries, S-expression SES import, stub cleanup, pours, DRC, fab outputs
    - 230 V board: fully routed, 0 DRC errors; gerbers, drill, positions, PDF/SVG/PNG
    [bom-120v.csv, bom-230v.csv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]
2026-11-02 Controller v2: 120 V board routed (0 DRC errors), refreshed renders
    [coffee-controller-120v-B_Cu.gbl, coffee-controller-120v-B_Mask.gbs, coffee-controller-120v-B_Paste.gbp, coffee-controller-120v-B_Silkscreen.gbo, coffee-controller-120v-Edge_Cuts.gm1, coffee-controller-120v-F_Cu.gtl, coffee-controller-120v-F_Mask.gts, coffee-controller-120v-F_Paste.gtp]
2026-11-03 Controller v2: lane-based mains placement, Manhattan (90-degree) routing
    - Mains side as horizontal lanes (supply, zero cross, valve, pump, heater): opto -> resistors
    -> triac -> terminal on the left edge; J3 pin order follows the lanes (valve, pump)
    - Freerouting with snap_angle ninety_degree, 45-degree clean-up stage only if needed
    - 230 V and 120 V boards: fully routed, 0 DRC errors
    [bom-120v.csv, bom-230v.csv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]
2026-11-03 Controller v2: compact 99x71 board, heater pours, hand-routed heater gate
    - Placement compacted (120x80 -> 99x71): mains lanes tightened, 1206 drive resistors,
    7.5 mm X2 snubbers, connectors respaced; 0 courtyard conflicts
    - Heater path as copper pours on both layers; ~2 mm (pad width) at the triac's middle pin,
    4.5-6 mm elsewhere; R3 sits in the pour
    - Heater gate hand-routed on B.Cu (left-edge link to R4, y=55.2 run to the opto)
    - Back to 45-degree autorouting for the SELV logic; 0 DRC errors on both variants
    [bom-120v.csv, bom-230v.csv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]
2026-11-03 v6 software: per-mains-cycle engine, NTC + on-chip ADC, C6-only firmware
    - coffee-io: native SensorFrame/ActuatorFrame per mains cycle (NTC and
    pressure in ADC millivolts); MAX31855/ADS1115 decoders removed; wire
    protocol v2 with mains_hz in Hello.
    - coffee-core: engine ticks once per cycle; NTC (beta / Steinhart-Hart,
    two-point calibration) and pressure decoding with a gated self-zero;
    one pump stroke per pump-on cycle.
    - coffee-board (new, no_std, host-tested): crystal cycle clock, ADC
    oversampling, switch debounce, status LED, grid-drift stroke model.
    - coffee-physics: step_cycle (two half-cycles), millivolt sensors,
    ntc.* and heater_triac.* fault knobs; models gain [thermisto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
    [config.rs, diagram.rs, engine.rs, fit.rs, lib.rs, link.rs, machine.rs]
2026-11-03 v6 board routed (0 DRC errors), C6-MINI-1U, Wi-Fi firmware, coffee CLI
    Board (hardware/controller):
    - ESP32-C6-MINI-1U-H4 (105 C, U.FL, in stock at JLC), NTC thermistor and
    pressure on the C6's ADC1; no zero-cross detector, thermocouple amp,
    external ADC, pull-downs or big-triac gate resistors: 51 parts, 72 x 60.5 mm.
    - 800 V triacs and MOC3083 optos: sim showed the valve rings to ~2x line
    peak at turn-off. Both snubbers use one SMD X2 part (GA355, 10 nF).
    - Mains lint fixed: the per-part exemption now needs both items inside the
    same courtyard (it let neighbours sit 0.5 mm from opto/triac pins); the
    same-potential groups match the router's DSN classes (class_class rules).
    - All ma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
    [board.kicad_pcb, bom-120v.csv, bom-230v.csv, bom.csv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]
2026-11-03 v6 layout: tidy 45-degree mains routing, SELV re-placed, reliable router runs
    - Mains copper redrawn on a 0/45/90 grid (layout.py asserts it); valve
    triac escape stubs replaced by direct routes; heater gate straightened.
    - SELV re-placed so connectors sit next to their pins: brew/steam move to
    GPIO6/7 (plain GPIOs beside the analog pins; firmware and docs updated),
    pressure/thermistor/switch connectors stacked on the right edge, bottom
    edge cleared. Fewer long runs under the PSU.
    - Router harness: Freerouting 2.1 ignores -mp, so attempts now stop via
    --router.job_timeout (which also writes the session); one deadline per
    batch; per-attempt progress logs; winner chosen by unrouted,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
    [board.kicad_pcb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]
2026-11-03 Keep v6 as first routed C6 board; current layout becomes v7
    [board.kicad_pcb]
2026-11-03 v8: compact board (72 x 56.5 mm), 22 vias, DRC clean
    - Opto lanes at the 2 mm minimum pitch; pump lane up 3.2 mm, heater lane
    up 4 mm (-7% area vs v7). The pump snubber joins live by a short
    bottom-layer branch off the trunk, clear of the valve gate parts.
    - Low-voltage side re-flowed for the shorter board: 22 vias (v7: 26),
    660 mm of track, no DRC errors or warnings.
    - v7 kept as its own snapshot; viewer, docs, JLC files and audit pack
    updated.
    [board.kicad_pcb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]
2026-11-03 v9: parts chosen for a hot, long life (85 C PSU, ceramic-stable LDO, 24 A heater terminal)
    Component audit against a 60-70 C case interior over years:
    - PSU: HLK-PM05 (listed ~60 C) -> RECOM RAC03E-05SK/277: -40..+85 C,
    full load to 75 C, EN60335-1 household / IEC61558 / UL62368, 4 kV
    reinforced, built-in fuse, no external parts. Footprint drawn from the
    datasheet (lib/Recom.pretty); AC pins fed from outside the pair.
    - Regulator: AMS1117 (needs tantalum ESR, can oscillate on ceramics) ->
    TI TLV1117LV33, same pinout, 455 mV dropout.
    - Heater terminal: MKDS 1,5 (17.5 A) -> MKDS 3 (24 A) for 11.4 A hot.
    - Bulk caps pinned to Murata X7R (125 C); no electrolytics anywhere.
    - Audit table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
    [board.kicad_pcb, bom-120v.csv, bom.csv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]
2026-11-03 v10: two-sided board (64.5 x 56.5 mm): small SMD parts under the PSU on the bottom side
    Top side keeps only what you interact with: C6 module, one row of sensor/switch
    connectors, USB-C on the bottom edge. Regulator, dividers, EN RC, decoupling
    and the USB diode sit on the bottom side in the area under the PSU. JLC files
    fixed: PSU is hand-soldered, regulator pinned to the genuine TI part (C15578).
    25 vias, 0 unconnected, 0 violations. v1-v9 kept.
    [board.kicad_pcb, bom-120v.csv, bom.csv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]
2026-11-03 jlc.py: match 0805 capacitors
    [bom.csv]
2026-11-03 JLC matching enforces X7R; C5 marked X7R (no 85 C X5R parts on the board)
    [bom-120v.csv, bom.csv]
2026-11-03 v11: no mounting holes (enclosure holds the board by its edges); 3D models for MKDS 3, 2220, 0805; floorplan.py
    - Mounting holes removed; docs updated.
    - floorplan.py: large-parts-first placement study (real footprints, isolation
    polygon, overlap/band checks in seconds). A stepped band came out no
    smaller than the vertical band for these parts.
    - 0 unconnected, 0 violations, 29 vias. v1-v10 kept.
    [board.kicad_pcb, bom-120v.csv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]
2026-11-03 Datasheet audit fixes, rail-sense firmware, co-simulation, own router and layout sandbox
    Audits (hardware/controller/datasheets/audit-*.md) against the manufacturers' datasheets:
    - RECOM footprint was wrong: pins at 0/5.08/30.48 mm, outputs at 25.4/30.48 (was 0/2.54/25.4)
    - MOV removed (fire risk behind a 500 mA fuse; RECOM passes 1 kV surge unaided; 800 V switches)
    - Q2 BTA08-800CW -> 800BW (ST's CW grade is 600 V only), opto MOC3083TVM, J2 1711725
    - antenna connector is W.FL / MHF III, not U.FL; opto isolation 4170 VAC
    - Z0109 valve triac kept: ~5x commutation margin at the valve's low dI/dt (Fig. 10)
    Schematic: rail sense (3V3/2 -> GPIO2, 5V/3 -> GPIO3), switch 4.7k pull-ups + 1k series,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
    [audit.py, config.rs, control.rs, controller.py, cosim.py, fit.rs, jlc.py, layout.py]
2026-11-03 v12: 54 x 51 mm, routed end to end by my own router, DRC clean
    - 54 x 51 mm (2754 mm2): -24% vs v11 (3640 mm2), 57 parts
    - placement from the layout sandbox: barrier hugs the RECOM's AC pins, module under the PSU's
    LV half, optos stacked under the PSU, mains connectors down the left edge (J1 relabelled
    N/L so live never crosses neutral), heater corner pre-routed on both layers with its gate
    looping round the edge, all LV SMDs on the module's side
    - mainsroute.py routes everything: mains (2.0 mm between nets, 0.5 mm inside a part's
    courtyard, DRC-driven strict nets), then SELV (0.2 mm, USB pads grid-aligned), GND fan-out
    vias before signals, pours + stitching, isolated GND groups jo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
    [board.kicad_pcb, board.step, bom-120v.csv, bom.csv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]
2026-11-03 sim: valve commutation checked against the Z0109's own (dI/dt)c, pump at 60 Hz
    The valve check compared turn-off dv/dt with the opto's static 600 V/us (audit-mains.md).
    Now the coil current's slope approaching zero is measured and checked against Z01 Fig. 10
    (~0.37 A/ms allowed at 10-16 V/us): 0.037-0.042 A/ms, ~9x margin. Pump sim at 60 Hz, 120 V.
    49/49 checks pass.
2026-11-03 router: no-connect pads block vias, GND tree anchors, small-part labels hidden
    - blocked("") (keep clear of everything) skipped no-connect pads as if same-net: a repair
    via could land 0.2 mm from an NC pin (seen at W=53, not in v12)
    - GND_TREE / GND_ANCHORS: tie pads the pour can't reach to chosen anchors during routing
    - silkscreen: only parts you wire to or hand-solder keep their reference labels
    W=53 tried with 16 seeds: every signal routes but one ground group stays isolated each time,
    so v12 (54 x 51) stands.
    [layout.py]
2026-11-04 v13: single-sided assembly, 56 x 51 mm, DRC clean
    - every SMD part on the bottom (USB-C too, opening still at the edge): one JLC assembly side,
    one reflow for the ESP32 module, no fine-pitch hand soldering
    - 2 mm wider than v12 for room on the bottom; -22% vs v11; mains still 4 vias
    - mains snubbers re-placed around a reserved valve-line corridor (plan keepout)
    - plan.json carries its routing settings ('route'), so python3 layout.py reproduces the board
    - jlc.py: BOM lines merged by LCSC part; U4 placed at its body centre (origin is 2.05 mm off)
    - C8-C11 named 100nF X7R (same part as C4)
    [board.kicad_pcb, board.step, bom-120v.csv, bom.csv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]
2026-11-04 JLC position file solved against JLC's own footprints; power-cut-proof storage
    jlc_cpl.py fetches each LCSC part's EasyEDA footprint and solves the angle and position at which
    JLC's pads land on the real board pads (JLC mirrors bottom parts about Y: angle 180 - KiCad's,
    plus per-part library differences). Every part fits within 0.15 mm, angle uniquely determined.
    The previous file had U4, D1 and D2 rotated 180 deg on the bottom (J4 was caught in JLC's preview).
    kv.rs: multi-chunk values are written as a new generation and committed by the head record
    (generation + CRC32); reads verify the CRC, deletes remove chunks; on 'corrupted' the map is
    repaired by sequential-storage (a single fetch) b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
    [C12624.json, C145131.json, C14663.json, C15578.json, C17930.json, C20627095.json, C21190.json, C22775.json]
2026-11-04 v14 candidate: J1 N/L in the schematic, connector labels, Murata X2 land, opto pitch 9.2, TO-220 1.2 mm; LV routed by fastroute
    - J1 is 1=N 2=L in the schematic itself (no layout swap): board, BOM and INSTALL.md agree;
    N/L printed beside it (footprint audit must-fix)
    - silkscreen labels for every connector (MAINS IN N/L, HEATER, VALVE/PUMP, NTC,
    PRESSURE +5V/SIG/GND, SWITCHES BREW/STEAM/GND); small-part refs hidden
    - lib/Coffee.pretty: X2 caps on Murata's GA355 reflow land; TO-220 with 1.2 mm holes
    - optos at 9.2 mm pitch (body tolerance), board 56 x 52 mm
    - routing: mains by mainsroute.py behind a KiCad-DRC gate (race.py); LV and ground by
    fastroute 0.1.14 (ext_route.py; Specctra can'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
    [bom-120v.csv, bom.csv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]
2026-11-04 v14: connector labels, top-hat bean, J1 N/L native, footprint fixes; KiCad schematic export
    - silkscreen() draws every board label and the bean logo (logo/tophat.svg 2a) as strokes;
    apply_silk.py redraws it on a finished board without rerouting
    - gen_kicad_sch.py: a native .kicad_sch/.kicad_pro from the SKiDL parts, PCB footprints linked
    to their symbols; round-trip netlist via kicad-cli: 197 pins, 0 mismatches
    - build/coffee-quilter.zip: schematic + board with our mains copper, LV left to Quilter
    - build/coffee-v14-{gerbers.zip,bom.csv,cpl.csv}: JLC upload set (CPL solved against JLC's
    footprints); DRC 0 electrical errors
    - docs: 56 x 52 mm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
    [board.kicad_pcb, board.step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]
2026-11-04 Route with fastroute end to end; delete the home-made router
    - Delete mainsroute.py and race.py, plus every own-router path in layout.py
    (mains/SELV routing, escape stubs, hand pre-routes, GND repair routing,
    old Freerouting batch driver). layout.py is placement only now.
    - ext_route.py: fastroute routes every net. Its input step models the triac
    pins as 0.2 mm points (Specctra has no per-part rule, so at 2.3-2.54 mm pitch
    no track could leave a real pad 2 mm clear), gives the valve triac its own
    image with a keepout for the middle pad's halo, and runs --diagnose and
    --live. KiCad's DRC checks the real pads afterwards.
    - jobs_watch.py + out/view/jobs.html: live job monitor. Shows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
    [coffee-controller.kicad_pcb, coffee-controller.kicad_sch]
2026-11-04 v7 schematic: low voltage only, external SSRs/relay/5 V module
    Mains section removed (terminals, fuse, RECOM, triacs, optos, snubbers).
    5 V in on J1 with P-MOSFET reverse protection; three AO3400A low-side
    outputs (J2 heater, J3 pump, J8 valve) with gate pull-downs (off at boot),
    flyback diodes and indicator LEDs. All SMD on one side; one JST PH SMD
    connector type; JLC basic parts where one exists (1 % resistors, X5R
    caps, red LEDs); two M3 holes. Firmware pin map unchanged.
    [controller.py]
2026-11-04 v7 sims: outputs, boot safety, reverse polarity, rails (59/59 pass)
    ngspice: every output on at the corners (GPIO 3.0 V, AO3400A Vth max,
    +5V 4.6 V USB) with the pump SSR (EZ240D5, 4 V must-operate), heater SSR
    and relay coil; flyback spike 5.8 V; gate held off during reset against a
    20k internal pull-up -> gate pull-down 3.3k (100k would have switched the
    heater on at boot); P-FET drop 10 mV and 5 nA reverse; 1 % resistor error
    budget. Mains blocks (triac drive, snubbers, commutation) removed.
    [controller.py, run.py]
2026-11-04 v7: LV layout pipeline; smaller parts (ME6211 SOT-23-5, B5819W, JST GH)
    layout.py: no isolation band/slots/mains rules; JLC standard rules (0.15
    min track/gap, 0.3 drill, 0.6 via, 0.3 edge); pours and stitching over
    the whole board; connector labels from the plan. ext_route: triac pad
    model removed. Schematic: JST GH SM03B-GHS-TB (latching, 8.2x6.4 mm),
    ME6211C33 LDO, B5819W, one 1 mm BOOT pad, no mounting holes. Sims 59/59.
    [bom-120v.csv]
2026-11-04 v7: lean outputs (FET + 3.3k pull-down; flyback on the valve relay only); placement checker
    Per-output LEDs (modules have their own), gate series resistors and the
    SSR-channel flyback diodes removed: 47 parts. Sims 59/59, including the
    relay flyback (5.8 V) and SSR turn-off (3.9-5.1 V with 1 uH cable).
    check_place.py: courtyard overlaps + a ratsnest picture of a plan; it
    moves nothing.
    [bom-120v.csv]
2026-11-04 v7 board: first complete fastroute routing, 38 x 28 mm, 0 unconnected, 0 copper DRC errors
    Hand placement (connectors on all four edges by the module pins they serve,
    sensor dividers under the module's bottom pins, rail dividers by rail),
    routed end to end by fastroute 0.1.14 (16 restarts, 100 passes). DRC
    checks clearance at 0.15 mm (router targets 0.2; JLC minimum 0.127).
    Silkscreen labels still to place.
    [layout.py]
2026-11-04 v7 board: 37.3 x 27 mm, fully routed by fastroute, 0 DRC copper errors, 62 vias
    Height -1 mm (sensor rows packed to the 0603 pitch, J7 raised), width
    -0.7 mm (output FET column against the module), USB diode under the
    module, BOOT pad moved to the bottom (bare pad, no assembly), cluster
    resistors rotated so same-net pads face each other.
2026-11-04 v15 (LV only): 37.3 x 27 mm, DRC clean, JLC order files
    Bottom-silkscreen labels: a word behind every connector pin, the name
    under each connector's body, logo, title and BOOT. Footprint silk that
    reached the board edge removed. KiCad DRC: 0 violations (only the
    library-table notes of a vendored-footprint board), 0 unconnected.
    JLC: 21 BOM lines, 4 extended part types (GH connector, USB-C, ESP32
    module, LDO), the rest basic; CPL solved against JLC's footprints, all
    46 parts land (Q4 land tolerance 0.35; D2 via same-package proxy while
    EasyEDA's API refuses this machine: check D2 in JLC's preview).
    Snapshot: versions/v15-lv-only.
    [C15127.json, C15849.json, C15850.json, C165948.json, C20917.json, C2286.json, C22978.json, C25981.json]
2026-11-04 docs: v15 low-voltage board (CIRCUIT, INSTALL, PARTS, HARDWARE, ARCHITECTURE)
    CIRCUIT.md rewritten for the LV board: blocks, pin map, layout, rules,
    simulation and what needs a human. INSTALL.md: order settings (1 oz, all
    SMD, no hand soldering, no coating), bench checks at the output
    connectors, wiring -> WIRING.md. PARTS.md from the live JLC match.
    HARDWARE.md: design rules with modules doing all mains switching.
2026-11-04 v15: native KiCad project (schematic + linked board), netlist round-trip 180 pins, 0 mismatches
    [coffee-controller.kicad_pcb, coffee-controller.kicad_sch]
2026-11-04 Buy list + wiring for the LV build; thermistor default B = 4267
    docs/BUY.md: every off-board part with a link opened in a real browser on
    2026-11-04 (price, stock) and its datasheet: Schneider SSP1A125BDT heater
    SSR, Auber HS25ET heatsink, Crydom EZ240D5 pump SSR, Phoenix PLC-RSC-5DC/21
    valve relay (single unit), RECOM RAC05-05SK/277/W, Bussmann GDC-1A fuse,
    JST GH leads, spade kit, wire, Semitec 104NT M4 probe, MHF3 antenna path.
    ~$278 from verified listings; unverified items listed. docs/WIRING.md +
    wiring.svg: diagram and terminal-by-terminal table, checks before mains.
    Thermistor default B 4267 (the probe bought) in engine and emulator; fit
    test made relative to the default; sims 59/59 w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
2026-11-04 v15 3D view: real models for every part
    Fetched the KiCad STEP models the old parts list never needed (JST GH
    SM03B-GHS-TB, SOT-23-5, SOD-123). kicad-packages3D has no model for the HRO
    TYPE-C-31-M-12 that its footprint names, so render3d maps it to the GCT
    USB4105 model (same 16-pin top-mount body, same origin). No stand-in boxes
    left. Board file unchanged; only the v15 renders are regenerated.
    [board.step]
2026-11-04 Pre-fab review fixes: status LED D1 polarity in the CPL; back-feed note
    Independent review found D1 (KT-0603R, C2286) would be placed reversed:
    JLC numbers that LED 1 = anode, KiCad's LED_0603 1 = cathode, and the CPL
    solver matched pads by number. jlc_cpl.py now maps JLC pads to board pads
    by function for such parts (PAD_MAP); D1 rotation 180 -> 0. D2 confirmed
    from JLC's own footprint/symbol drawings (pin 1 = cathode, same side as
    the proxy). Stale J4 ROT_FIX removed. Docs: with USB alone ~4.6 V appears
    on J1 through Q4 (harmless), D2 only keeps the module out of the PC.
    [coffee-v15-cpl.csv, cpl.csv]
2026-11-04 jlc_pins.py: pin-function gate for JLC assembly
    For every placed part, compare JLC's own symbol pin names with the
    schematic's pin names pad by pad (after jlc_cpl's PAD_MAP), handling
    JLC's combined USB-C names (A1B12, EH shell legs). 94 pin functions,
    0 mismatches; proven to flag the D1 reversal when its fix is removed.
    jlc.py now fails if it doesn't pass.
    [C8598.svgs.json]
2026-11-04 v16: review round 1 fixes
    Electrical: R27 1k between the thermistor node and GPIO1 (a 5 V plug in
    J5 was unlimited into the clamp diode; now 1.2 mA); open-probe threshold
    3270 -> 3200 mV (ADC +-40 mV near the top of its range; a cold <6 C boiler
    also faults, heater off). Assembly: USB-C locating-post holes 0.95 mm
    (KiCad and JLC footprints disagree by 0.18 mm), paste on the shell legs,
    separate PTH/NPTH drill files. Docs: first power-on keeps the heater
    connected (HEATER_INEFFECTIVE latch), valve live identified before the
    switches are stripped, GH leads spliced to 18 AWG pigtails, stale
    opto-triac comments in firmware. Sims 60/60; JLC gates pass (47 parts,
    94 pin functions). Snapshot versio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
    [board.kicad_pcb, board.step, bom-120v.csv, bom.csv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]
2026-11-04 v17: review round 2 fixes
    Firmware: open-thermistor check on the raw ADC value (before the rail
    rescale), NTC_MIN_C floor, EngineConfig::check() with hard limits on
    every safety-relevant field (SetConfig rejects, a bad stored config
    falls back to defaults), stale-ADC fault after 30 cycles.
    Board: C4 level with the module's 3V3/GND pins, C3 just below; USB-C
    moved to the datasheet's PCB-edge line (0.46 mm overhang); peg holes
    1.1 mm; stitching vias kept out of every pad (were landing in GND SMD
    pads) on a 1.2 mm grid, so one top GND pour now holds every power
    ground; silk text >= 1.0 mm / 0.16 mm stroke, no silk overlaps; title
    v17. fastroute: 0 unrouted, 49 vias; DRC 0.
    Docs: via covering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
    [board.kicad_pcb, board.step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]
2026-11-04 Review round 3 fixes (in progress)
    Firmware/engine: EngineConfig::check() now passes on the defaults
    (max_temp_c 165 and max_boost_c 16 failed it, so no config could be
    saved) with a test; it also bounds ntc debounce/filter, Steinhart-Hart
    (must agree with beta within 5 C), PID gains, the pressure sensor and the
    no-water check; steam setpoint <= 142 C (thermostat ~145). Heater-
    ineffective arms on high duty in brew mode (catches an open-but-in-range,
    detached or stuck probe), 30 s / 10 C. Firmware: 3V3 rail-sense outside
    +-5 % reports the thermistor open; stale fallbacks use raw values (no
    compounding); pressure stale -> 0 V fault.
    Board: USB-C peg holes 1.0 mm with 0.2 mm hole-to-copper ru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
    [coffee-controller-120v-B_Cu.gbl, coffee-controller-120v-B_Mask.gbs, coffee-controller-120v-B_Paste.gbp, coffee-controller-120v-B_Silkscreen.gbo, coffee-controller-120v-Edge_Cuts.gm1, coffee-controller-120v-F_Cu.gtl, coffee-controller-120v-F_Mask.gts, coffee-controller-120v-F_Paste.gtp]
2026-11-04 v17 build: best fastroute session (one top GND pour) finished under the 0.2 mm hole rule; mains datasheets verified
    Phoenix relay from Phoenix's own catalog exports (4.2-7 V input, 60 C max
    ambient, reinforced isolation, AC15 3 A); Eaton S505-1-R (TD 2037) and
    HTB-26M-R holder (TD 2119, UL E14853) replace the unlisted Amazon holder;
    SSP1A125BDT derating curve read (11.4 A fine on the 2 C/W sink).
    ext_route.py: SES_REUSE re-finishes an earlier fastroute session.
    [coffee-controller-120v-B_Cu.gbl, coffee-controller-120v-B_Mask.gbs, coffee-controller-120v-B_Paste.gbp, coffee-controller-120v-B_Silkscreen.gbo, coffee-controller-120v-Edge_Cuts.gm1, coffee-controller-120v-F_Cu.gtl, coffee-controller-120v-F_Mask.gts, coffee-controller-120v-F_Paste.gtp]
2026-11-04 v18 board: datasheet-driven part changes
    - U5 TLV1117LV33DCYR (SOT-223, TI C15578, pinned: another maker's 12 V
    part shares the name). The SOT-23-5 ME6211's 300 mW rating implies
    ~333 C/W: +57 C at the C6's ~100 mA average, past Tj 125 C at 70 C.
    TI: RthJA 62.9 C/W -> +11 C; ceramic-stable.
    - Thermistor: Molex 218537-3919 50k ring-tab (fully specified; the
    Trianglelab assembly has no datasheet). R15 4.7k; firmware
    Steinhart-Hart from Molex's table; emulator probe lag 15 s.
    - Pressure: TE M3200 needs a load > 100k: divider 47k/100k (147k),
    C9 22 nF (basic C21122), range 17.24 bar.
    - USB-C to HRO's drawing: 0.60 mm peg holes, 1.4 mm front slots.
    - Board 43 x 27 mm (SOT-223 with C4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
    [C21122.json, C25803.json, C25819.json, C48937499.json, C696861.json, bom-120v.csv, bom.csv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]
2026-11-04 Docs: every off-board part from maker datasheets; heater legs to 14 AWG
    TE rates 6.35 mm FASTONs 10 A on 16 AWG, 15 A on 14 AWG (108-2017,
    108-2043); the heater draws 11.4 A, so M10/M11 become 14 AWG Tensility
    UL 3530. Wire: CnC UL 3135; terminals TE 2-520183-2 / 3-520107-2 /
    325199; sleeve Techflex SFAG; WAGO US rating 600 V/20 A, 85 C max.
    Transducer: TE M3200 (datasheet verified), variant to choose (cable +
    UNF adapter, or Packard + Aptiv plug). GaggiMate docs cited for the
    machine's fittings and connectors.
2026-11-04 Snapshot versions/v18-datasheet-verified
    [board.kicad_pcb, board.step]
2026-11-05 Review round 4 fixes
    Engine:
    - HEATER_INEFFECTIVE is now an energy balance: heat delivered minus a
    200 W loss bound over a 5000 J/K capacity bound is the least the
    reading must rise in 120 s. Catches a probe stuck at any value (old
    check missed one stuck a few degrees low at ~0.3 duty); disarmed in
    steam mode (no long-steam false trip) and for 90 s after water moves.
    - Heater duty average and energy count only delivered heat (after the
    fault override).
    - Probe-lag compensation for control (ntc.probe_lag_s, 15 s per Molex):
    removes the post-shot overshoot the slower probe caused.
    - Temperature-rate NaN guard: a zero-dt tick made the rate NaN for good,
    which silently disabled TEM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
    [coffee-v18-cpl.csv, cpl.csv]
2026-11-05 Review round 5 firmware fixes; parts evidence store
    - check() bounds every model field that reaches the heater or pump
    (inlet temp, brew boost conductances, flow_kp_scale, water/group
    models, ready band, pump curve, pressure PID limits incl. min <= max):
    a config that passed could make the duty NaN and disable the
    energy-balance and runaway checks, force 100 % heat, invert the loop,
    or panic the engine.
    - Engine: non-finite duties become 0 and are clamped before they are
    applied or counted; non-finite water/group estimates restart.
    - PID derivative on the plain reading (Pid::update_split), P/I on the
    lag-compensated one; lead clamped to +-5 C. Sub-threshold EMI spikes
    no long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
    [config.rs, control.rs, controller.py, engine.rs, lib.rs, machine.rs]
2026-11-05 Cheapest-safe buy list (~$211 from ~$331); round 5 doc fixes; evidence store filled
    - BUY: same verified mains parts from US distributors (EZ240D5 $15.70,
    Phoenix $19.46 at RS/Allied), HTB-22M-R holder; one wire gauge (14 AWG
    Tensility UL 3530) for everything, TE 16-14 FASTONs only, no forks, no
    sleeve (200 C wire; the old sleeve didn't fit a FASTON), one WAGO,
    half-cut genuine JST jumpers, 3M FP-301 black heat-shrink (UL E-39100).
    - WIRING: new mains table; unplugged L/N identity checks via the
    polarised plug; steam-thermostat-in-series check; pump fuse refit;
    heatsink mounting options; monoblock receptacles.
    - INSTALL: case closed before every mains power-on, leak check by
    un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
    [bom-120v.csv]
2026-11-05 Safety level set to GaggiMate's (user); GaggiMate Lego-class parts
    - BUY: GaggiMate Lego class, fitting inside the machine: 1-channel
    G3MB-202P SSR boards for pump and valve (+ AC snubber on the valve),
    GaggiMate's 5 V 2 A module, no external fuse, no DIN rail/relay, 18 AWG
    silicone, 6.35 mm spades/piggyback/forks, AliExpress GH leads. Kept by
    the user's choice: a genuine Schneider SSP1A125BDT heater SSR (same
    puck size as the 40-DA), panel-mounted on the rear slots like
    GaggiMate, Auber heatsink only if its base exceeds 80 C. ~$95-115.
    - WIRING: new mains table (3-way L splice, SSR boards' VCC+IN on J3/J8
    pin 1, GND on pin 2), snubber placement, mounting on plastic; round-6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
2026-11-05 Docs: remove stale Crydom/relay/fuse/heatsink/WAGO text after the GaggiMate-class switch; BUY item numbers
    Final sanity pass: wiring electrically sound at GaggiMate's level; J3/J8
    drive of high-level G3MB-202P boards (VCC+IN on pin 1, GND on pin 2)
    works with no back-powering.
2026-11-05 Front panel + drip-tray scale: schematic, firmware, engine, UI
    - Schematic: J7 becomes a 7-pin GH front panel (power/brew/steam
    rockers as dry contacts, three lamps replaced by LEDs on IO21/IO22/
    TXD0 via 330R); J10 6-pin GH for a dual-HX711 drip-tray scale (5V,
    3V3, GND, SCK on RXD0, DOUT on IO4/IO5; 100R series, SCK pull-down).
    IO4/IO5 (MTMS/MTDI) strap only SDIO clock edges (C6 datasheet).
    - Engine: STANDBY input (power rocker off) -> Standby state, all outputs
    off; the controller stays powered. Scale calibration config.
    - coffee-io: panel_leds (power/coffee/steam lamp logic), shared by the
    firmware and the UI. Firmware: power switch, panel LEDs, HX711 reader
    (critical-secti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
    [config.rs, control.rs, controller.py, engine.rs, layout.py, lib.rs, main.rs]
2026-11-05 v19 board: front panel (7-pin) + drip-tray scale (6-pin), symmetric connectors
    fastroute: 0 unrouted, 94 vias; fresh-load DRC 0; JLC gates pass (57
    parts, 92 pin functions; SM07B C495552, SM06B C133065). Docs: power
    switch as a two-pole split (live pole still cuts the loads, neutral
    pole becomes the standby input, 5 V supply on unswitched mains), LEDs
    replace the 120 V lamps, scale parts (Gaggiuino layout) and
    calibration, v19 pin map and holder spans. Snapshot
    versions/v19-front-panel-scale.
    [C133065.json, C23138.json, C495552.json, board.kicad_pcb, board.step, bom-120v.csv, bom.csv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]
2026-11-05 v19 3D render with the real 6/7-pin GH models
    [board.step]
2026-11-05 v20 board: 40 x 24 mm, eight GH connectors 4+4 on the bottom, hand-soldered
    Placement by hand, part by part (plan.json): each connector's resistors and
    capacitors sit on the top directly over it; JLC assembles the top side only
    and jlc.py moves the bottom-side connectors to hand.csv. fastroute: 0
    unrouted, 86 vias; fresh-load DRC 0 (courtyards, silk and copper clean);
    JLC gates pass (49 placed parts, 92 pin functions, 0 mismatches). Bottom
    silk: pin words beside each connector; J6 and the J7 LED pins get one-line
    legends where the USB-C shell legs come through. layout.py gains plan
    options label_skip / label_name_pos / label_off and angled bottom_text.
    Docs: board size, hand-solder step, hol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
    [board.kicad_pcb, board.step, bom.csv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]
2026-11-05 v21: bottom silk tidy (J7 named FRONT, no "low voltage only", bean logo back)
    Same copper as v20 (session re-finished); fresh-load DRC 0; JLC gates pass.
    Snapshot versions/v21-silk-front-bean; files coffee-v21-*.
    [board.kicad_pcb, board.step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]
2026-11-05 JLC files for two-sided assembly (jlc.py --both-sides)
    build/coffee-v21-2side-{bom,cpl}.csv put the eight GH connectors on the
    bottom for JLC Standard PCBA. Both gates run on the two-sided set: every
    connector's JLC footprint lands on its pads at one unique angle (0.000 mm),
    92 pin functions match. The top-only files are unchanged.
    [bom.csv, coffee-v21-2side-bom.csv, hand.csv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]
2026-11-05 v22 variant: every part on the top side (44.5 x 29.4 mm)
    For one-sided Economic PCBA with nothing to hand-solder. Placement by hand
    (plan.json): module at the right edge with its pinless side outward,
    connectors 4+4 on the long edges with their parts directly inside them,
    LED resistors in the strip between the module and J7, EN/decoupling in
    the strip above it. fastroute 0 unrouted, 79 vias; fresh-load DRC 0; JLC
    gates pass (57 parts, 92 pin functions, 0 hand-solder). v21 files stay in
    build/ beside the coffee-v22-* files. check_place.py can dump pad positions
    (PADS_OUT). Snapshot versions/v22-all-top.
    [board.kicad_pcb, board.step, bom.csv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]
2026-11-05 v23: the connector rectangle (37.8 x 26.4 mm, every part on top)
    Eight GH connectors butted 4+4 along the long edges, the ESP32 module at
    the right end touching both rows; everything else fits in the space left
    of the module. Placement by hand, grouped by which module edge each part
    connects to: 5 V in + power corner top-left, NTC/pressure parts under
    their pins near the ADC pins, scale over the module's DOUT pins, front
    panel beside the module's switch and LED pins.
    Schematic (52 -> 50 parts placed by JLC, 47 on the CPL):
    - 0603 -> 0402 passives (basic parts; 100n/22n pinned to C1525/C1532)
    - USB-C, R13, R14 -> 4 bare programming pads underneath (J4, unfitted)
    - D1/R12 status LED -> bare S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
    [C107017.json, C11702.json, C25104.json, C25741.json, C25744.json, C25765.json, C25792.json, C25890.json]
2026-11-05 Front panel: clickable emulated switches, real lamp outputs; switch waits for Ready; pressure ki 8
    - ActuatorFrame gains `lamps`: the engine computes the three front-panel lamp
    levels each cycle (panel_leds on the sensor frame's clock); the firmware
    drives GPIO21/22/16 from them and telemetry reports them (sent on every lamp
    or input edge), so the UI shows exactly what the pins do. Wire format: flag
    bits 3-5.
    - Emulator: front-panel power rocker (switch.power -> input::STANDBY). In the
    UI the three rockers are buttons when the emulator is connected: a click
    flips the emulated switch, which reaches the engine as the real debounced
    input (coffee on = start, off = stop). Verified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
    [config.rs, control.rs, engine.rs, lib.rs, machine.rs, wire.rs]
2026-11-05 v24: USB-C back at the edge, status LED on U0TXD, review fixes (46.6 x 26.4 mm)
    Board (placement by hand: v23 shifted right by a new 8.8 mm left column):
    - USB-C J4 + 5.1k CC resistors back at the left edge; the LDO moves to the
    top-left corner above it, beside 5 V in. Fully routed, 72 vias, DRC 0.
    - Status LED D1/R12 on GPIO16 (U0TXD): flickers with the ROM boot log,
    glows in download mode, then the firmware heartbeat. Steam lamp -> GPIO23
    (it lit at every boot on TXD0: review M1). Firmware pin map updated.
    - J1 is a 2-pin GH (SM02B-GHS-TB, C189893): the 5 V lead can no longer swap
    with a 3-pin output lead and back-feed a load on (review S1).
    - Switch pull-ups 4.7k -> 10k: closed re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
    [C189893.json, C25905.json, board.kicad_pcb, board.step, bom-120v.csv, bom.csv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]
2026-11-05 v25: one row of 8 connectors, upright corner mount, M3 holes (73.2 x 24 mm)
    All eight GH connectors along the top edge so every cable leaves one side:
    the board stands in the back-right corner (GaggiMate's spot, from their
    install photos) with the cables going up into the loom. Order by what each
    connects to: 5 V in by the USB-C/power block, the outputs with their
    drivers under them, the sensor inputs, the front panel beside the module's
    switch and LED pins, the scale over the module's DOUT pins. Two unplated
    M3 holes on the bottom edge. Placement by hand; fastroute 0 unrouted, 69
    vias; DRC 0; JLC gates pass (52 parts, 90 pin functions).
    Extended-part fees: JLC's library has no basic or pre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
    [board.kicad_pcb, board.step, bom-120v.csv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]
2026-11-05 v26: ESP in the middle, 0603 passives, M3 holes in the corners (73.2 x 26 mm)
    One row of 8 connectors along the top edge with a parts strip under it, each
    connector's parts under its pins; the module in the middle (rot 180, pinless
    side down, pins facing every connector, front panel right over its switch
    pins). 0603 again (same JLC price as 0402, all basic). M3 holes in the
    bottom corners. Stitching on a 4 mm grid (37 vias). Placement by hand;
    fastroute 0 unrouted, 66 vias; DRC 0; JLC gates pass (52 parts, 90 pins).
    [board.kicad_pcb, board.step, bom-120v.csv, bom.csv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]
2026-11-05 v27: module straight against the plugs, 7-LED indicator panel, velcro mount
    - The ESP32 module touches the connector row (under the scale connector,
    centred); every other connector's parts sit under its own pins, with
    nothing between the module and the plugs.
    - Indicator panel under the module, top silk S P C S H P V: status, the
    three front-panel lamps (on the lamp GPIOs) and heater/pump/valve (on the
    gate drives), red KT-0603R + 1k, all basic (~$0.10 per board).
    - No mounting holes: heat-resistant velcro on the flat back (BUY #21).
    - Placement by hand; fastroute 0 unrouted, 89 vias; DRC 0; JLC gates pass
    (64 parts, 102 pin functions incl. every LED's polarity); sim 54/54.
    Co-Aut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
    [board.kicad_pcb, board.step, bom-120v.csv, bom.csv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]
2026-11-05 v28: thinner (73.2 x 19.6 mm), LED panel in the right-hand area
    The board now stops just below the module (velcro mount: no edge margin
    needed); the left-hand parts re-packed beside the module (LDO upright,
    power block beside it); the 7-LED indicator panel and its resistors moved
    into the open right-hand area. Placement by hand; fastroute 0 unrouted,
    93 vias; DRC 0 (incl. copper-to-edge); JLC gates pass (64 parts, 102 pin
    functions).
    [board.kicad_pcb, board.step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]
2026-11-05 docs/REVIEW-v28.md: independent pre-order review of v28 (no blockers; edge-rail note)
2026-11-05 v29: six GH connectors bundled by location (64.3 x 20 mm)
    3x 3-pin (5V in, pressure, NTC) + 3x 7-pin (SSRs, front, scale); the
    three outputs on one 7-pin lead, +5V daisy-chained through the SSR
    terminals. Placement by hand; fastroute 0 unrouted, 113 vias; DRC clean;
    JLC gates pass (62 placed, 102 pin functions, 5 extended types).
    Upload files: build/coffee-v29-{gerbers.zip,bom.csv,cpl.csv}.
    Independent review found 3 of 12 same-size mis-plugs hazardous
    (documented in docs/SWAP-SAFETY.md); label leads until re-pinned.
    [board.kicad_pcb, board.step, bom-120v.csv, bom.csv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]
2026-11-05 v30: re-pinned so every same-size mis-plug is harmless
    The v29 review found 3 of 12 swaps hazardous; the old checker tested
    each element alone and missed series paths through a lead's common.
    - swap_check.py rewritten: merges nodes through closed rockers,
    follows current through floating nodes and device diodes,
    enumerates rocker / per-output / per-lamp / SCK / powered states,
    models firmware standby (front lead out of J7); run by every
    controller.py build, which fails on any hazard
    - front-panel LEDs carry their own resistor (pre-wired 5 V LEDs)
    - scale from 3.3 V only (no 5 V on J10)
    - pinouts from an exhaustive search (420 x 420 x 1260 + 3-pin):
    J1 -/+5V/GND, J5 GND/-/NTC, J2 h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
    [board.kicad_pcb, board.step, bom-120v.csv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]
2026-11-05 v30 review fixes: OTA presence gate, no latched start, SCK high in standby
    Second independent review of v30: no hardware hazard. Fixed what it
    found outside the board (the v30 board files are unchanged):
    - OTA accepted only with the power rocker off and the steam rocker on
    (a LAN client could otherwise flash firmware without the gating)
    - StartBrew refused in standby and pending starts dropped there (a
    forced start sent while off fired the moment the rocker went on)
    - SCK held high in standby (HX711 powered down): harmless even with
    bare LEDs on a front lead in J10; swap_check --bare-leds passes
    - swap_check: SSR on from 1.0 V (current-based), stale-index bug,
    firmware NTC short thre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
    [bom-120v.csv]
2026-11-06 120 V / 60 Hz only; tune the engine and physics for the US 9 bar OPV
    - Delete the 230 V models; every scenario, tool and default runs the E24 120 V model.
    - Engine accepts mains_hz = 60 only; heater 1370 W (US nameplate 1425 W incl. pump).
    - Engine flow estimate subtracts the OPV's bleed (soft US OPV from ~7.7 bar), and
    duty_for_flow covers it: the pump works harder instead of starving the puck.
    - Physics: OPV backflow between strokes cancels the cold slug it pushed in (was
    counted in on every stroke and never out).
    - Brownout scenario sags 120 -> 102 V; worn-pump scenario expects ~7.5 bar at
    full duty against the 9 bar OPV. A-Flow grinds re-swept for 120 V.
    - 21/21 scenarios, all unit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
    [config.rs, engine.rs, lib.rs, machine.rs, main.rs, pump.rs]
2026-11-06 UI: ball-valve indicator and thicker pipes; coffee lamp off once a shot is done
2026-11-06 v31 board: K-type thermocouple front end (MCP3421 + TMP117 on I2C)
    - Thermistor input removed. M4 ungrounded K-type (Gaggiuino's probe) into J5;
    MCP3421 18-bit ADC with a 1k/1uF/1k filter and 10M open-probe bias; TMP117
    cold junction at J5's pads. I2C on GPIO8/9 (pull-ups double as straps).
    - J5 is a WAGO 2060 push-in terminal for now (to be replaced by a GH 2-pin).
    - Layout 74.75 x 20 mm, fastroute end to end: 0 unrouted, DRC clean; JLC pin
    check 115/115. versions/v31-thermocouple, build/coffee-v31-*.
    - Evidence store: thermocouple probes, TC readers, TMP117, WAGO.
    - Not orderable as is: superseded by v32 (mains section on board).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
    [C189895.json, C2765055.json, C29454.json, C699536.json, C7250.json, board.kicad_pcb, board.step, bom-120v.csv]
2026-11-06 v32 schematic: mains section on the board (pump + valve triacs, IRM-10-5), verified
    Electrical design only (layout next). Heater stays on its external SSR.
    - Mains: 4 FASTON tabs (N, L, P, 3 as Gaggiuino), Littelfuse 0443 2 A T fuse, Mean Well
    IRM-10-5 bridging the isolation band; per channel a MOC3083SR2M zero-cross opto-triac,
    330 R to MT2, 100 R + 22 nF X2 snubber. Pump T435-600B; valve T410-600B + 1k gate-MT1.
    - SPICE caught the valve: with a T435 (IH 35 mA) the coil's turn-off kick is 668-690 V,
    over 600 V; the T410 (IH 15 mA) gives 456 V worst case at 132 V. sim/run.py: 67/67,
    incl. opto LED current corners, snubbers, thermals at 70 C, thermocouple input.
    - SELV: J1/Q4 and the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
    [bom-120v.csv]
2026-11-06 v32 board: mains section laid out and routed, verified; full-assembly and SMD-only JLC order sets
    - Placement on a 2 mm mains grid: spades N/L/P/3 down the left edge, fuse, IRM-10-5 across the
    7 mm milled isolation band, pump/valve triac channels with stacked snubbers.
    - fastroute: 0 unrouted; KiCad DRC with the mains rules: clean (benign lib warnings only).
    - isolation_check.py: min mains-to-SELV copper 7.83 mm (limit 6).
    - JLC: every part's pads land (jlc_cpl), 126 pin functions match (jlc_pins: synonyms for triac
    A1/A2, IRM -V/+V, opto SUB; T410 uses the T435's identical record).
    - cost.py: 5 boards ~$180 fully assembled vs ~$170 SMD-only + hand-soldered spades/IRM.
    - Order files: bui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
    [C111561.json, C145128.json, C187538.json, C2857903.json, C437417.json, C4410.json, C575074.json, board.kicad_pcb]
2026-11-06 Docs for the v32 board: CIRCUIT, PARTS, INSTALL, HARDWARE, README, SWAP-SAFETY
    Mains section, isolation numbers, thermals, ordering (full vs SMD-only), tray and hole positions,
    thermocouple bring-up; SWAP-SAFETY trimmed to v32's one same-size pair. J6 note: 0-1.2 MPa
    (note text only, netlist unchanged).
    [bom-120v.csv]
2026-11-06 v33 board: R54 pump bleeder (review M1), re-routed and verified; REVIEW-v32.md
    The pump's series diode left the snubber cap at the line peak, so the zero-cross MOC3083 (VINH 20 V
    max) could never re-fire the pump triac after one stroke. R54, 100k Vishay CRCW2512 500 V across
    the triac, drains it each reverse half: 1.2 V at the next positive zero crossing (was 185 V).
    - sim/run.py: zero-cross re-arm check (v32 reference fails, v33 passes); 71/71.
    - fastroute 0 unrouted; DRC clean; isolation 7.83 mm; JLC pads and 126 pin functions match.
    - Order files build/coffee-v33-*, coffee-v33-smd-*; snapshot versions/v33-pump-bleeder.
    - 5 boards ~$184 full assembly vs ~$173 SMD-only + hand-soldered IRM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
    [C2077706.json, board.kicad_pcb, board.step, bom-120v.csv, bom.csv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]
2026-11-06 v33: R54 51k (was 100k): re-arm verified with the pump running every cycle
    Re-review: with the pump running every cycle the triac drops out ~243 deg into the cycle and the
    cap has ~5 ms to drain; 100k left 13 V, over the MOC3083's 12 V typical inhibit. 51k (Vishay
    CRCW251251K0JNEG, 500 V 1 W, C2078757) gives 1.8 V (5 V at 2.5x coil inductance). Value only:
    same footprint and position, copper and gerbers unchanged (value is on F.Fab). sim 79/79,
    DRC clean, isolation OK, JLC pads/pins match.
    [C2078757.json, board.kicad_pcb, bom-120v.csv, bom.csv, coffee-controller-120v.kicad_pcb, coffee-v33-bom.csv, coffee-v33-smd-bom.csv]
2026-11-06 REVIEW-v32: fuse land pattern cross-checked against JLC's footprint
2026-11-06 Thermocouple replaces the NTC across the stack (v32 board); 12 bar transducer
    - coffee-io: NIST ITS-90 type-K reference functions both ways (typek); SensorFrame carries the
    MCP3421 EMF (tc_uv, Some on the tick a 3.75 SPS conversion lands) and the TMP117 cold junction
    (cj_cc); wire protocol v3. Faults: PROBE_OPEN (>15 mV, the 10M bias gives ~90 mV open),
    PROBE_REVERSED (<-1.5 mV, latching), TC_ADC (no conversion for 1 s), COLD_JUNCTION (no in-range
    TMP117 reading for 2 s); all four turn the heater off.
    - core: ThermocoupleConfig (input gain 0.993, two-point cal, thresholds, 2.5 s probe lag),
    range-checked as a whole chain. The engine filters on conversions, not ticks, with a
    media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
    [config.rs, control.rs, diagram.rs, engine.rs, fit.rs, lib.rs, machine.rs]
2026-11-06 Software safety for the on-board triacs: stuck-pump detection, heater permit, pressure self-test
    - PUMP_STUCK_ON (latching): a shorted pump triac strokes whatever the engine says. With no stroke
    commanded for over 1 s: a rise of 2 bar within a second (a stroking pump takes the sealed boiler
    to the OPV in ~1 s; heat moves it ~0.05 bar/s), or, valve closed, above the OPV crack + 0.3 bar
    for 5 s (only a pump holds it there against the bleeding OPV: the mid-shot failure). Heater and
    valve off; the UI says to unplug (fault advice line for the faults software can't fix).
    - The heater bit comes only from heat::Heater::fire, which needs a heat::Permit; the only way to
    make one is heat::per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
    [config.rs, control.rs, engine.rs, lib.rs, machine.rs, wire.rs]
2026-11-06 v34 first pass: repacked 98x55.5 -> 89x54.5 (-11 %), routed, DRC clean, isolation 7.83 mm
    Channels moved to the left edge (two rows on the band), spades 3/P/L/N in a column beside the
    IRM's AC pins with F1, R54 and H1 beside them; band and SELV shifted 9 mm left, USB/LDO/LEDs in
    the corner by the IRM's DC end. Not promoted to build/ (v33 stays the order set) pending review.
    [board.kicad_pcb, board.step]
2026-11-06 v35 candidate: upright board laid out from scratch, 58x70 mm, routed, DRC clean, isolation 7.83 mm
    - Interfaces in fixed places: signal plugs on the top edge (J5 TC | J2 SSR | J7 front | J10 scale |
    J6 pressure), mains spades N L P 3 on the bottom edge, USB (recovery) on the right edge.
    - IRM-10-5 on the underside in the middle (the printed housing's anchor; hand-soldered); horizontal
    isolation band (layout.py band_axis y); optos straddle it with one mirrored column per channel.
    - Power rocker back to stock (switches all mains): its board input (R28/R29, GPIO14) removed.
    - Every lead a unique size: front panel GH 6-pin, scale GH 5-pin; swap_check derives same-size
    groups from the netli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
    [board.kicad_pcb, board.step]
2026-11-06 v35 firmware: power rocker is a mains switch again: no standby, new OTA gate
    - Removed the power-rocker input end to end: GPIO14 no longer read, input::STANDBY and
    EngineState::Standby deleted (from_u8(8) now reads as Fault), the engine's standby branch, the
    start-refused-while-off check, the SCK-high standby (Scale::sleep/wake), the standby test, the
    emulator's switch.power key and the API's power_switch field. Heater permit = no fault + valid
    temperature.
    - OTA gate (coffee_board::OtaGate, unit-tested): steam rocker on, then brew rocker on, held 3 s,
    with the pump and valve idle (in steam mode the brew rocker does nothing). 403 otherwise.
    - Power lamp: lit whenever the board runs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
    [control.rs, engine.rs, lib.rs, machine.rs, main.rs, net.rs, scale.rs]
2026-11-06 v35 promoted to build/: order files coffee-v35-* (full: JLC all but the underside IRM) and coffee-v35-smd-*
    JLC pads fit all 80 placed parts, 122 pin functions match; DRC clean, isolation 7.83 mm.
    5 boards: ~$181 full assembly vs ~$174 SMD-only (incl. the parts you solder).
    [C189896.json, bom-120v.csv, bom.csv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]
2026-11-06 v36: mains input L/N on the left edge, outputs P/3 on the bottom edge; 55.7x61 mm; order files coffee-v36-*
    Fuse beside L and the IRM's L pin, N straight to the IRM's N pin (18 mm, no vias; v35 34 mm),
    each output tab under its triac. 3398 mm2 (v35 4060, v33 5439). Bean back on the back, 20 mm.
    fastroute 0 unrouted in all variants; DRC clean; isolation 7.83 mm; JLC pads fit 80 parts,
    122 pin functions match. 5 boards ~$181 full / ~$174 SMD-only.
    [C155588.json, C2682586.json, C283473.json, board.kicad_pcb, board.step, bom-120v.csv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]
2026-11-07 v37: polish of v36: parts ordered like the pins they serve; order files coffee-v37-*
    J7 lamp/switch resistors, pressure divider and SCK pull-down under their pins; LED row in the
    module's pin order (V P H | P C S | S); thermocouple filter column beside the MCP3421's inputs;
    fuse turned and the pump bleeder beside its triac (straight live trunk, N straight on top).
    Tracks 1453 -> 1305 mm, bends 502 -> 408, off-centre pad entries 82 -> 51. DRC clean,
    isolation 7.83 mm, JLC pads/pins match. Same size (55.7 x 61) and price.
    [board.kicad_pcb, board.step, bom-120v.csv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]
2026-11-07 v38 slide-in: all parts on the front, magnet holder, thermocouple screw terminal; order files coffee-v38-*
    Board (80 x 77 mm, plan_v38_make.py):
    - IRM-10-5 moved to the front face: the back is flat (pin tails only), so the board slides into a
    flat printed holder; JLC now assembles everything (0 hand-solder lines in the full order).
    - 2.5 mm side strips clear of parts for the holder's grooves.
    - Low-voltage plugs and the thermocouple terminal on the top edge, all four spades on the bottom
    edge: low-voltage leads leave up, mains down. Band across the middle, IRM straddling it.
    - J5 thermocouple: Phoenix MKDS 1,5/2-5,08 screw terminal (C5183929), was GH 2-pin.
    - Review fixes (docs/REVIEW-v3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
    [C5183929.json, board.kicad_pcb, board.step, bom-120v.csv, bom.csv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]
2026-11-07 v39 front plate: board turned for the front-plate holder; independent review; docs for v39; order files coffee-v39-*
    Board (plan_v39_make.py): v38 turned 180 degrees so the mains spades sit along the top edge and the
    low-voltage plugs, USB-C and the thermocouple screw terminal along the bottom; the terminal ends up in
    the bottom-right corner, below every heat source on the vertical board. Regulator U5 moved beside the
    module; TMP117 centred on the terminal's pins; J5 1.7 mm in so it clears the groove strip. DRC clean,
    isolation 7.83 mm, side strips clear, straight 0.8 mm live trunk, 81 parts on JLC's pads, 126 pin
    functions match, swap check harmless.
    Holder (hardware/holder): back plate +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
    [board.kicad_pcb, board.step, bom-120v.csv, bom.csv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]
2026-11-07 README: v39 board, holder, OTA gate, unique lead sizes
2026-11-09 versions/v39-front-plate/holder: the version's own print files (holder + bar STL/STEP, README snapshot)
    [holder.step, holder.stl, holder_bar.step, holder_bar.stl]
2026-11-09 v40 roof holder: user's design: roof off the back plate, solid front wall, wires out a forward slot; board in from below on pegs
    Board unchanged (v39; order files coffee-v39-*). Holder (hardware/holder/holder.py), from the user's sketch:
    - the back plate rises into a roof that overhangs the front wall by 7.5 mm, so drips from above run off
    outside; the only top-end opening is a forward-facing wire slot (Y 66-88) under the roof;
    - a deep solid front wall (44.5 mm off the panel) covers the whole board: no LED window, comb or channel;
    the receptacles sit inside, the mains wires leave straight out of the slot;
    - the board slides up from below into the side grooves and a channel over its top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
    [board.kicad_pcb, holder.step, holder.stl, holder_bar.step, holder_bar.stl, holder_peg.step, holder_peg.stl]
2026-11-09 v42 bar cover: frame + drop-on cover + two cross bars; straight receptacles under a solid roof (board = v39)
    From the user's critique of the rod-and-slot version: rods pointing out of the wall could fall forward, and slots
    in the roof defeated it. Now a frame on the wall (back plate, grooves, top channel, solid roof just above the
    board, ears at top and bottom) holds the board; straight receptacles push straight onto the spades and stick out
    under the roof; a cover shaped to the board (17 mm off the panel over the low parts, 26 over the terminal, 34 over
    the supply and its top band, 45-degree steps) goes on from the front; two bars slide across the full width through
    the ears to lock it, and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
    [board.kicad_pcb, holder.step, holder.stl, holder_bars.step, holder_bars.stl, holder_cover.step, holder_cover.stl, holder_frame.step]
2026-11-09 v43 bar cover: the cover's two fingers are joined to it (they floated in v42); check every printed part is one solid body
    Each finger is a wedge from the cover's front wall back under the board with a 45-degree underside. Board = v39.
    [board.kicad_pcb, holder_bars.step, holder_bars.stl, holder_cover.step, holder_cover.stl, holder_frame.step, holder_frame.stl]
2026-11-09 v44 flat recess: board narrowed to 71.2 x 77; holder redone: board flat in a recess under a lip, struts straight from the sides, one boss presses it back; review fixes; order files coffee-v44-*
    [board.kicad_pcb, board.step, bom-120v.csv, bom.csv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]
2026-11-09 v45 closed top: supply moved 3.8 mm so the cover closes over it; printed spring finger holds the board flat, ramped bars push the cover back; order files coffee-v45-*
    [board.kicad_pcb, board.step, bom-120v.csv, bom.csv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]
2026-11-09 v46 magnet grid: holder's magnets on a straight 3 x 3 grid less the two behind the supply (seven, was six); board = v45
    [board.kicad_pcb, holder_bars.step, holder_bars.stl, holder_bars_assembled.stl, holder_cover.step, holder_cover.stl, holder_frame.step, holder_frame.stl]
2026-11-09 v47 cover seated: cover rim lands on the frame, bars braced against the front of their holes; board = v45
    [board.kicad_pcb, holder_bars.step, holder_bars.stl, holder_bars_assembled.stl, holder_cover.step, holder_cover.stl, holder_frame.step, holder_frame.stl]
2026-11-09 v48 strut walls: top struts run back into the roof as side walls, gussets at the bottom struts; brim and enclosure in the print notes; board = v45
    [board.kicad_pcb, holder_bars.step, holder_bars.stl, holder_bars_assembled.stl, holder_cover.step, holder_cover.stl, holder_frame.step, holder_frame.stl]
2026-11-12 v49 valve 800 V: valve triac T410-800B (unmeasured coil can kick past the 600 V part), opto resistors R49/R50 200 ohm (valve re-fires with less voltage); layout = v45; order files coffee-v49-*
    [C155606.json, C18002.json, board.kicad_pcb, bom-120v.csv, bom.csv, coffee-controller-120v.kicad_pcb, coffee-v49-bom.csv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]
